RolandMueller1994/ControllerV2/PSU_Prozessor/PSU_Prozessor.csv

Source: | D:\Privat\Circuit_Design\ControllerV2\PSU_Prozessor\PSU_Prozessor.kicad_sch
Date: | 26/09/2022 08:59:41
Tool: | Eeschema (6.0.4)
Generator: | C:\Program Files\KiCad\6.0\bin\scripting\plugins/bom_csv_grouped_by_value.py
Component Count: | 85
Individual Components:
Item | Qty | Reference(s) | Value | LibPart | Footprint | Datasheet | Arrow Part Number | Arrow Price/Stock | Description | Height | Manufacturer_Name | Manufacturer_Part_Number | Mouser Part Number | Mouser Price/Stock
 |  | C1 | 1u | Device:C | Capacitor_SMD:C_1206_3216Metric_Pad1.33x1.80mm_HandSolder | ~
 |  | C2 | 100n | Device:C | Capacitor_SMD:C_1206_3216Metric_Pad1.33x1.80mm_HandSolder | ~
 |  | C3 | 100n | Device:C | Capacitor_SMD:C_1206_3216Metric_Pad1.33x1.80mm_HandSolder | ~
 |  | C4 | 200u | Device:C_Polarized | Capacitor_SMD:CP_Elec_10x10 | ~
 |  | C5 | 2.2u | Device:C | Capacitor_SMD:C_1206_3216Metric_Pad1.33x1.80mm_HandSolder | ~
 |  | C6 | 100n | Device:C | Capacitor_SMD:C_1206_3216Metric_Pad1.33x1.80mm_HandSolder | ~
 |  | C7 | 1u | Device:C | Capacitor_SMD:C_1206_3216Metric_Pad1.33x1.80mm_HandSolder | ~
 |  | C8 | 10u | Device:C | Capacitor_SMD:C_1206_3216Metric_Pad1.33x1.80mm_HandSolder | ~
 |  | C9 | 22u | Device:C | Capacitor_SMD:C_1206_3216Metric_Pad1.33x1.80mm_HandSolder | ~
 |  | C10 | 10u | Device:C | Capacitor_SMD:C_1206_3216Metric_Pad1.33x1.80mm_HandSolder | ~
 |  | C11 | 22u | Device:C | Capacitor_SMD:C_1206_3216Metric_Pad1.33x1.80mm_HandSolder | ~
 |  | C12 | 22u | Device:C | Capacitor_SMD:C_1206_3216Metric_Pad1.33x1.80mm_HandSolder | ~
 |  | C13 | 22u | Device:C | Capacitor_SMD:C_1206_3216Metric_Pad1.33x1.80mm_HandSolder | ~
 |  | C14 | 47u | Device:C_Polarized | Capacitor_SMD:CP_Elec_8x10.5 | ~
 |  | C15 | 100n | Device:C | Capacitor_SMD:C_1206_3216Metric_Pad1.33x1.80mm_HandSolder | ~
 |  | C16 | 150p | Device:C | Capacitor_SMD:C_1206_3216Metric_Pad1.33x1.80mm_HandSolder | ~
 |  | C17 | 47u | Device:C_Polarized | Capacitor_SMD:CP_Elec_8x10.5 | ~
 |  | C18 | 100n | Device:C | Capacitor_SMD:C_1206_3216Metric_Pad1.33x1.80mm_HandSolder | ~
 |  | C19 | 100n | Device:C | Capacitor_SMD:C_1206_3216Metric_Pad1.33x1.80mm_HandSolder | ~
 |  | C20 | 100n | Device:C | Capacitor_SMD:C_1206_3216Metric_Pad1.33x1.80mm_HandSolder | ~
 |  | C21 | 100n | Device:C | Capacitor_SMD:C_1206_3216Metric_Pad1.33x1.80mm_HandSolder | ~
 |  | C22 | 100n | Device:C | Capacitor_SMD:C_1206_3216Metric_Pad1.33x1.80mm_HandSolder | ~
 |  | C23 | 100n | Device:C | Capacitor_SMD:C_1206_3216Metric_Pad1.33x1.80mm_HandSolder | ~
 |  | C24 | 100n | Device:C | Capacitor_SMD:C_1206_3216Metric_Pad1.33x1.80mm_HandSolder | ~
 |  | C25 | 1u | Device:C | Capacitor_SMD:C_1206_3216Metric_Pad1.33x1.80mm_HandSolder | ~
 |  | C26 | 100n | Device:C | Capacitor_SMD:C_1206_3216Metric_Pad1.33x1.80mm_HandSolder | ~
 |  | C27 | 100n | Device:C | Capacitor_SMD:C_1206_3216Metric_Pad1.33x1.80mm_HandSolder | ~
 |  | D1 | 1N4001 | Diode:1N4001 | Diode_THT:D_DO-41_SOD81_P10.16mm_Horizontal | http://www.vishay.com/docs/88503/1n4001.pdf
 |  | D2 | 1N4148 | Diode:1N4148 | Diode_SMD:D_SOD-123 | https://assets.nexperia.com/documents/data-sheet/1N4148_1N4448.pdf
 |  | H1 | MountingHole | Mechanical:MountingHole | MountingHole:MountingHole_3.2mm_M3 | ~
 |  | H2 | MountingHole | Mechanical:MountingHole | MountingHole:MountingHole_3.2mm_M3 | ~
 |  | H3 | MountingHole | Mechanical:MountingHole | MountingHole:MountingHole_3.2mm_M3 | ~
 |  | H4 | MountingHole | Mechanical:MountingHole | MountingHole:MountingHole_3.2mm_M3 | ~
 |  | H5 | MountingHole | Mechanical:MountingHole | MountingHole:MountingHole_3.2mm_M3 | ~
 |  | IC1 | 6N138S | SamacSys_Parts:6N138S | SamacSys_Parts:SOP254P1016X460-8N | https://media.digikey.com/pdf/Data%20Sheets/Lite-On%20PDFs/6N138-39%20Series.pdf | 6N138S | https://www.arrow.com/en/products/6n138s/lite-on-technology?region=nac | High Speed Optocouplers Darlington 100KBd Transistor Output | 4.6 | Lite-On | 6N138S | 859-6N138S | https://www.mouser.co.uk/ProductDetail/Lite-On/6N138S?qs=PByDJ0nQNwpiJNZ8Mk8Kdw%3D%3D
 |  | J1 | ACJS-MHOP | SamacSys_Parts:ACJS-MHOP | SamacSys_Parts:ACJSMHOP | https://www.mouser.dk/datasheet/2/18/55010542000111_acjx-xhop-771297.pdf | ACJS-MHOP | https://www.arrow.com/en/products/acjs-mhop/amphenol-sine-systems?region=nac | 1/4" PHONE TRS OFFSET HORZ PCB P | 12.8 | Amphenol | ACJS-MHOP | 523-ACJS-MHOP | https://www.mouser.co.uk/ProductDetail/Amphenol-Audio/ACJS-MHOP?qs=t8VhaDIDl4taHvIs0dnb2w%3D%3D
 |  | J3 | FC68148S | SamacSys_Parts:FC68148S | FC68148S_2 | http://www.cliffuk.co.uk/products/dcconnectors/FC68148S.pdf |  |  | CLIFF ELECTRONIC COMPONENTS - FC68148S - DC SOCKET, SMD, DC-10AS, 2.1MM PIN |  | CLIFF ELECTRONIC COMPONENTS | FC68148S
 |  | J4 | 1734327-2 | SamacSys_Parts:1734327-2 | SamacSys_Parts:17343272 | https://www.te.com/commerce/DocumentDelivery/DDEController?Action=srchrtrv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 | 1734327-2 | https://www.arrow.com/en/products/1734327-2/te-connectivity?region=nac | USB Connectors Mini A R/A Rcpt SMT | 4.14 | TE Connectivity | 1734327-2 | 571-1734327-2 | https://www.mouser.co.uk/ProductDetail/TE-Connectivity/1734327-2?qs=MP5IOa7hLjVR6N4sgEE7xA%3D%3D
 |  | J7 | 1734327-2 | SamacSys_Parts:1734327-2 | SamacSys_Parts:17343272 | https://www.te.com/commerce/DocumentDelivery/DDEController?Action=srchrtrv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 | 1734327-2 | https://www.arrow.com/en/products/1734327-2/te-connectivity?region=nac | USB Connectors Mini A R/A Rcpt SMT | 4.14 | TE Connectivity | 1734327-2 | 571-1734327-2 | https://www.mouser.co.uk/ProductDetail/TE-Connectivity/1734327-2?qs=MP5IOa7hLjVR6N4sgEE7xA%3D%3D
 |  | J_Display1 | Conn_01x08 | Connector_Generic:Conn_01x08 | Connector_JST:JST_PH_B8B-PH-K_1x08_P2.00mm_Vertical | ~
 |  | J_In1 | SJ-3524-SMT-TR | SamacSys_Parts:SJ-3524-SMT-TR | SamacSys_Parts:SJ-3524-SMT-TR | https://datasheet.datasheetarchive.com/originals/distributors/Datasheets-DGA1/151896.pdf | SJ-3524-SMT-TR | https://www.arrow.com/en/products/sj-3524-smt-tr/cui-devices?region=nac | Phone Connectors Audio Jacks |  | CUI Inc. | SJ-3524-SMT-TR | 490-SJ-3524-SMT-TR | https://www.mouser.co.uk/ProductDetail/CUI-Devices/SJ-3524-SMT-TR?qs=WyjlAZoYn50%252B7OcNbxvx%252BA%3D%3D
 |  | J_Main_Data1 | Conn_01x10 | Connector_Generic:Conn_01x10 | Connector_JST:JST_PH_B10B-PH-K_1x10_P2.00mm_Vertical | ~
 |  | J_Main_Expr1 | Conn_01x02 | Connector_Generic:Conn_01x02 | Connector_JST:JST_PH_B2B-PH-K_1x02_P2.00mm_Vertical | ~
 |  | J_Main_PS1 | Conn_01x06 | Connector_Generic:Conn_01x06 | Connector_JST:JST_PH_B6B-PH-K_1x06_P2.00mm_Vertical | ~
 |  | J_Out1 | SJ-3524-SMT-TR | SamacSys_Parts:SJ-3524-SMT-TR | SamacSys_Parts:SJ-3524-SMT-TR | https://datasheet.datasheetarchive.com/originals/distributors/Datasheets-DGA1/151896.pdf | SJ-3524-SMT-TR | https://www.arrow.com/en/products/sj-3524-smt-tr/cui-devices?region=nac | Phone Connectors Audio Jacks |  | CUI Inc. | SJ-3524-SMT-TR | 490-SJ-3524-SMT-TR | https://www.mouser.co.uk/ProductDetail/CUI-Devices/SJ-3524-SMT-TR?qs=WyjlAZoYn50%252B7OcNbxvx%252BA%3D%3D
 |  | J_Status1 | Conn_01x08 | Connector_Generic:Conn_01x08 | Connector_JST:JST_PH_B8B-PH-K_1x08_P2.00mm_Vertical | ~
 |  | J_Swtich_Lower1 | Conn_01x08 | Connector_Generic:Conn_01x08 | Connector_JST:JST_PH_B8B-PH-K_1x08_P2.00mm_Vertical | ~
 |  | J_Swtich_Lower2 | Conn_01x08 | Connector_Generic:Conn_01x08 | Connector_JST:JST_PH_B8B-PH-K_1x08_P2.00mm_Vertical | ~
 |  | J_Swtich_Upper1 | Conn_01x08 | Connector_Generic:Conn_01x08 | Connector_JST:JST_PH_B8B-PH-K_1x08_P2.00mm_Vertical | ~
 |  | J_Swtich_Upper2 | Conn_01x08 | Connector_Generic:Conn_01x08 | Connector_JST:JST_PH_B8B-PH-K_1x08_P2.00mm_Vertical | ~
 |  | L1 | TCK-146 | SamacSys_Parts:TCK-146 | SamacSys_Parts:TCK147 | https://www.tracopower.com/products/tck146.pdf |  |  | Fixed Inductors Inductor 10uH 1A 350mOhm | 2.6 | Traco Power | TCK-146 | 495-TCK-146 | https://www.mouser.co.uk/ProductDetail/TRACO-Power/TCK-146?qs=w%2Fv1CP2dgqpsTXHMfkVpwg%3D%3D
 |  | L2 | TCK-151 | SamacSys_Parts:TCK-151 | SamacSys_Parts:TCK151 | https://altium.componentsearchengine.com/Datasheets/1/TCK-151.pdf |  |  | Fixed Inductors Inductor 4.7uH 1.2A 140mOhm | 2.6 | Traco Power | TCK-151 | 495-TCK-151 | https://www.mouser.co.uk/ProductDetail/TRACO-Power/TCK-151?qs=r5DSvlrkXmLbmcys%252BIu%252BuA%3D%3D
 |  | MEM1 | Adafruit_Fram_2M | FRam:Adafruit_Fram_2M | FRam:Adafruit_FRam_2M
 |  | PS1 | TRS_2-0923 | SamacSys_Parts:TRS_2-0923 | SamacSys_Parts:TRS20922 | https://tracopower.com/trs2-datasheet/ |  |  | 2 Watt DC/DC converter, industrial, 2:1 input, regulated, compact design, 1600 VDC isolation, encapsulated, SMD package | 8 | Traco Power | TRS 2-0923 | 495-TRS2-0923 | https://www.mouser.co.uk/ProductDetail/TRACO-Power/TRS-2-0923?qs=wUXugUrL1qxaEmb8ePg7Ow%3D%3D
 |  | PS2 | LMO78_05-0.5 | SamacSys_Parts:LMO78_05-0.5 | SamacSys_Parts:LMO78_0505 | https://gaptec-electronic.com/datenblaetter/LMO78_0.5.pdf |  |  | DC DC CONVERTER 5V 4W | 11.5 | Gaptec | LMO78_05-0.5
 |  | PS3 | LMO78_03-0.5 | SamacSys_Parts:LMO78_05-0.5 | SamacSys_Parts:LMO78_0505 | https://gaptec-electronic.com/datenblaetter/LMO78_0.5.pdf |  |  | DC DC CONVERTER 5V 4W | 11.5 | Gaptec | LMO78_05-0.5
 |  | Q1 | BC847 | Transistor_BJT:BC847 | Package_TO_SOT_SMD:SOT-23 | http://www.infineon.com/dgdl/Infineon-BC847SERIES_BC848SERIES_BC849SERIES_BC850SERIES-DS-v01_01-en.pdf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
 |  | Q2 | 2N7002 | Transistor_FET:2N7002 | Package_TO_SOT_SMD:SOT-23 | https://www.onsemi.com/pub/Collateral/NDS7002A-D.PDF
 |  | Q3 | BC847 | Transistor_BJT:BC847 | Package_TO_SOT_SMD:SOT-23 | http://www.infineon.com/dgdl/Infineon-BC847SERIES_BC848SERIES_BC849SERIES_BC850SERIES-DS-v01_01-en.pdf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
 |  | Q4 | 2N7002 | Transistor_FET:2N7002 | Package_TO_SOT_SMD:SOT-23 | https://www.onsemi.com/pub/Collateral/NDS7002A-D.PDF
 |  | Q5 | BC847 | Transistor_BJT:BC847 | Package_TO_SOT_SMD:SOT-23 | http://www.infineon.com/dgdl/Infineon-BC847SERIES_BC848SERIES_BC849SERIES_BC850SERIES-DS-v01_01-en.pdf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
 |  | Q6 | 2N7002 | Transistor_FET:2N7002 | Package_TO_SOT_SMD:SOT-23 | https://www.onsemi.com/pub/Collateral/NDS7002A-D.PDF
 |  | R1 | 33k | Device:R | Resistor_SMD:R_1206_3216Metric_Pad1.30x1.75mm_HandSolder | ~
 |  | R2 | 330 | Device:R | Resistor_SMD:R_1206_3216Metric_Pad1.30x1.75mm_HandSolder | ~
 |  | R3 | 33 | Device:R | Resistor_SMD:R_1206_3216Metric_Pad1.30x1.75mm_HandSolder | ~
 |  | R4 | 10k | Device:R | Resistor_SMD:R_1206_3216Metric_Pad1.30x1.75mm_HandSolder | ~
 |  | R5 | 10 | Device:R | Resistor_SMD:R_1206_3216Metric_Pad1.30x1.75mm_HandSolder | ~
 |  | R6 | 33k | Device:R | Resistor_SMD:R_1206_3216Metric_Pad1.30x1.75mm_HandSolder | ~
 |  | R7 | 330 | Device:R | Resistor_SMD:R_1206_3216Metric_Pad1.30x1.75mm_HandSolder | ~
 |  | R8 | 10k | Device:R | Resistor_SMD:R_1206_3216Metric_Pad1.30x1.75mm_HandSolder | ~
 |  | R9 | 470 | Device:R | Resistor_SMD:R_1206_3216Metric_Pad1.30x1.75mm_HandSolder | ~
 |  | R10 | 33 | Device:R | Resistor_SMD:R_1206_3216Metric_Pad1.30x1.75mm_HandSolder | ~
 |  | R11 | 1k | Device:R | Resistor_SMD:R_1206_3216Metric_Pad1.30x1.75mm_HandSolder | ~
 |  | R12 | 100k | Device:R | Resistor_SMD:R_1206_3216Metric_Pad1.30x1.75mm_HandSolder | ~
 |  | R13 | 100k | Device:R | Resistor_SMD:R_1206_3216Metric_Pad1.30x1.75mm_HandSolder | ~
 |  | R14 | 1k | Device:R | Resistor_SMD:R_1206_3216Metric_Pad1.30x1.75mm_HandSolder | ~
 |  | R15 | 1k | Device:R | Resistor_SMD:R_1206_3216Metric_Pad1.30x1.75mm_HandSolder | ~
 |  | R16 | 33k | Device:R | Resistor_SMD:R_1206_3216Metric_Pad1.30x1.75mm_HandSolder | ~
 |  | R17 | 330 | Device:R | Resistor_SMD:R_1206_3216Metric_Pad1.30x1.75mm_HandSolder | ~
 |  | R18 | 10k | Device:R | Resistor_SMD:R_1206_3216Metric_Pad1.30x1.75mm_HandSolder | ~
 |  | R19 | 100 | Device:R | Resistor_THT:R_Axial_DIN0414_L11.9mm_D4.5mm_P15.24mm_Horizontal | ~
 |  | R20 | 66 | Device:R | Resistor_THT:R_Axial_DIN0414_L11.9mm_D4.5mm_P15.24mm_Horizontal | ~
 |  | U1 | TL072 | Amplifier_Operational:TL072 | SamacSys_Parts:SOIC127P600X175-8N | http://www.ti.com/lit/ds/symlink/tl071.pdf
 |  | U2 | TL072 | Amplifier_Operational:TL072 | SamacSys_Parts:SOIC127P600X175-8N | http://www.ti.com/lit/ds/symlink/tl071.pdf
 |  | XA1 | Arduino_Due_Shield | arduino:Arduino_Due_Shield | Arduino:Arduino_Due_Shield
Collated Components:
Item | Qty | Reference(s) | Value | LibPart | Footprint | Datasheet | Arrow Part Number | Arrow Price/Stock | Description | Height | Manufacturer_Name | Manufacturer_Part_Number | Mouser Part Number | Mouser Price/Stock
1 | 3 | C1, C7, C25 | 1u | Device:C | Capacitor_SMD:C_1206_3216Metric_Pad1.33x1.80mm_HandSolder | ~
2 | 13 | C2, C3, C6, C15, C18, C19, C20, C21, C22, C23, C24, C26, C27 | 100n | Device:C | Capacitor_SMD:C_1206_3216Metric_Pad1.33x1.80mm_HandSolder | ~
3 | 1 | C4 | 200u | Device:C_Polarized | Capacitor_SMD:CP_Elec_10x10 | ~
4 | 1 | C5 | 2.2u | Device:C | Capacitor_SMD:C_1206_3216Metric_Pad1.33x1.80mm_HandSolder | ~
5 | 2 | C8, C10 | 10u | Device:C | Capacitor_SMD:C_1206_3216Metric_Pad1.33x1.80mm_HandSolder | ~
6 | 4 | C9, C11, C12, C13 | 22u | Device:C | Capacitor_SMD:C_1206_3216Metric_Pad1.33x1.80mm_HandSolder | ~
7 | 2 | C14, C17 | 47u | Device:C_Polarized | Capacitor_SMD:CP_Elec_8x10.5 | ~
8 | 1 | C16 | 150p | Device:C | Capacitor_SMD:C_1206_3216Metric_Pad1.33x1.80mm_HandSolder | ~
9 | 1 | D1 | 1N4001 | Diode:1N4001 | Diode_THT:D_DO-41_SOD81_P10.16mm_Horizontal | http://www.vishay.com/docs/88503/1n4001.pdf
10 | 1 | D2 | 1N4148 | Diode:1N4148 | Diode_SMD:D_SOD-123 | https://assets.nexperia.com/documents/data-sheet/1N4148_1N4448.pdf
11 | 5 | H1, H2, H3, H4, H5 | MountingHole | Mechanical:MountingHole | MountingHole:MountingHole_3.2mm_M3 | ~
12 | 1 | IC1 | 6N138S | SamacSys_Parts:6N138S | SamacSys_Parts:SOP254P1016X460-8N | https://media.digikey.com/pdf/Data%20Sheets/Lite-On%20PDFs/6N138-39%20Series.pdf | 6N138S | https://www.arrow.com/en/products/6n138s/lite-on-technology?region=nac | High Speed Optocouplers Darlington 100KBd Transistor Output | 4.6 | Lite-On | 6N138S | 859-6N138S | https://www.mouser.co.uk/ProductDetail/Lite-On/6N138S?qs=PByDJ0nQNwpiJNZ8Mk8Kdw%3D%3D
13 | 1 | J1 | ACJS-MHOP | SamacSys_Parts:ACJS-MHOP | SamacSys_Parts:ACJSMHOP | https://www.mouser.dk/datasheet/2/18/55010542000111_acjx-xhop-771297.pdf | ACJS-MHOP | https://www.arrow.com/en/products/acjs-mhop/amphenol-sine-systems?region=nac | 1/4" PHONE TRS OFFSET HORZ PCB P | 12.8 | Amphenol | ACJS-MHOP | 523-ACJS-MHOP | https://www.mouser.co.uk/ProductDetail/Amphenol-Audio/ACJS-MHOP?qs=t8VhaDIDl4taHvIs0dnb2w%3D%3D
14 | 1 | J3 | FC68148S | SamacSys_Parts:FC68148S | FC68148S_2 | http://www.cliffuk.co.uk/products/dcconnectors/FC68148S.pdf |  |  | CLIFF ELECTRONIC COMPONENTS - FC68148S - DC SOCKET, SMD, DC-10AS, 2.1MM PIN |  | CLIFF ELECTRONIC COMPONENTS | FC68148S
15 | 2 | J4, J7 | 1734327-2 | SamacSys_Parts:1734327-2 | SamacSys_Parts:17343272 | https://www.te.com/commerce/DocumentDelivery/DDEController?Action=srchrtrv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 | 1734327-2 | https://www.arrow.com/en/products/1734327-2/te-connectivity?region=nac | USB Connectors Mini A R/A Rcpt SMT | 4.14 | TE Connectivity | 1734327-2 | 571-1734327-2 | https://www.mouser.co.uk/ProductDetail/TE-Connectivity/1734327-2?qs=MP5IOa7hLjVR6N4sgEE7xA%3D%3D
16 | 6 | J_Display1, J_Status1, J_Swtich_Lower1, J_Swtich_Lower2, J_Swtich_Upper1, J_Swtich_Upper2 | Conn_01x08 | Connector_Generic:Conn_01x08 | Connector_JST:JST_PH_B8B-PH-K_1x08_P2.00mm_Vertical | ~
17 | 2 | J_In1, J_Out1 | SJ-3524-SMT-TR | SamacSys_Parts:SJ-3524-SMT-TR | SamacSys_Parts:SJ-3524-SMT-TR | https://datasheet.datasheetarchive.com/originals/distributors/Datasheets-DGA1/151896.pdf | SJ-3524-SMT-TR | https://www.arrow.com/en/products/sj-3524-smt-tr/cui-devices?region=nac | Phone Connectors Audio Jacks |  | CUI Inc. | SJ-3524-SMT-TR | 490-SJ-3524-SMT-TR | https://www.mouser.co.uk/ProductDetail/CUI-Devices/SJ-3524-SMT-TR?qs=WyjlAZoYn50%252B7OcNbxvx%252BA%3D%3D
18 | 1 | J_Main_Data1 | Conn_01x10 | Connector_Generic:Conn_01x10 | Connector_JST:JST_PH_B10B-PH-K_1x10_P2.00mm_Vertical | ~
19 | 1 | J_Main_Expr1 | Conn_01x02 | Connector_Generic:Conn_01x02 | Connector_JST:JST_PH_B2B-PH-K_1x02_P2.00mm_Vertical | ~
20 | 1 | J_Main_PS1 | Conn_01x06 | Connector_Generic:Conn_01x06 | Connector_JST:JST_PH_B6B-PH-K_1x06_P2.00mm_Vertical | ~
21 | 1 | L1 | TCK-146 | SamacSys_Parts:TCK-146 | SamacSys_Parts:TCK147 | https://www.tracopower.com/products/tck146.pdf |  |  | Fixed Inductors Inductor 10uH 1A 350mOhm | 2.6 | Traco Power | TCK-146 | 495-TCK-146 | https://www.mouser.co.uk/ProductDetail/TRACO-Power/TCK-146?qs=w%2Fv1CP2dgqpsTXHMfkVpwg%3D%3D
22 | 1 | L2 | TCK-151 | SamacSys_Parts:TCK-151 | SamacSys_Parts:TCK151 | https://altium.componentsearchengine.com/Datasheets/1/TCK-151.pdf |  |  | Fixed Inductors Inductor 4.7uH 1.2A 140mOhm | 2.6 | Traco Power | TCK-151 | 495-TCK-151 | https://www.mouser.co.uk/ProductDetail/TRACO-Power/TCK-151?qs=r5DSvlrkXmLbmcys%252BIu%252BuA%3D%3D
23 | 1 | MEM1 | Adafruit_Fram_2M | FRam:Adafruit_Fram_2M | FRam:Adafruit_FRam_2M
24 | 1 | PS1 | TRS_2-0923 | SamacSys_Parts:TRS_2-0923 | SamacSys_Parts:TRS20922 | https://tracopower.com/trs2-datasheet/ |  |  | 2 Watt DC/DC converter, industrial, 2:1 input, regulated, compact design, 1600 VDC isolation, encapsulated, SMD package | 8 | Traco Power | TRS 2-0923 | 495-TRS2-0923 | https://www.mouser.co.uk/ProductDetail/TRACO-Power/TRS-2-0923?qs=wUXugUrL1qxaEmb8ePg7Ow%3D%3D
25 | 1 | PS2 | LMO78_05-0.5 | SamacSys_Parts:LMO78_05-0.5 | SamacSys_Parts:LMO78_0505 | https://gaptec-electronic.com/datenblaetter/LMO78_0.5.pdf |  |  | DC DC CONVERTER 5V 4W | 11.5 | Gaptec | LMO78_05-0.5
26 | 1 | PS3 | LMO78_03-0.5 | SamacSys_Parts:LMO78_05-0.5 | SamacSys_Parts:LMO78_0505 | https://gaptec-electronic.com/datenblaetter/LMO78_0.5.pdf |  |  | DC DC CONVERTER 5V 4W | 11.5 | Gaptec | LMO78_05-0.5
27 | 3 | Q1, Q3, Q5 | BC847 | Transistor_BJT:BC847 | Package_TO_SOT_SMD:SOT-23 | http://www.infineon.com/dgdl/Infineon-BC847SERIES_BC848SERIES_BC849SERIES_BC850SERIES-DS-v01_01-en.pdf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
28 | 3 | Q2, Q4, Q6 | 2N7002 | Transistor_FET:2N7002 | Package_TO_SOT_SMD:SOT-23 | https://www.onsemi.com/pub/Collateral/NDS7002A-D.PDF
29 | 3 | R1, R6, R16 | 33k | Device:R | Resistor_SMD:R_1206_3216Metric_Pad1.30x1.75mm_HandSolder | ~
30 | 3 | R2, R7, R17 | 330 | Device:R | Resistor_SMD:R_1206_3216Metric_Pad1.30x1.75mm_HandSolder | ~
31 | 2 | R3, R10 | 33 | Device:R | Resistor_SMD:R_1206_3216Metric_Pad1.30x1.75mm_HandSolder | ~
32 | 3 | R4, R8, R18 | 10k | Device:R | Resistor_SMD:R_1206_3216Metric_Pad1.30x1.75mm_HandSolder | ~
33 | 1 | R5 | 10 | Device:R | Resistor_SMD:R_1206_3216Metric_Pad1.30x1.75mm_HandSolder | ~
34 | 1 | R9 | 470 | Device:R | Resistor_SMD:R_1206_3216Metric_Pad1.30x1.75mm_HandSolder | ~
35 | 3 | R11, R14, R15 | 1k | Device:R | Resistor_SMD:R_1206_3216Metric_Pad1.30x1.75mm_HandSolder | ~
36 | 2 | R12, R13 | 100k | Device:R | Resistor_SMD:R_1206_3216Metric_Pad1.30x1.75mm_HandSolder | ~
37 | 1 | R19 | 100 | Device:R | Resistor_THT:R_Axial_DIN0414_L11.9mm_D4.5mm_P15.24mm_Horizontal | ~
38 | 1 | R20 | 66 | Device:R | Resistor_THT:R_Axial_DIN0414_L11.9mm_D4.5mm_P15.24mm_Horizontal | ~
39 | 2 | U1, U2 | TL072 | Amplifier_Operational:TL072 | SamacSys_Parts:SOIC127P600X175-8N | http://www.ti.com/lit/ds/symlink/tl071.pdf
40 | 1 | XA1 | Arduino_Due_Shield | arduino:Arduino_Due_Shield | Arduino:Arduino_Due_Shield
