RolandMueller1994/ControllerV2/SwitchPCB/switchpcb_v2_left/switchpcb_v2_left.csv

Source: | D:\Privat\Circuit_Design\ControllerV2\SwitchPCB\switchpcb_v2_left\switchpcb_v2_left.kicad_sch
Date: | 26/09/2022 10:49:08
Tool: | Eeschema (6.0.4)
Generator: | C:\Program Files\KiCad\6.0\bin\scripting\plugins/bom_csv_grouped_by_value.py
Component Count: | 77
Individual Components:
Item | Qty | Reference(s) | Value | LibPart | Footprint | Datasheet
 |  | C1 | 100n | Device:C | Capacitor_SMD:C_1206_3216Metric_Pad1.33x1.80mm_HandSolder | ~
 |  | C2 | 100n | Device:C | Capacitor_SMD:C_1206_3216Metric_Pad1.33x1.80mm_HandSolder | ~
 |  | D_Bl1 | LED | Device:LED | LED_THT:LED_D3.0mm | ~
 |  | D_Bl2 | LED | Device:LED | LED_THT:LED_D3.0mm | ~
 |  | D_Bl3 | LED | Device:LED | LED_THT:LED_D3.0mm | ~
 |  | D_Bl4 | LED | Device:LED | LED_THT:LED_D3.0mm | ~
 |  | D_Ge1 | LED | Device:LED | LED_THT:LED_D3.0mm | ~
 |  | D_Ge2 | LED | Device:LED | LED_THT:LED_D3.0mm | ~
 |  | D_Ge3 | LED | Device:LED | LED_THT:LED_D3.0mm | ~
 |  | D_Ge4 | LED | Device:LED | LED_THT:LED_D3.0mm | ~
 |  | J1 | Conn_01x08 | Connector_Generic:Conn_01x08 | Connector_JST:JST_PH_B8B-PH-K_1x08_P2.00mm_Vertical | ~
 |  | J3 | Conn_01x08 | Connector_Generic:Conn_01x08 | Connector_JST:JST_PH_B8B-PH-K_1x08_P2.00mm_Vertical | ~
 |  | J4 | Conn_01x08 | Connector_Generic:Conn_01x08 | Connector_JST:JST_PH_B8B-PH-K_1x08_P2.00mm_Vertical | ~
 |  | J_SW1 | Conn_01x02 | Connector_Generic:Conn_01x02 | Connector_JST:JST_PH_B2B-PH-K_1x02_P2.00mm_Vertical | ~
 |  | J_SW2 | Conn_01x02 | Connector_Generic:Conn_01x02 | Connector_JST:JST_PH_B2B-PH-K_1x02_P2.00mm_Vertical | ~
 |  | J_SW3 | Conn_01x02 | Connector_Generic:Conn_01x02 | Connector_JST:JST_PH_B2B-PH-K_1x02_P2.00mm_Vertical | ~
 |  | J_SW4 | Conn_01x02 | Connector_Generic:Conn_01x02 | Connector_JST:JST_PH_B2B-PH-K_1x02_P2.00mm_Vertical | ~
 |  | Q1 | 2N7002 | Transistor_FET:2N7002 | Package_TO_SOT_SMD:SOT-23 | https://www.onsemi.com/pub/Collateral/NDS7002A-D.PDF
 |  | Q2 | 2N7002 | Transistor_FET:2N7002 | Package_TO_SOT_SMD:SOT-23 | https://www.onsemi.com/pub/Collateral/NDS7002A-D.PDF
 |  | Q3 | BC847 | Transistor_BJT:BC847 | Package_TO_SOT_SMD:SOT-23 | http://www.infineon.com/dgdl/Infineon-BC847SERIES_BC848SERIES_BC849SERIES_BC850SERIES-DS-v01_01-en.pdf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
 |  | Q4 | BC847 | Transistor_BJT:BC847 | Package_TO_SOT_SMD:SOT-23 | http://www.infineon.com/dgdl/Infineon-BC847SERIES_BC848SERIES_BC849SERIES_BC850SERIES-DS-v01_01-en.pdf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
 |  | Q5 | BC847 | Transistor_BJT:BC847 | Package_TO_SOT_SMD:SOT-23 | http://www.infineon.com/dgdl/Infineon-BC847SERIES_BC848SERIES_BC849SERIES_BC850SERIES-DS-v01_01-en.pdf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
 |  | Q6 | 2N7002 | Transistor_FET:2N7002 | Package_TO_SOT_SMD:SOT-23 | https://www.onsemi.com/pub/Collateral/NDS7002A-D.PDF
 |  | Q7 | BC847 | Transistor_BJT:BC847 | Package_TO_SOT_SMD:SOT-23 | http://www.infineon.com/dgdl/Infineon-BC847SERIES_BC848SERIES_BC849SERIES_BC850SERIES-DS-v01_01-en.pdf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
 |  | Q8 | 2N7002 | Transistor_FET:2N7002 | Package_TO_SOT_SMD:SOT-23 | https://www.onsemi.com/pub/Collateral/NDS7002A-D.PDF
 |  | Q9 | BC847 | Transistor_BJT:BC847 | Package_TO_SOT_SMD:SOT-23 | http://www.infineon.com/dgdl/Infineon-BC847SERIES_BC848SERIES_BC849SERIES_BC850SERIES-DS-v01_01-en.pdf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
 |  | Q10 | 2N7002 | Transistor_FET:2N7002 | Package_TO_SOT_SMD:SOT-23 | https://www.onsemi.com/pub/Collateral/NDS7002A-D.PDF
 |  | Q11 | BC847 | Transistor_BJT:BC847 | Package_TO_SOT_SMD:SOT-23 | http://www.infineon.com/dgdl/Infineon-BC847SERIES_BC848SERIES_BC849SERIES_BC850SERIES-DS-v01_01-en.pdf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
 |  | Q12 | 2N7002 | Transistor_FET:2N7002 | Package_TO_SOT_SMD:SOT-23 | https://www.onsemi.com/pub/Collateral/NDS7002A-D.PDF
 |  | Q13 | BC847 | Transistor_BJT:BC847 | Package_TO_SOT_SMD:SOT-23 | http://www.infineon.com/dgdl/Infineon-BC847SERIES_BC848SERIES_BC849SERIES_BC850SERIES-DS-v01_01-en.pdf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
 |  | Q14 | 2N7002 | Transistor_FET:2N7002 | Package_TO_SOT_SMD:SOT-23 | https://www.onsemi.com/pub/Collateral/NDS7002A-D.PDF
 |  | Q15 | BC847 | Transistor_BJT:BC847 | Package_TO_SOT_SMD:SOT-23 | http://www.infineon.com/dgdl/Infineon-BC847SERIES_BC848SERIES_BC849SERIES_BC850SERIES-DS-v01_01-en.pdf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
 |  | Q16 | 2N7002 | Transistor_FET:2N7002 | Package_TO_SOT_SMD:SOT-23 | https://www.onsemi.com/pub/Collateral/NDS7002A-D.PDF
 |  | Q17 | BC847 | Transistor_BJT:BC847 | Package_TO_SOT_SMD:SOT-23 | http://www.infineon.com/dgdl/Infineon-BC847SERIES_BC848SERIES_BC849SERIES_BC850SERIES-DS-v01_01-en.pdf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
 |  | Q18 | BC847 | Transistor_BJT:BC847 | Package_TO_SOT_SMD:SOT-23 | http://www.infineon.com/dgdl/Infineon-BC847SERIES_BC848SERIES_BC849SERIES_BC850SERIES-DS-v01_01-en.pdf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
 |  | Q19 | 2N7002 | Transistor_FET:2N7002 | Package_TO_SOT_SMD:SOT-23 | https://www.onsemi.com/pub/Collateral/NDS7002A-D.PDF
 |  | Q20 | 2N7002 | Transistor_FET:2N7002 | Package_TO_SOT_SMD:SOT-23 | https://www.onsemi.com/pub/Collateral/NDS7002A-D.PDF
 |  | Q21 | BC847 | Transistor_BJT:BC847 | Package_TO_SOT_SMD:SOT-23 | http://www.infineon.com/dgdl/Infineon-BC847SERIES_BC848SERIES_BC849SERIES_BC850SERIES-DS-v01_01-en.pdf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
 |  | Q22 | BC847 | Transistor_BJT:BC847 | Package_TO_SOT_SMD:SOT-23 | http://www.infineon.com/dgdl/Infineon-BC847SERIES_BC848SERIES_BC849SERIES_BC850SERIES-DS-v01_01-en.pdf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
 |  | Q23 | 2N7002 | Transistor_FET:2N7002 | Package_TO_SOT_SMD:SOT-23 | https://www.onsemi.com/pub/Collateral/NDS7002A-D.PDF
 |  | Q24 | 2N7002 | Transistor_FET:2N7002 | Package_TO_SOT_SMD:SOT-23 | https://www.onsemi.com/pub/Collateral/NDS7002A-D.PDF
 |  | R1 | 330 | Device:R | Resistor_SMD:R_1206_3216Metric_Pad1.30x1.75mm_HandSolder | ~
 |  | R2 | 330 | Device:R | Resistor_SMD:R_1206_3216Metric_Pad1.30x1.75mm_HandSolder | ~
 |  | R3 | 100k | Device:R | Resistor_SMD:R_1206_3216Metric_Pad1.30x1.75mm_HandSolder | ~
 |  | R4 | 100k | Device:R | Resistor_SMD:R_1206_3216Metric_Pad1.30x1.75mm_HandSolder | ~
 |  | R5 | 100k | Device:R | Resistor_SMD:R_1206_3216Metric_Pad1.30x1.75mm_HandSolder | ~
 |  | R6 | 100k | Device:R | Resistor_SMD:R_1206_3216Metric_Pad1.30x1.75mm_HandSolder | ~
 |  | R7 | 330 | Device:R | Resistor_SMD:R_1206_3216Metric_Pad1.30x1.75mm_HandSolder | ~
 |  | R8 | 100k | Device:R | Resistor_SMD:R_1206_3216Metric_Pad1.30x1.75mm_HandSolder | ~
 |  | R9 | 330 | Device:R | Resistor_SMD:R_1206_3216Metric_Pad1.30x1.75mm_HandSolder | ~
 |  | R10 | 100k | Device:R | Resistor_SMD:R_1206_3216Metric_Pad1.30x1.75mm_HandSolder | ~
 |  | R11 | 100k | Device:R | Resistor_SMD:R_1206_3216Metric_Pad1.30x1.75mm_HandSolder | ~
 |  | R12 | 330 | Device:R | Resistor_SMD:R_1206_3216Metric_Pad1.30x1.75mm_HandSolder | ~
 |  | R13 | 100k | Device:R | Resistor_SMD:R_1206_3216Metric_Pad1.30x1.75mm_HandSolder | ~
 |  | R14 | 330 | Device:R | Resistor_SMD:R_1206_3216Metric_Pad1.30x1.75mm_HandSolder | ~
 |  | R15 | 100k | Device:R | Resistor_SMD:R_1206_3216Metric_Pad1.30x1.75mm_HandSolder | ~
 |  | R16 | 100k | Device:R | Resistor_SMD:R_1206_3216Metric_Pad1.30x1.75mm_HandSolder | ~
 |  | R17 | 330 | Device:R | Resistor_SMD:R_1206_3216Metric_Pad1.30x1.75mm_HandSolder | ~
 |  | R18 | 100k | Device:R | Resistor_SMD:R_1206_3216Metric_Pad1.30x1.75mm_HandSolder | ~
 |  | R19 | 330 | Device:R | Resistor_SMD:R_1206_3216Metric_Pad1.30x1.75mm_HandSolder | ~
 |  | R20 | 100k | Device:R | Resistor_SMD:R_1206_3216Metric_Pad1.30x1.75mm_HandSolder | ~
 |  | R21 | 100k | Device:R | Resistor_SMD:R_1206_3216Metric_Pad1.30x1.75mm_HandSolder | ~
 |  | R22 | 330 | Device:R | Resistor_SMD:R_1206_3216Metric_Pad1.30x1.75mm_HandSolder | ~
 |  | R23 | 330 | Device:R | Resistor_SMD:R_1206_3216Metric_Pad1.30x1.75mm_HandSolder | ~
 |  | R24 | 100k | Device:R | Resistor_SMD:R_1206_3216Metric_Pad1.30x1.75mm_HandSolder | ~
 |  | R25 | 100k | Device:R | Resistor_SMD:R_1206_3216Metric_Pad1.30x1.75mm_HandSolder | ~
 |  | R26 | 100k | Device:R | Resistor_SMD:R_1206_3216Metric_Pad1.30x1.75mm_HandSolder | ~
 |  | R27 | 330 | Device:R | Resistor_SMD:R_1206_3216Metric_Pad1.30x1.75mm_HandSolder | ~
 |  | R28 | 330 | Device:R | Resistor_SMD:R_1206_3216Metric_Pad1.30x1.75mm_HandSolder | ~
 |  | R29 | 100k | Device:R | Resistor_SMD:R_1206_3216Metric_Pad1.30x1.75mm_HandSolder | ~
 |  | R30 | 100k | Device:R | Resistor_SMD:R_1206_3216Metric_Pad1.30x1.75mm_HandSolder | ~
 |  | SW1 | Lehle_Switch | KiCad_Libs:Lehle_Switch | KiCad_Libs:LehleSwitch
 |  | SW2 | Lehle_Switch | KiCad_Libs:Lehle_Switch | KiCad_Libs:LehleSwitch
 |  | SW3 | Lehle_Switch | KiCad_Libs:Lehle_Switch | KiCad_Libs:LehleSwitch
 |  | SW4 | Lehle_Switch | KiCad_Libs:Lehle_Switch | KiCad_Libs:LehleSwitch
 |  | U1 | 74HC595 | 74xx:74HC595 | SamacSys_Parts:SOIC127P600X175-16N | http://www.ti.com/lit/ds/symlink/sn74hc595.pdf
 |  | U2 | 74HC595 | 74xx:74HC595 | SamacSys_Parts:SOIC127P600X175-16N | http://www.ti.com/lit/ds/symlink/sn74hc595.pdf
Collated Components:
Item | Qty | Reference(s) | Value | LibPart | Footprint | Datasheet
1 | 2 | C1, C2 | 100n | Device:C | Capacitor_SMD:C_1206_3216Metric_Pad1.33x1.80mm_HandSolder | ~
2 | 8 | D_Bl1, D_Bl2, D_Bl3, D_Bl4, D_Ge1, D_Ge2, D_Ge3, D_Ge4 | LED | Device:LED | LED_THT:LED_D3.0mm | ~
3 | 3 | J1, J3, J4 | Conn_01x08 | Connector_Generic:Conn_01x08 | Connector_JST:JST_PH_B8B-PH-K_1x08_P2.00mm_Vertical | ~
4 | 4 | J_SW1, J_SW2, J_SW3, J_SW4 | Conn_01x02 | Connector_Generic:Conn_01x02 | Connector_JST:JST_PH_B2B-PH-K_1x02_P2.00mm_Vertical | ~
5 | 12 | Q1, Q2, Q6, Q8, Q10, Q12, Q14, Q16, Q19, Q20, Q23, Q24 | 2N7002 | Transistor_FET:2N7002 | Package_TO_SOT_SMD:SOT-23 | https://www.onsemi.com/pub/Collateral/NDS7002A-D.PDF
6 | 12 | Q3, Q4, Q5, Q7, Q9, Q11, Q13, Q15, Q17, Q18, Q21, Q22 | BC847 | Transistor_BJT:BC847 | Package_TO_SOT_SMD:SOT-23 | http://www.infineon.com/dgdl/Infineon-BC847SERIES_BC848SERIES_BC849SERIES_BC850SERIES-DS-v01_01-en.pdf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
7 | 12 | R1, R2, R7, R9, R12, R14, R17, R19, R22, R23, R27, R28 | 330 | Device:R | Resistor_SMD:R_1206_3216Metric_Pad1.30x1.75mm_HandSolder | ~
8 | 18 | R3, R4, R5, R6, R8, R10, R11, R13, R15, R16, R18, R20, R21, R24, R25, R26, R29, R30 | 100k | Device:R | Resistor_SMD:R_1206_3216Metric_Pad1.30x1.75mm_HandSolder | ~
9 | 4 | SW1, SW2, SW3, SW4 | Lehle_Switch | KiCad_Libs:Lehle_Switch | KiCad_Libs:LehleSwitch
10 | 2 | U1, U2 | 74HC595 | 74xx:74HC595 | SamacSys_Parts:SOIC127P600X175-16N | http://www.ti.com/lit/ds/symlink/sn74hc595.pdf
