RolandMueller1994/ControllerV2/ControllerMainV2/ControllerMainV2.kicad_pcb

## KiCad design ControllerMainV2/ControllerMainV2.kicad_pcb (2023-01-03)

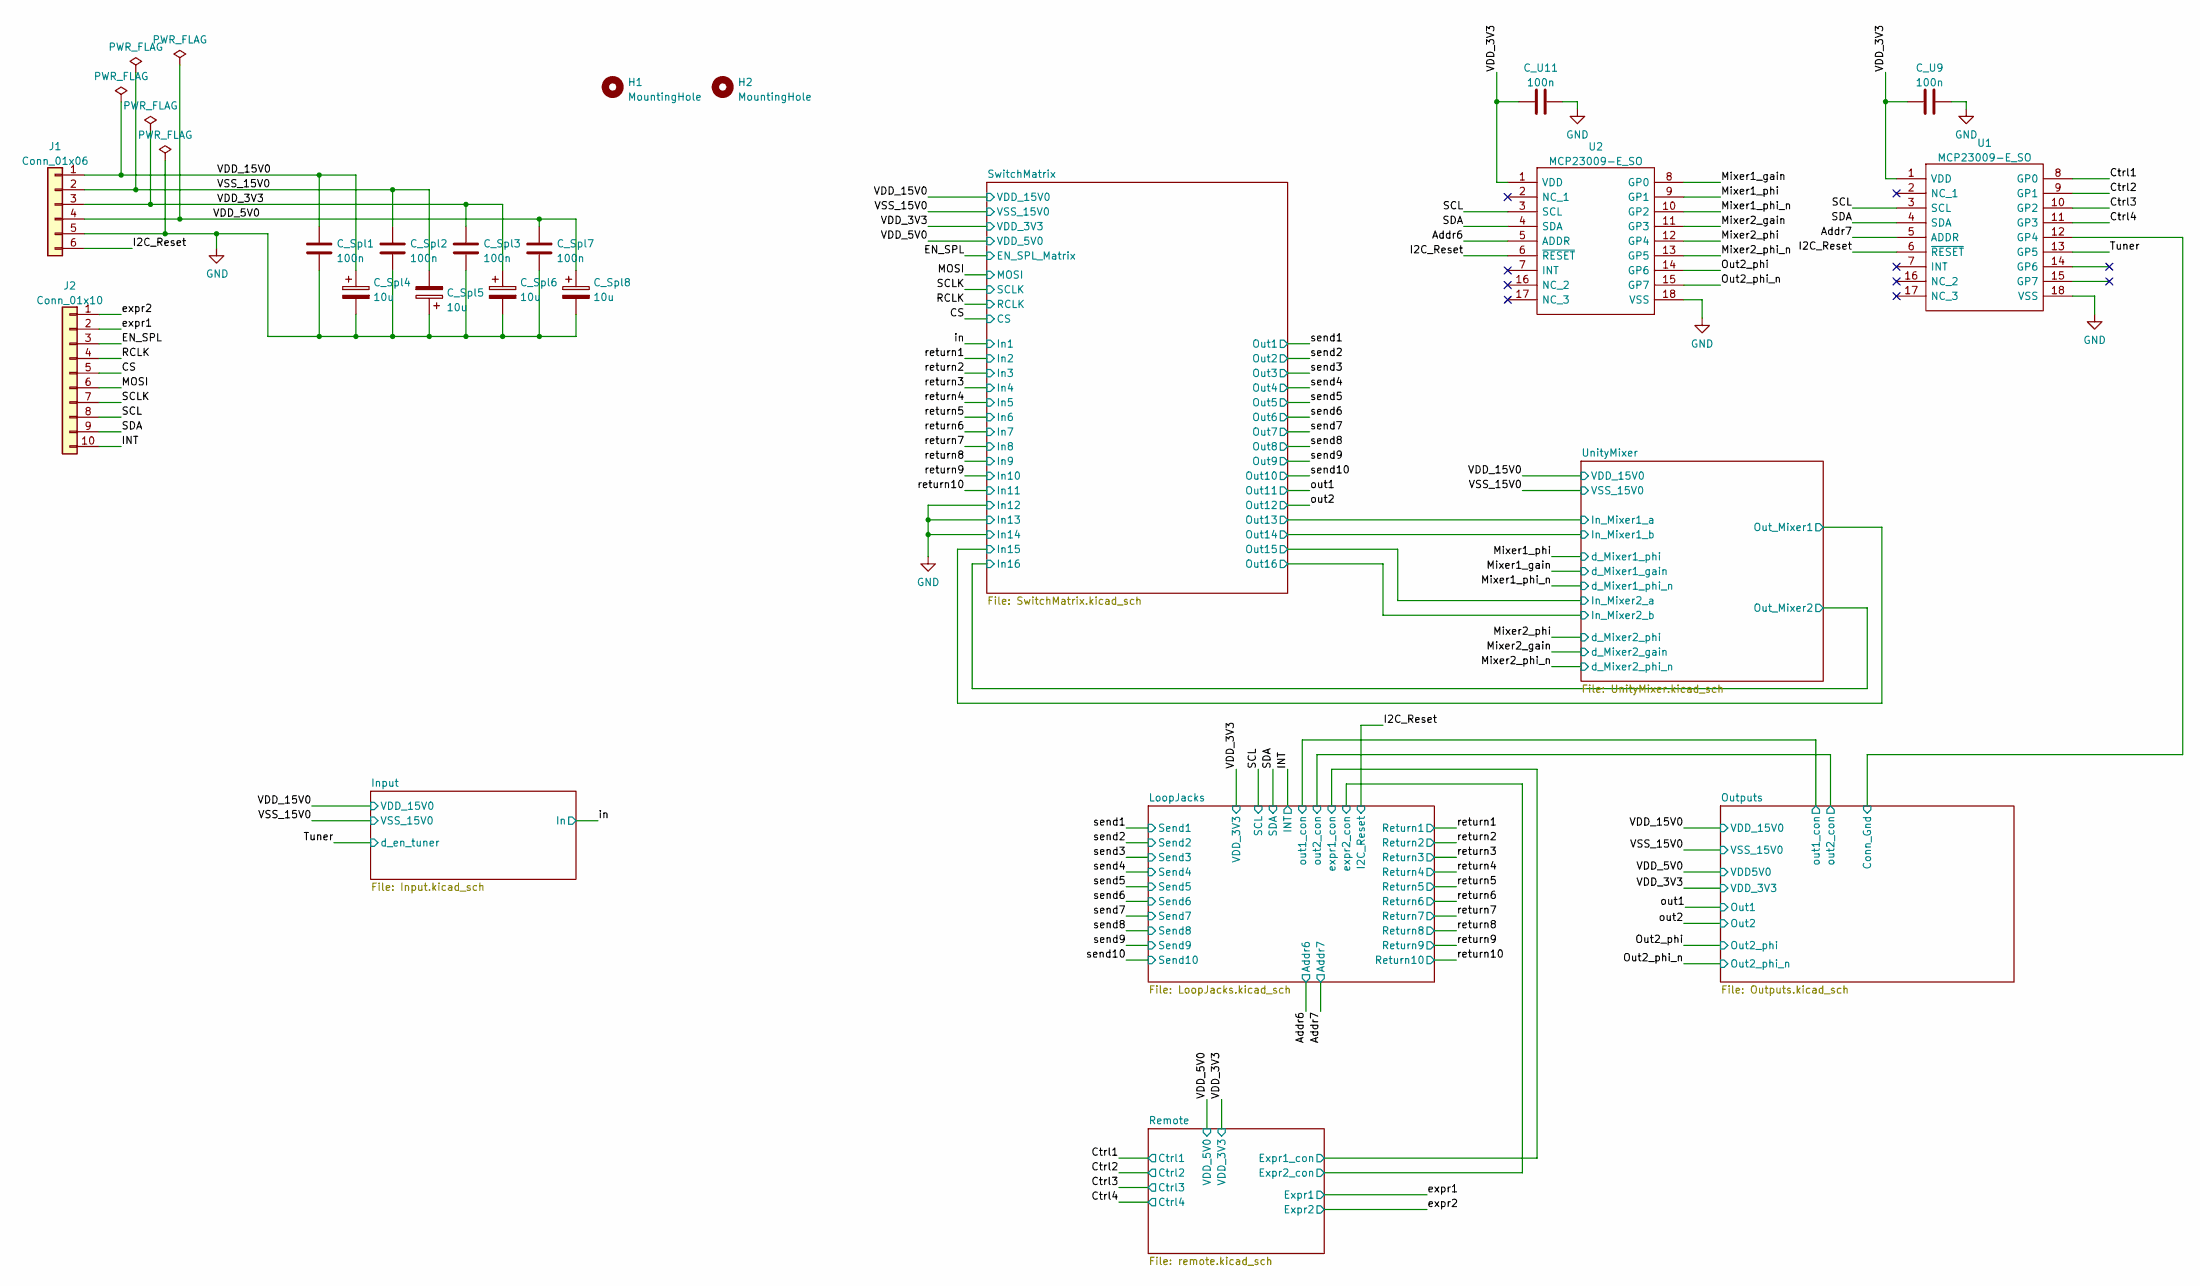
[picture p1: schematic ControllerMainV2.kicad_sch]

Parts:
C_Spl1, C_Spl2, C_Spl3, C_Spl7: 100n; C_1206_3216Metric_Pad1.33x1.80mm_HandSolder
C_Spl4, C_Spl5, C_Spl6, C_Spl8: 10u; C_Elec_4x5.4
C_U9, C_U11: 100n; C_1206_3216Metric_Pad1.33x1.80mm_HandSolder
H1, H2: MountingHole; MountingHole_3.2mm_M3
J1: Conn_01x06; JST_PH_B6B-PH-K_1x06_P2.00mm_Vertical
J2: Conn_01x10; JST_PH_B10B-PH-K_1x10_P2.00mm_Vertical
U1, U2: MCP23009-E_SO; SOIC127P1030X265-18N; Manufacturer_Part_Number MCP23009-E/SO; Mouser Part Number 579-MCP23009-E/SO

Connections:
/Addr6: U2.5 (ADDR); also elsewhere on the board
/Addr7: U1.5 (ADDR); also elsewhere on the board
/CS: J2.5; also elsewhere on the board
/Ctrl1: U1.8 (GP0); also elsewhere on the board
/Ctrl2: U1.9 (GP1); also elsewhere on the board
/Ctrl3: U1.10 (GP2); also elsewhere on the board
/Ctrl4: U1.11 (GP3); also elsewhere on the board
/EN_SPL: J2.3; also elsewhere on the board
/I2C_Reset: J1.6, U1.6 (~RESET), U2.6 (~RESET); also elsewhere on the board
/INT: J2.10; also elsewhere on the board
/MOSI: J2.6; also elsewhere on the board
/Mixer1_gain: U2.8 (GP0); also elsewhere on the board
/Mixer1_phi: U2.9 (GP1); also elsewhere on the board
/Mixer1_phi_n: U2.10 (GP2); also elsewhere on the board
/Mixer2_gain: U2.11 (GP3); also elsewhere on the board
/Mixer2_phi: U2.12 (GP4); also elsewhere on the board
/Mixer2_phi_n: U2.13 (GP5); also elsewhere on the board
/Out2_phi: U2.14 (GP6); also elsewhere on the board
/Out2_phi_n: U2.15 (GP7); also elsewhere on the board
/Outputs/Conn_Gnd: U1.12 (GP4); also elsewhere on the board
/RCLK: J2.4; also elsewhere on the board
/SCL: J2.8, U1.3 (SCL), U2.3 (SCL); also elsewhere on the board
/SCLK: J2.7; also elsewhere on the board
/SDA: J2.9, U1.4 (SDA), U2.4 (SDA); also elsewhere on the board
/Tuner: U1.13 (GP5); also elsewhere on the board
/VDD_3V3: C_Spl3.1, C_Spl6.1, C_U9.1, C_U11.1, J1.3, U1.1 (VDD), U2.1 (VDD); also elsewhere on the board
/VDD_5V0: C_Spl7.1, C_Spl8.1, J1.4; also elsewhere on the board
/VDD_15V0: C_Spl1.1, C_Spl4.1, J1.1; also elsewhere on the board
/VSS_15V0: C_Spl2.1, C_Spl5.2, J1.2; also elsewhere on the board
/expr1: J2.2; also elsewhere on the board
/expr2: J2.1; also elsewhere on the board
GND: C_Spl1.2, C_Spl2.2, C_Spl3.2, C_Spl4.2, C_Spl5.1, C_Spl6.2, C_Spl7.2, C_Spl8.2, C_U9.2, C_U11.2, J1.5, U1.18 (VSS), U2.18 (VSS); also elsewhere on the board

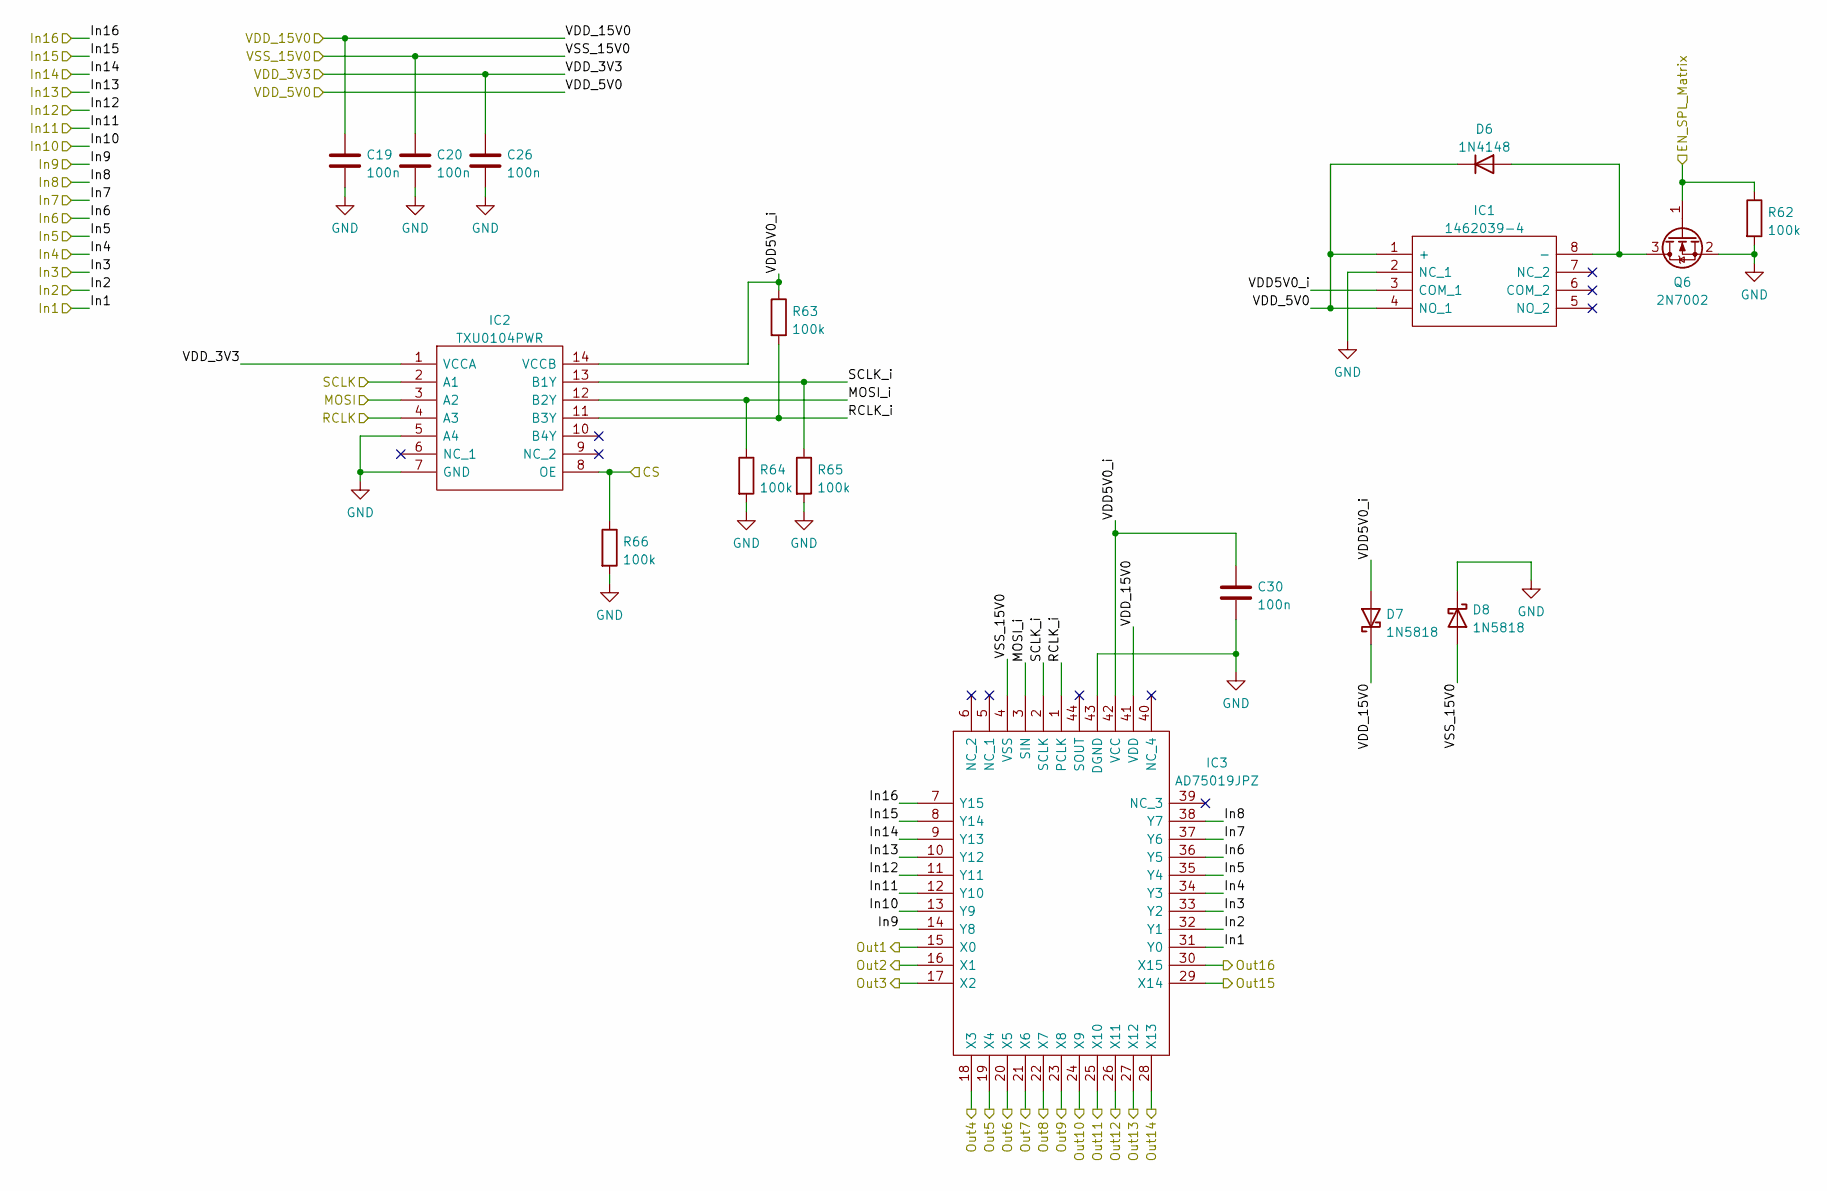
[picture p2: schematic SwitchMatrix.kicad_sch]

Parts:
C19, C20, C26, C30: 100n; C_1206_3216Metric_Pad1.33x1.80mm_HandSolder
D6: 1N4148; D_SOD-123
D7, D8: 1N5818; D_SOD-123
IC1: 1462039-4; 14620394; Manufacturer_Part_Number 1462039-4; Mouser Part Number 655-1462039-4
IC2: TXU0104PWR; SOP65P640X120-14N; Manufacturer_Part_Number TXU0104PWR; Mouser Part Number 595-TXU0104PWR
IC3: AD75019JPZ; PLCC-44_SMD-Socket; Manufacturer_Part_Number AD75019JPZ; Mouser Part Number 584-AD75019JPZ
Q6: 2N7002; SOT-23
R62, R63, R64, R65, R66: 100k; R_1206_3216Metric_Pad1.30x1.75mm_HandSolder

Connections:
/CS: IC2.8 (OE), R66.1; also elsewhere on the board
/EN_SPL: Q6.1 (G), R62.1; also elsewhere on the board
/MOSI: IC2.3 (A2); also elsewhere on the board
/RCLK: IC2.4 (A3); also elsewhere on the board
/SCLK: IC2.2 (A1); also elsewhere on the board
/SwitchMatrix/In15: IC3.8 (Y14); also elsewhere on the board
/SwitchMatrix/In16: IC3.7 (Y15); also elsewhere on the board
/SwitchMatrix/MOSI_i: IC2.12 (B2Y), IC3.3 (SIN), R64.1
/SwitchMatrix/Out13: IC3.27 (X12); also elsewhere on the board
/SwitchMatrix/Out14: IC3.28 (X13); also elsewhere on the board
/SwitchMatrix/Out15: IC3.29 (X14); also elsewhere on the board
/SwitchMatrix/Out16: IC3.30 (X15); also elsewhere on the board
/SwitchMatrix/RCLK_i: IC2.11 (B3Y), IC3.1 (PCLK), R63.2
/SwitchMatrix/SCLK_i: IC2.13 (B1Y), IC3.2 (SCLK), R65.1
/SwitchMatrix/VDD5V0_i: C30.1, D7.2 (A), IC1.3 (COM_1), IC2.14 (VCCB), IC3.42 (VCC), R63.1
/VDD_3V3: C26.1, IC2.1 (VCCA); also elsewhere on the board
/VDD_5V0: D6.1 (K), IC1.1 (+), IC1.4 (NO_1); also elsewhere on the board
/VDD_15V0: C19.1, D7.1 (K), IC3.41 (VDD); also elsewhere on the board
/VSS_15V0: C20.1, D8.2 (A), IC3.4 (VSS); also elsewhere on the board
/in: IC3.31 (Y0); also elsewhere on the board
/out1: IC3.25 (X10); also elsewhere on the board
/out2: IC3.26 (X11); also elsewhere on the board
/return1: IC3.32 (Y1); also elsewhere on the board
/return2: IC3.33 (Y2); also elsewhere on the board
/return3: IC3.34 (Y3); also elsewhere on the board
/return4: IC3.35 (Y4); also elsewhere on the board
/return5: IC3.36 (Y5); also elsewhere on the board
/return6: IC3.37 (Y6); also elsewhere on the board
/return7: IC3.38 (Y7); also elsewhere on the board
/return8: IC3.14 (Y8); also elsewhere on the board
/return9: IC3.13 (Y9); also elsewhere on the board
/return10: IC3.12 (Y10); also elsewhere on the board
/send1: IC3.15 (X0); also elsewhere on the board
/send2: IC3.16 (X1); also elsewhere on the board
/send3: IC3.17 (X2); also elsewhere on the board
/send4: IC3.18 (X3); also elsewhere on the board
/send5: IC3.19 (X4); also elsewhere on the board
/send6: IC3.20 (X5); also elsewhere on the board
/send7: IC3.21 (X6); also elsewhere on the board
/send8: IC3.22 (X7); also elsewhere on the board
/send9: IC3.23 (X8); also elsewhere on the board
/send10: IC3.24 (X9); also elsewhere on the board
GND: C19.2, C20.2, C26.2, C30.2, D8.1 (K), IC1.2 (NC_1), IC2.5 (A4), IC2.7 (GND), IC3.9 (Y13), IC3.10 (Y12), IC3.11 (Y11), IC3.43 (DGND), Q6.2 (S), R62.2, R64.2, R65.2, R66.2; also elsewhere on the board
unnamed: D6.2 (A), IC1.8 (-), Q6.3 (D)

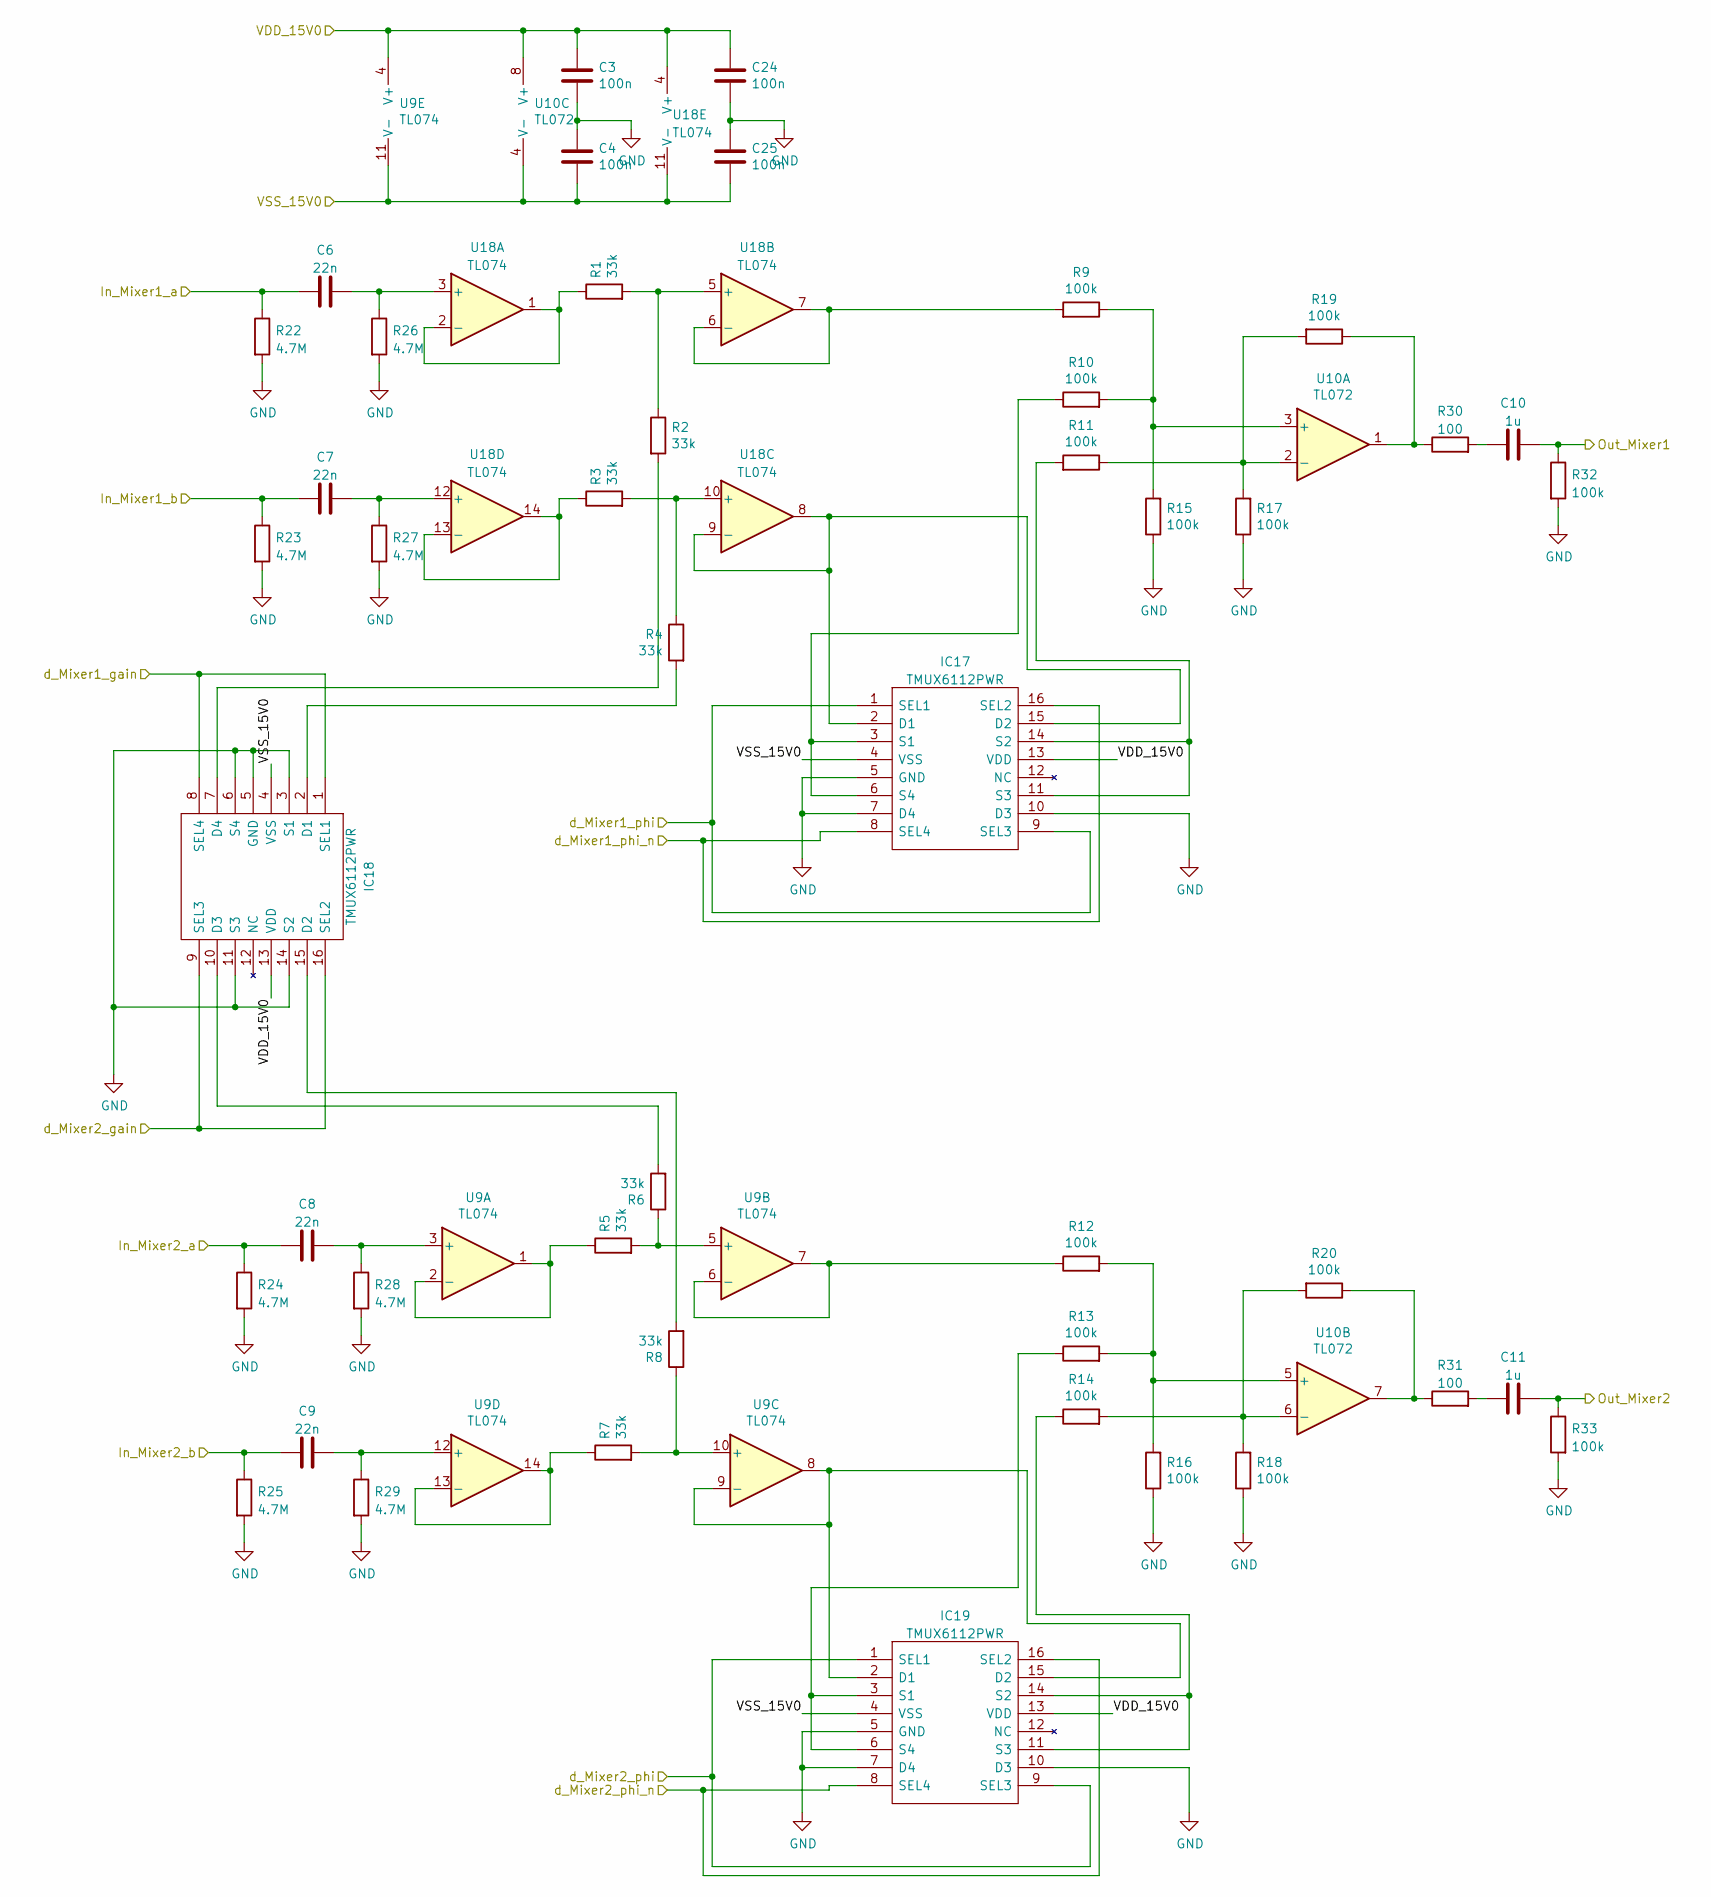
[picture p3: schematic UnityMixer.kicad_sch]

Parts:
C3, C4, C24, C25: 100n; C_1206_3216Metric_Pad1.33x1.80mm_HandSolder
C6, C7, C8, C9: 22n; C_1206_3216Metric_Pad1.33x1.80mm_HandSolder
C10, C11: 1u; C_1206_3216Metric_Pad1.33x1.80mm_HandSolder
IC17, IC18, IC19: TMUX6112PWR; SOP65P640X120-16N; Manufacturer_Part_Number TMUX6112PWR; Mouser Part Number 595-TMUX6112PWR
R1, R2, R3, R4, R5, R6, R7, R8: 33k; R_1206_3216Metric_Pad1.30x1.75mm_HandSolder
R9, R10, R11, R12, R13, R14, R15, R16, R17, R18, R19, R20, R32, R33: 100k; R_1206_3216Metric_Pad1.30x1.75mm_HandSolder
R22, R23, R24, R25, R26, R27, R28, R29: 4.7M; R_1206_3216Metric_Pad1.30x1.75mm_HandSolder
R30, R31: 100; R_1206_3216Metric_Pad1.30x1.75mm_HandSolder
U9, U18: TL074; SOIC127P600X175-14N
U10: TL072; SOIC127P600X175-8N

Connections:
/Mixer1_gain: IC18.1 (SEL1), IC18.8 (SEL4); also elsewhere on the board
/Mixer1_phi: IC17.1 (SEL1), IC17.9 (SEL3); also elsewhere on the board
/Mixer1_phi_n: IC17.8 (SEL4), IC17.16 (SEL2); also elsewhere on the board
/Mixer2_gain: IC18.9 (SEL3), IC18.16 (SEL2); also elsewhere on the board
/Mixer2_phi: IC19.1 (SEL1), IC19.9 (SEL3); also elsewhere on the board
/Mixer2_phi_n: IC19.8 (SEL4), IC19.16 (SEL2); also elsewhere on the board
/SwitchMatrix/In15: C10.2, R32.1; also elsewhere on the board
/SwitchMatrix/In16: C11.2, R33.1; also elsewhere on the board
/SwitchMatrix/Out13: C6.1, R22.1; also elsewhere on the board
/SwitchMatrix/Out14: C7.1, R23.1; also elsewhere on the board
/SwitchMatrix/Out15: C8.1, R24.1; also elsewhere on the board
/SwitchMatrix/Out16: C9.1, R25.1; also elsewhere on the board
/VDD_15V0: C3.1, C24.1, IC17.13 (VDD), IC18.13 (VDD), IC19.13 (VDD), U9.4 (V+), U10.8 (V+), U18.4 (V+); also elsewhere on the board
/VSS_15V0: C4.2, C25.2, IC17.4 (VSS), IC18.4 (VSS), IC19.4 (VSS), U9.11 (V-), U10.4 (V-), U18.11 (V-); also elsewhere on the board
GND: C3.2, C4.1, C24.2, C25.1, IC17.5 (GND), IC17.7 (D4), IC17.10 (D3), IC18.3 (S1), IC18.5 (GND), IC18.6 (S4), IC18.11 (S3), IC18.14 (S2), IC19.5 (GND), IC19.7 (D4), IC19.10 (D3), R15.1, R16.1, R17.1, R18.1, R22.2, R23.2, R24.2, R25.2, R26.2, R27.2, R28.2, R29.2, R32.2, R33.2; also elsewhere on the board
unnamed: C6.2, R26.1, U18.3 (+)
unnamed: C7.2, R27.1, U18.12 (+)
unnamed: C8.2, R28.1, U9.3 (+)
unnamed: C9.2, R29.1, U9.12 (+)
unnamed: C10.1, R30.2
unnamed: C11.1, R31.2
unnamed: IC17.3 (S1), IC17.6 (S4), R10.1
unnamed: IC17.11 (S3), IC17.14 (S2), R11.2
unnamed: IC17.2 (D1), IC17.15 (D2), U18.8, U18.9 (-)
unnamed: IC18.2 (D1), R4.2
unnamed: IC18.7 (D4), R2.2
unnamed: IC18.10 (D3), R6.2
unnamed: IC18.15 (D2), R8.2
unnamed: IC19.3 (S1), IC19.6 (S4), R13.1
unnamed: IC19.11 (S3), IC19.14 (S2), R14.1
unnamed: IC19.2 (D1), IC19.15 (D2), U9.8, U9.9 (-)
unnamed: R1.1, U18.1, U18.2 (-)
unnamed: R1.2, R2.1, U18.5 (+)
unnamed: R3.1, U18.13 (-), U18.14
unnamed: R3.2, R4.1, U18.10 (+)
unnamed: R5.1, U9.1, U9.2 (-)
unnamed: R5.2, R6.1, U9.5 (+)
unnamed: R7.1, U9.13 (-), U9.14
unnamed: R7.2, R8.1, U9.10 (+)
unnamed: R9.2, U18.6 (-), U18.7
unnamed: R9.1, R10.2, R15.2, U10.3 (+)
unnamed: R11.1, R17.2, R19.2, U10.2 (-)
unnamed: R12.1, U9.6 (-), U9.7
unnamed: R12.2, R13.2, R16.2, U10.5 (+)
unnamed: R14.2, R18.2, R20.2, U10.6 (-)
unnamed: R19.1, R30.1, U10.1
unnamed: R20.1, R31.1, U10.7

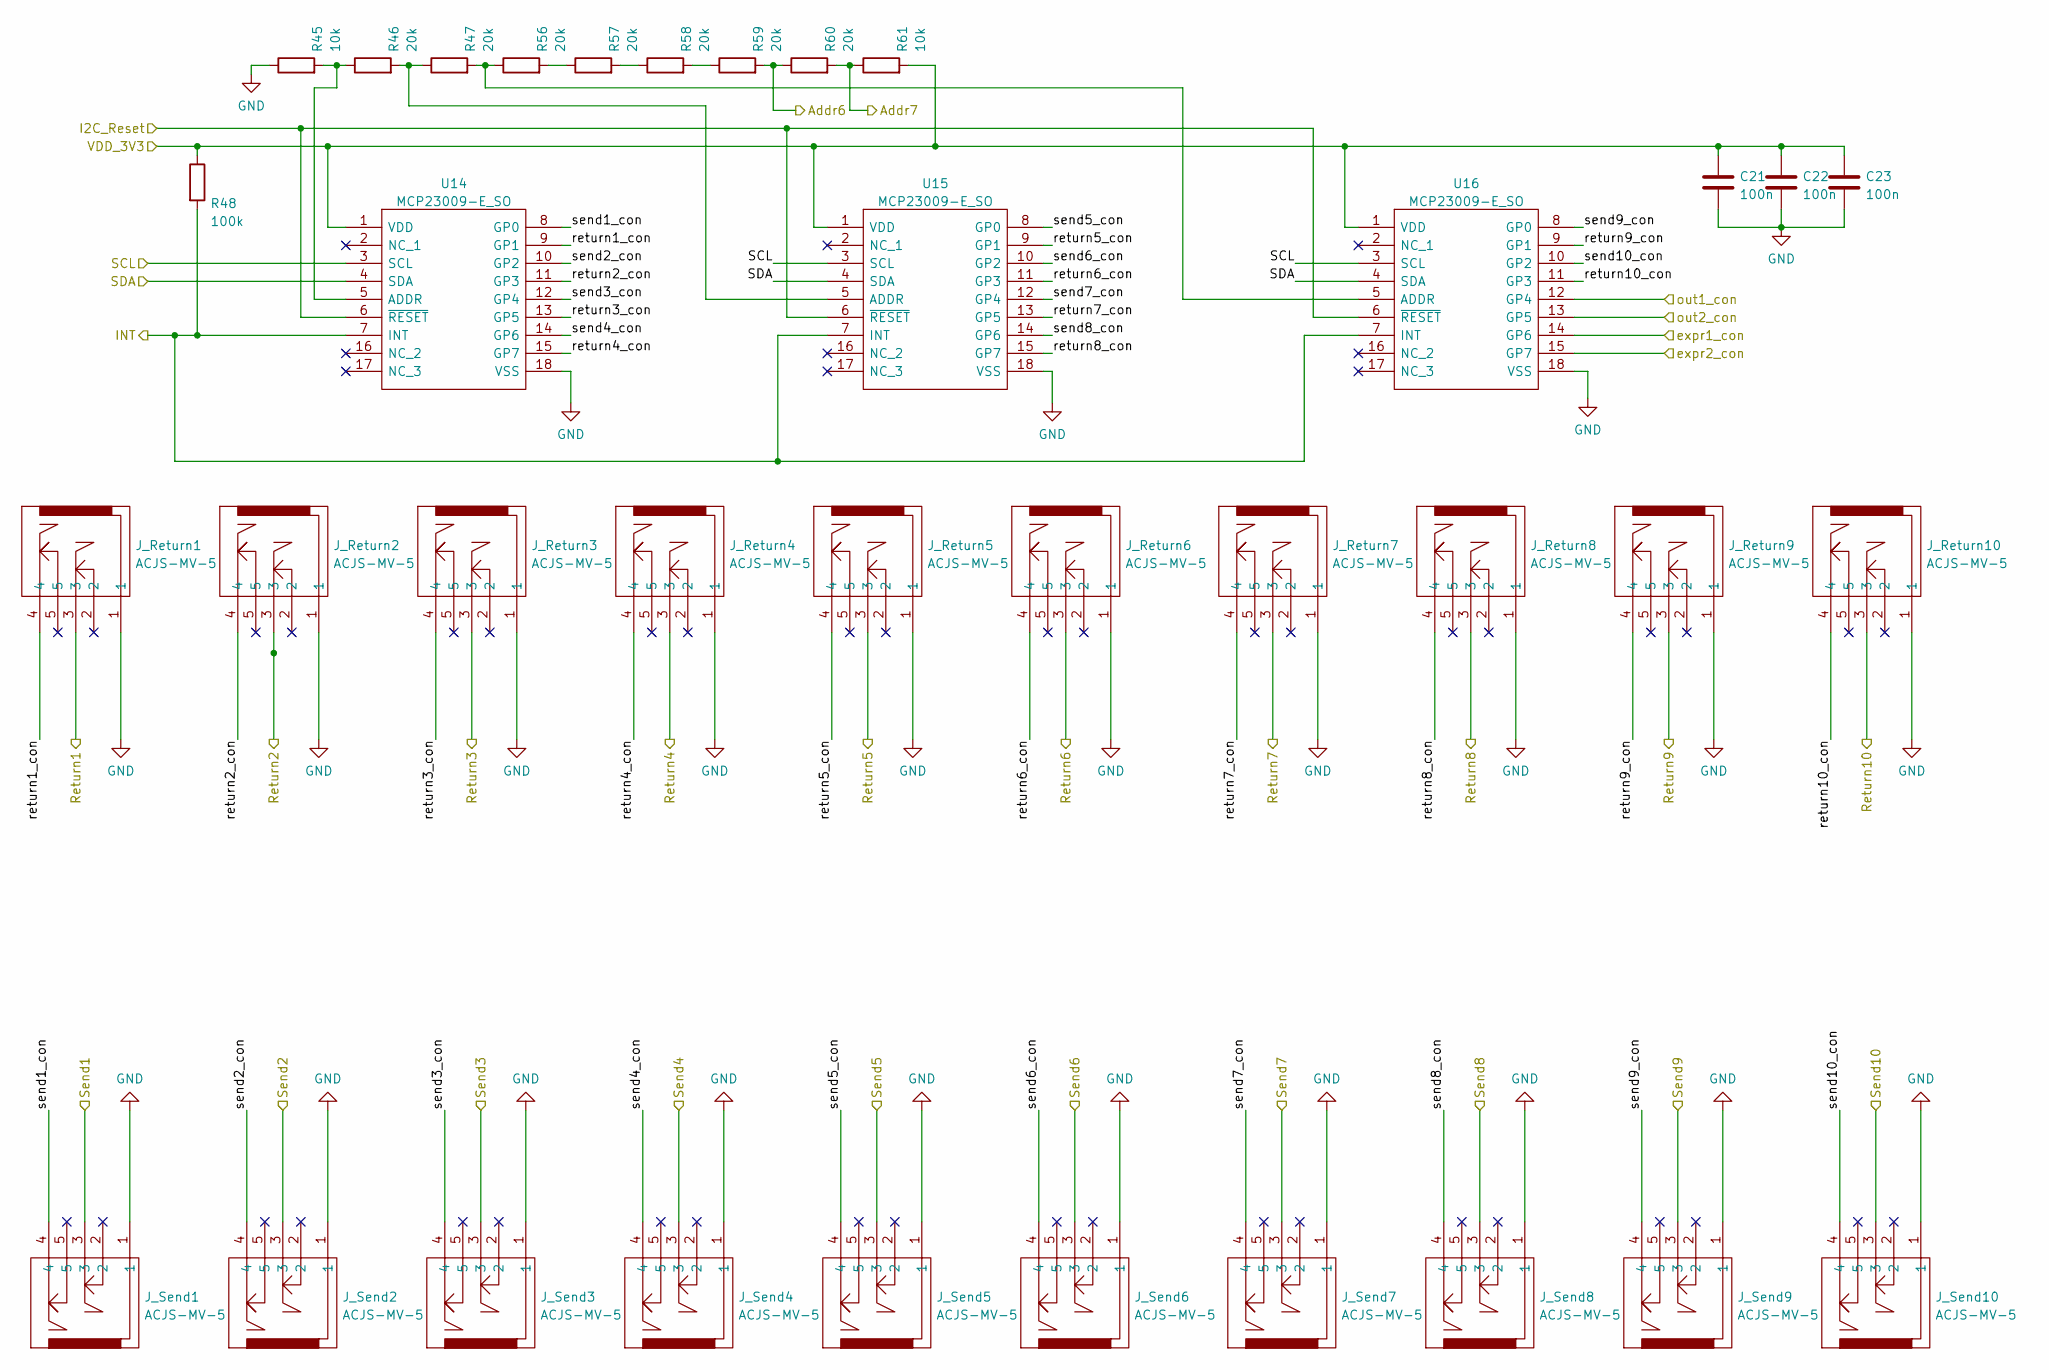
[picture p4: schematic LoopJacks.kicad_sch]

Parts:
C21, C22, C23: 100n; C_1206_3216Metric_Pad1.33x1.80mm_HandSolder
J_Return1, J_Return2, J_Return3, J_Return4, J_Return5, J_Return6, J_Return7, J_Return8, J_Return9, J_Return10: ACJS-MV-5; ACJSMV5; Manufacturer_Part_Number ACJS-MV-5; Mouser Part Number 523-ACJS-MV-5
J_Send1, J_Send2, J_Send3, J_Send4, J_Send5, J_Send6, J_Send7, J_Send8, J_Send9, J_Send10: ACJS-MV-5; ACJSMV5; Manufacturer_Part_Number ACJS-MV-5; Mouser Part Number 523-ACJS-MV-5
R45, R61: 10k; R_1206_3216Metric_Pad1.30x1.75mm_HandSolder
R46, R47, R56, R57, R58, R59, R60: 20k; R_1206_3216Metric_Pad1.30x1.75mm_HandSolder
R48: 100k; R_1206_3216Metric_Pad1.30x1.75mm_HandSolder
U14, U15, U16: MCP23009-E_SO; SOIC127P1030X265-18N; Manufacturer_Part_Number MCP23009-E/SO; Mouser Part Number 579-MCP23009-E/SO

Connections:
/Addr6: R59.2, R60.1; also elsewhere on the board
/Addr7: R60.2, R61.1; also elsewhere on the board
/I2C_Reset: U14.6 (~RESET), U15.6 (~RESET), U16.6 (~RESET); also elsewhere on the board
/INT: R48.2, U14.7 (INT), U15.7 (INT), U16.7 (INT); also elsewhere on the board
/LoopJacks/expr1_con: U16.14 (GP6); also elsewhere on the board
/LoopJacks/expr2_con: U16.15 (GP7); also elsewhere on the board
/LoopJacks/out1_con: U16.12 (GP4); also elsewhere on the board
/LoopJacks/out2_con: U16.13 (GP5); also elsewhere on the board
/LoopJacks/return1_con: J_Return1.4, U14.9 (GP1)
/LoopJacks/return2_con: J_Return2.4, U14.11 (GP3)
/LoopJacks/return3_con: J_Return3.4, U14.13 (GP5)
/LoopJacks/return4_con: J_Return4.4, U14.15 (GP7)
/LoopJacks/return5_con: J_Return5.4, U15.9 (GP1)
/LoopJacks/return6_con: J_Return6.4, U15.11 (GP3)
/LoopJacks/return7_con: J_Return7.4, U15.13 (GP5)
/LoopJacks/return8_con: J_Return8.4, U15.15 (GP7)
/LoopJacks/return9_con: J_Return9.4, U16.9 (GP1)
/LoopJacks/return10_con: J_Return10.4, U16.11 (GP3)
/LoopJacks/send1_con: J_Send1.4, U14.8 (GP0)
/LoopJacks/send2_con: J_Send2.4, U14.10 (GP2)
/LoopJacks/send3_con: J_Send3.4, U14.12 (GP4)
/LoopJacks/send4_con: J_Send4.4, U14.14 (GP6)
/LoopJacks/send5_con: J_Send5.4, U15.8 (GP0)
/LoopJacks/send6_con: J_Send6.4, U15.10 (GP2)
/LoopJacks/send7_con: J_Send7.4, U15.12 (GP4)
/LoopJacks/send8_con: J_Send8.4, U15.14 (GP6)
/LoopJacks/send9_con: J_Send9.4, U16.8 (GP0)
/LoopJacks/send10_con: J_Send10.4, U16.10 (GP2)
/SCL: U14.3 (SCL), U15.3 (SCL), U16.3 (SCL); also elsewhere on the board
/SDA: U14.4 (SDA), U15.4 (SDA), U16.4 (SDA); also elsewhere on the board
/VDD_3V3: C21.1, C22.1, C23.1, R48.1, R61.2, U14.1 (VDD), U15.1 (VDD), U16.1 (VDD); also elsewhere on the board
/return1: J_Return1.3; also elsewhere on the board
/return2: J_Return2.3; also elsewhere on the board
/return3: J_Return3.3; also elsewhere on the board
/return4: J_Return4.3; also elsewhere on the board
/return5: J_Return5.3; also elsewhere on the board
/return6: J_Return6.3; also elsewhere on the board
/return7: J_Return7.3; also elsewhere on the board
/return8: J_Return8.3; also elsewhere on the board
/return9: J_Return9.3; also elsewhere on the board
/return10: J_Return10.3; also elsewhere on the board
/send1: J_Send1.3; also elsewhere on the board
/send2: J_Send2.3; also elsewhere on the board
/send3: J_Send3.3; also elsewhere on the board
/send4: J_Send4.3; also elsewhere on the board
/send5: J_Send5.3; also elsewhere on the board
/send6: J_Send6.3; also elsewhere on the board
/send7: J_Send7.3; also elsewhere on the board
/send8: J_Send8.3; also elsewhere on the board
/send9: J_Send9.3; also elsewhere on the board
/send10: J_Send10.3; also elsewhere on the board
GND: C21.2, C22.2, C23.2, J_Return1.1, J_Return2.1, J_Return3.1, J_Return4.1, J_Return5.1, J_Return6.1, J_Return7.1, J_Return8.1, J_Return9.1, J_Return10.1, J_Send1.1, J_Send2.1, J_Send3.1, J_Send4.1, J_Send5.1, J_Send6.1, J_Send7.1, J_Send8.1, J_Send9.1, J_Send10.1, R45.1, U14.18 (VSS), U15.18 (VSS), U16.18 (VSS); also elsewhere on the board
unnamed: R45.2, R46.1, U14.5 (ADDR)
unnamed: R46.2, R47.1, U15.5 (ADDR)
unnamed: R47.2, R56.1, U16.5 (ADDR)
unnamed: R56.2, R57.1
unnamed: R57.2, R58.1
unnamed: R58.2, R59.1

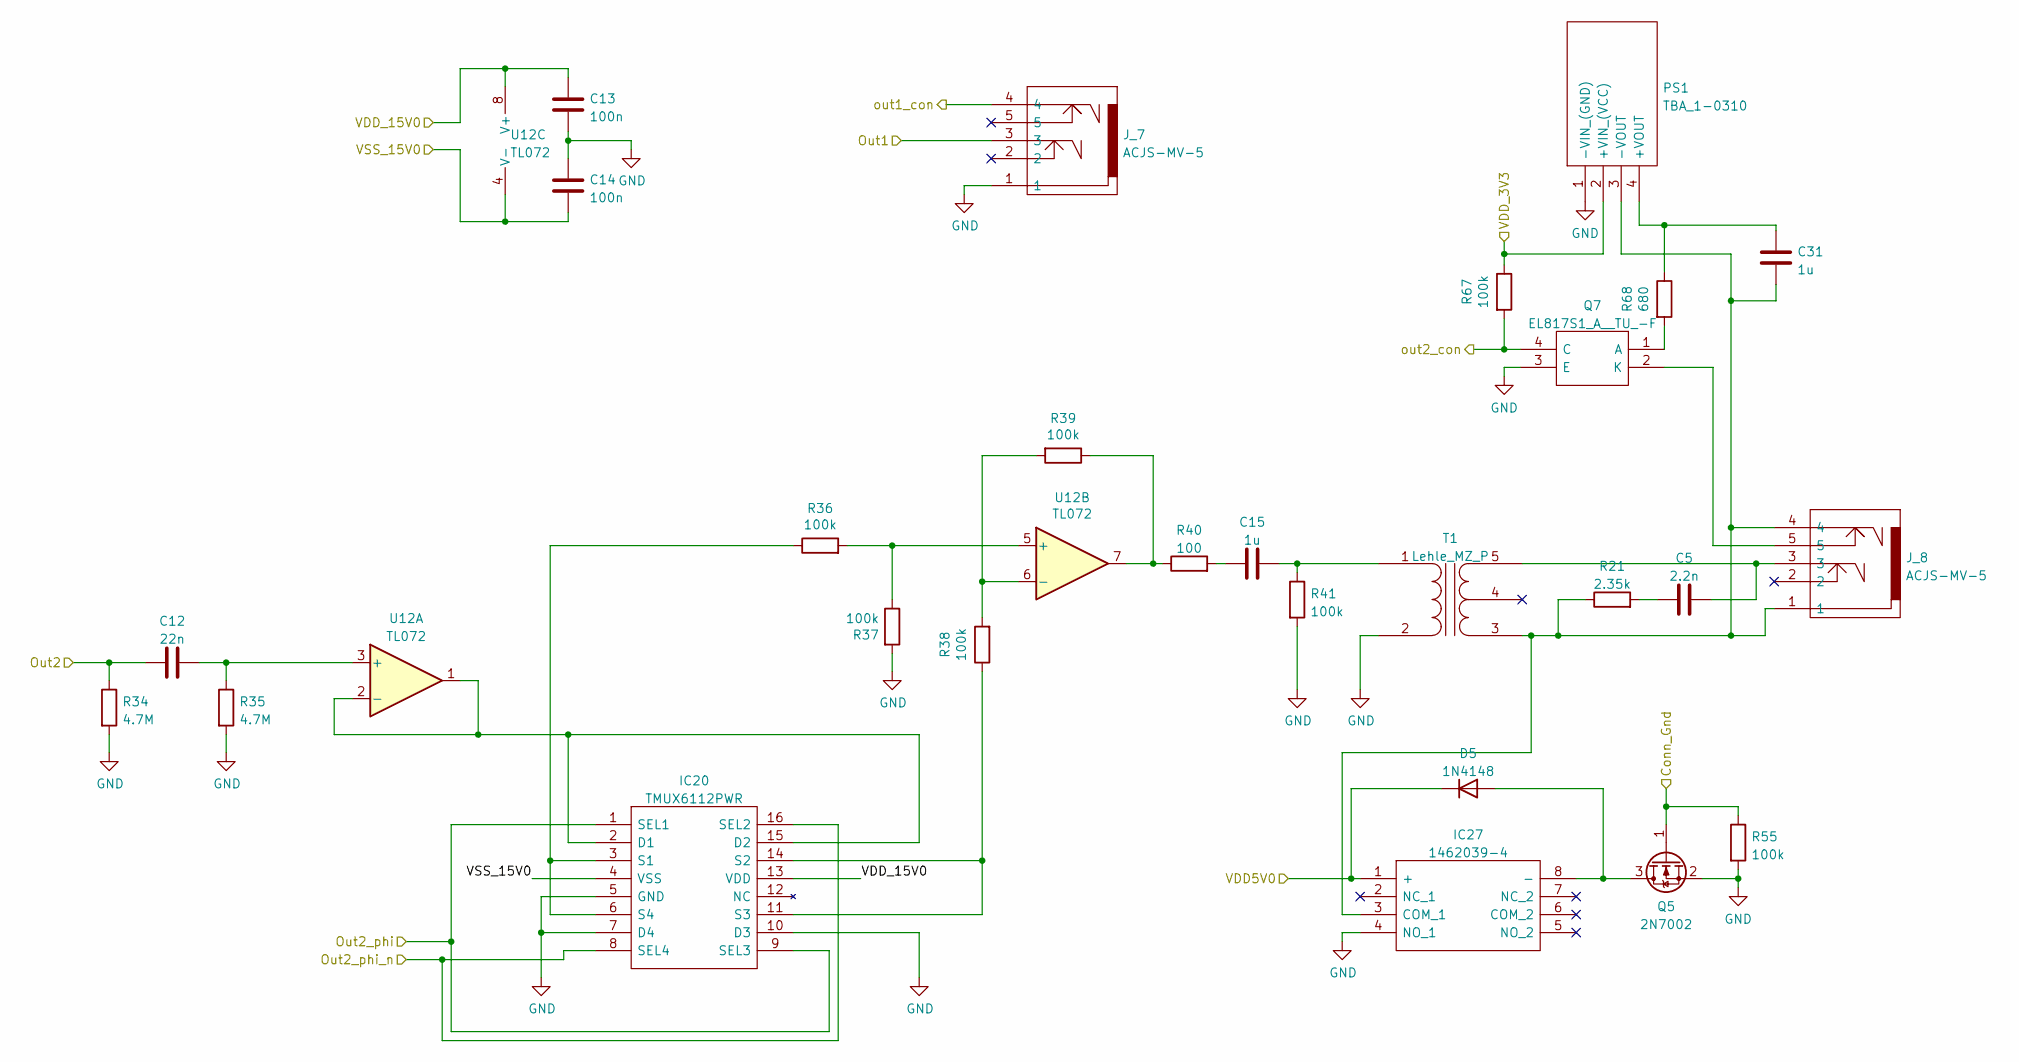
[picture p5: schematic Outputs.kicad_sch]

Parts:
C5: 2.2n; C_1206_3216Metric_Pad1.33x1.80mm_HandSolder
C12: 22n; C_1206_3216Metric_Pad1.33x1.80mm_HandSolder
C13, C14: 100n; C_1206_3216Metric_Pad1.33x1.80mm_HandSolder
C15, C31: 1u; C_1206_3216Metric_Pad1.33x1.80mm_HandSolder
D5: 1N4148; D_SOD-123
IC20: TMUX6112PWR; SOP65P640X120-16N; Manufacturer_Part_Number TMUX6112PWR; Mouser Part Number 595-TMUX6112PWR
IC27: 1462039-4; 14620394; Manufacturer_Part_Number 1462039-4; Mouser Part Number 655-1462039-4
J_7, J_8: ACJS-MV-5; ACJSMV5; Manufacturer_Part_Number ACJS-MV-5; Mouser Part Number 523-ACJS-MV-5
PS1: TBA_1-0310; TBA1; Manufacturer_Part_Number TBA 1-0310; Mouser Part Number 495-TBA1-0310
Q5: 2N7002; SOT-23
Q7: EL817S1_A__TU_-F; SOP254P1030X390-4N; Manufacturer_Part_Number EL817S1(A)(TU)-F
R21: 2.35k; R_1206_3216Metric_Pad1.30x1.75mm_HandSolder
R34, R35: 4.7M; R_1206_3216Metric_Pad1.30x1.75mm_HandSolder
R36, R37, R38, R39, R41, R55, R67: 100k; R_1206_3216Metric_Pad1.30x1.75mm_HandSolder
R40: 100; R_1206_3216Metric_Pad1.30x1.75mm_HandSolder
R68: 680; R_1206_3216Metric_Pad1.30x1.75mm_HandSolder
T1: Lehle_MZ_P
U12: TL072; SOIC127P600X175-8N

Connections:
/LoopJacks/out1_con: J_7.4; also elsewhere on the board
/LoopJacks/out2_con: Q7.4 (C), R67.2; also elsewhere on the board
/Out2_phi: IC20.1 (SEL1), IC20.9 (SEL3); also elsewhere on the board
/Out2_phi_n: IC20.8 (SEL4), IC20.16 (SEL2); also elsewhere on the board
/Outputs/Conn_Gnd: Q5.1 (G), R55.1; also elsewhere on the board
/VDD_3V3: PS1.2 (+VIN_(VCC)), R67.1; also elsewhere on the board
/VDD_5V0: D5.1 (K), IC27.1 (+); also elsewhere on the board
/VDD_15V0: C13.2, IC20.13 (VDD), U12.8 (V+); also elsewhere on the board
/VSS_15V0: C14.1, IC20.4 (VSS), U12.4 (V-); also elsewhere on the board
/out1: J_7.3; also elsewhere on the board
/out2: C12.1, R34.1; also elsewhere on the board
GND: C13.1, C14.2, IC20.5 (GND), IC20.7 (D4), IC20.10 (D3), IC27.4 (NO_1), J_7.1, PS1.1 (-VIN_(GND)), Q5.2 (S), Q7.3 (E), R34.2, R35.2, R37.2, R41.2, R55.2, T1.2 (AB); also elsewhere on the board
unnamed: C5.1, J_8.3, T1.5 (SB)
unnamed: C5.2, R21.2
unnamed: C12.2, R35.1, U12.3 (+)
unnamed: C15.1, R40.2
unnamed: C15.2, R41.1, T1.1 (AA)
unnamed: C31.1, IC27.3 (COM_1), J_8.1, J_8.4, PS1.3 (-VOUT), R21.1, T1.3 (SA)
unnamed: C31.2, PS1.4 (+VOUT), R68.1
unnamed: D5.2 (A), IC27.8 (-), Q5.3 (D)
unnamed: IC20.3 (S1), IC20.6 (S4), R36.1
unnamed: IC20.11 (S3), IC20.14 (S2), R38.1
unnamed: IC20.2 (D1), IC20.15 (D2), U12.1, U12.2 (-)
unnamed: J_8.5, Q7.2 (K)
unnamed: Q7.1 (A), R68.2
unnamed: R36.2, R37.1, U12.5 (+)
unnamed: R38.2, R39.2, U12.6 (-)
unnamed: R39.1, R40.1, U12.7
