RolandMueller1994/ControllerV2/ControllerMainV2/ControllerMainV2.kicad_pcb

## KiCad design ControllerMainV2/ControllerMainV2.kicad_pcb (continued)

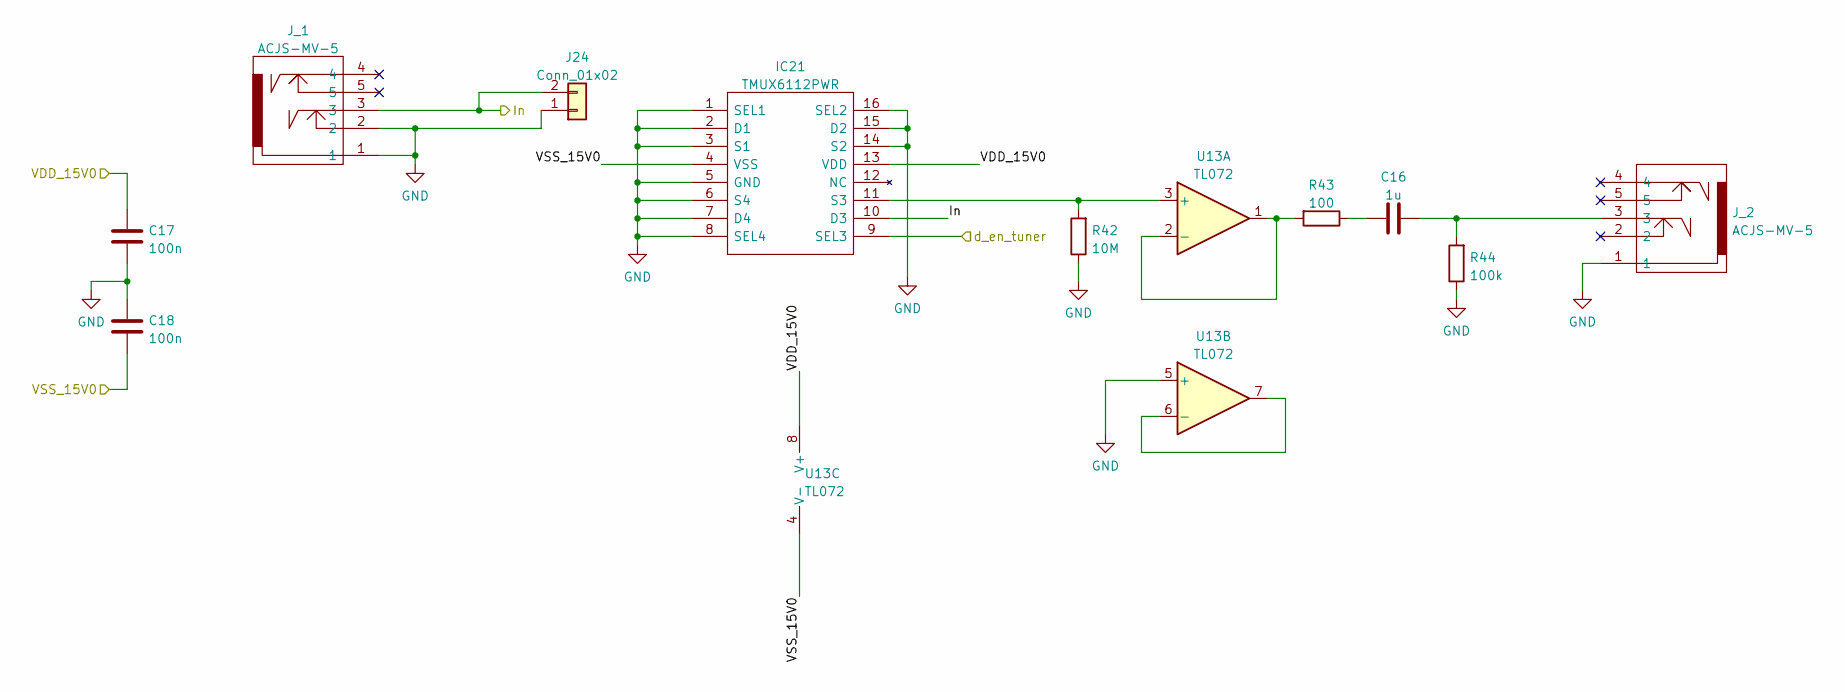
[picture p6: schematic Input.kicad_sch]

Parts:
C16: 1u; C_1206_3216Metric_Pad1.33x1.80mm_HandSolder
C17, C18: 100n; C_1206_3216Metric_Pad1.33x1.80mm_HandSolder
IC21: TMUX6112PWR; SOP65P640X120-16N; Manufacturer_Part_Number TMUX6112PWR; Mouser Part Number 595-TMUX6112PWR
J24: Conn_01x02; PinSocket_1x02_P2.54mm_Vertical
J_1, J_2: ACJS-MV-5; ACJSMV5; Manufacturer_Part_Number ACJS-MV-5; Mouser Part Number 523-ACJS-MV-5
R42: 10M; R_1206_3216Metric_Pad1.30x1.75mm_HandSolder
R43: 100; R_1206_3216Metric_Pad1.30x1.75mm_HandSolder
R44: 100k; R_1206_3216Metric_Pad1.30x1.75mm_HandSolder
U13: TL072; SOIC127P600X175-8N

Connections:
/Tuner: IC21.9 (SEL3); also elsewhere on the board
/VDD_15V0: C17.2, IC21.13 (VDD), U13.8 (V+); also elsewhere on the board
/VSS_15V0: C18.1, IC21.4 (VSS), U13.4 (V-); also elsewhere on the board
/in: IC21.10 (D3), J24.2, J_1.3; also elsewhere on the board
GND: C17.1, C18.2, IC21.1 (SEL1), IC21.2 (D1), IC21.3 (S1), IC21.5 (GND), IC21.6 (S4), IC21.7 (D4), IC21.8 (SEL4), IC21.14 (S2), IC21.15 (D2), IC21.16 (SEL2), J24.1, J_1.1, J_1.2, J_2.1, R42.1, R44.1, U13.5 (+); also elsewhere on the board
unnamed: C16.1, R43.1
unnamed: C16.2, J_2.3, R44.2
unnamed: IC21.11 (S3), R42.2, U13.3 (+)
unnamed: R43.2, U13.1, U13.2 (-)
unnamed: U13.6 (-), U13.7

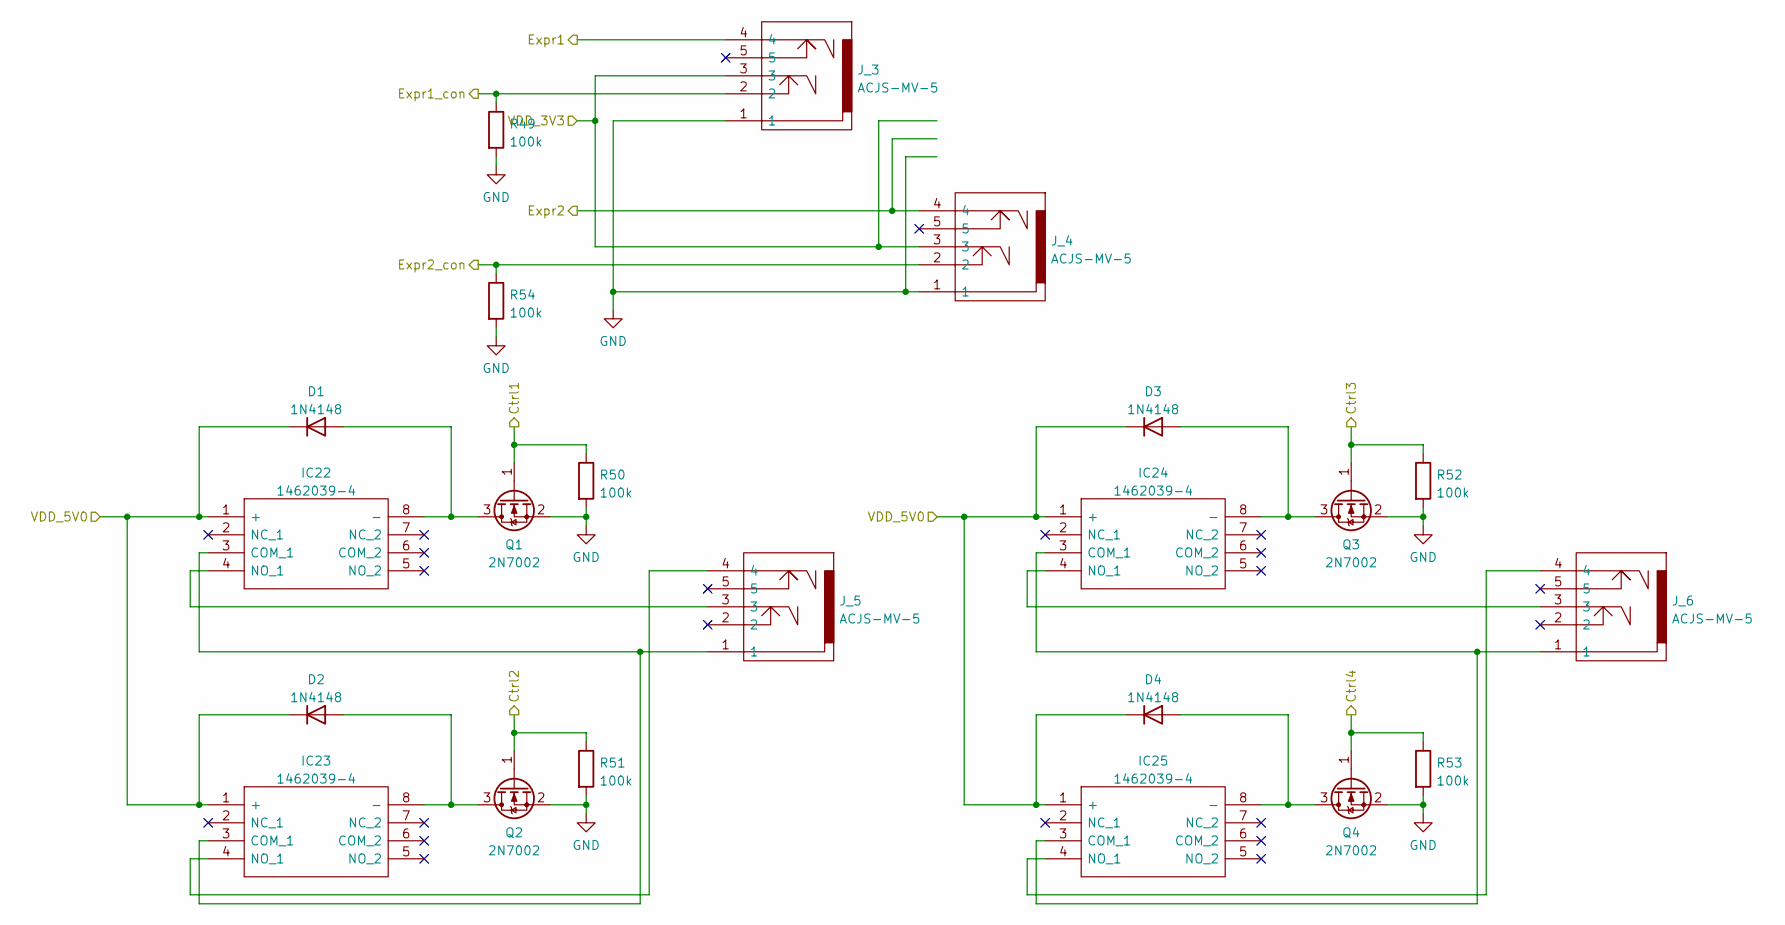
[picture p7: schematic remote.kicad_sch]

Parts:
D1, D2, D3, D4: 1N4148; D_SOD-123
IC22, IC23, IC24, IC25: 1462039-4; 14620394; Manufacturer_Part_Number 1462039-4; Mouser Part Number 655-1462039-4
J_3, J_4, J_5, J_6: ACJS-MV-5; ACJSMV5; Manufacturer_Part_Number ACJS-MV-5; Mouser Part Number 523-ACJS-MV-5
Q1, Q2, Q3, Q4: 2N7002; SOT-23
R49, R50, R51, R52, R53, R54: 100k; R_1206_3216Metric_Pad1.30x1.75mm_HandSolder

Connections:
/Ctrl1: Q1.1 (G), R50.1; also elsewhere on the board
/Ctrl2: Q2.1 (G), R51.1; also elsewhere on the board
/Ctrl3: Q3.1 (G), R52.1; also elsewhere on the board
/Ctrl4: Q4.1 (G), R53.1; also elsewhere on the board
/LoopJacks/expr1_con: J_3.2, R49.1; also elsewhere on the board
/LoopJacks/expr2_con: J_4.2, R54.1; also elsewhere on the board
/VDD_3V3: J_3.3, J_4.3; also elsewhere on the board
/VDD_5V0: D1.1 (K), D2.1 (K), D3.1 (K), D4.1 (K), IC22.1 (+), IC23.1 (+), IC24.1 (+), IC25.1 (+); also elsewhere on the board
/expr1: J_3.4; also elsewhere on the board
/expr2: J_4.4; also elsewhere on the board
GND: J_3.1, J_4.1, Q1.2 (S), Q2.2 (S), Q3.2 (S), Q4.2 (S), R49.2, R50.2, R51.2, R52.2, R53.2, R54.2; also elsewhere on the board
unnamed: D1.2 (A), IC22.8 (-), Q1.3 (D)
unnamed: D2.2 (A), IC23.8 (-), Q2.3 (D)
unnamed: D3.2 (A), IC24.8 (-), Q3.3 (D)
unnamed: D4.2 (A), IC25.8 (-), Q4.3 (D)
unnamed: IC22.3 (COM_1), IC23.3 (COM_1), J_5.1
unnamed: IC22.4 (NO_1), J_5.3
unnamed: IC23.4 (NO_1), J_5.4
unnamed: IC24.3 (COM_1), IC25.3 (COM_1), J_6.1
unnamed: IC24.4 (NO_1), J_6.3
unnamed: IC25.4 (NO_1), J_6.4

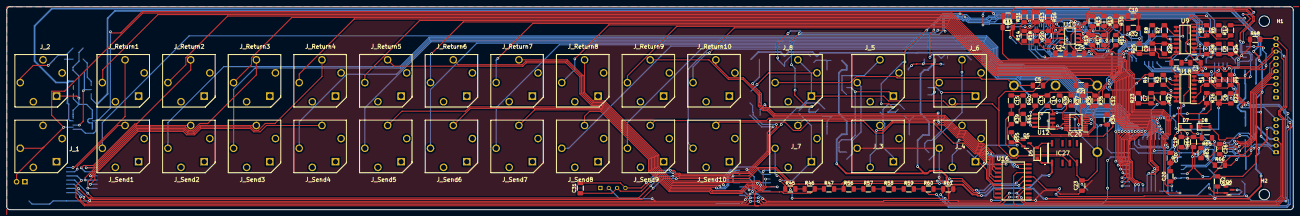
[picture p8: board ControllerMainV2.kicad_pcb from above]

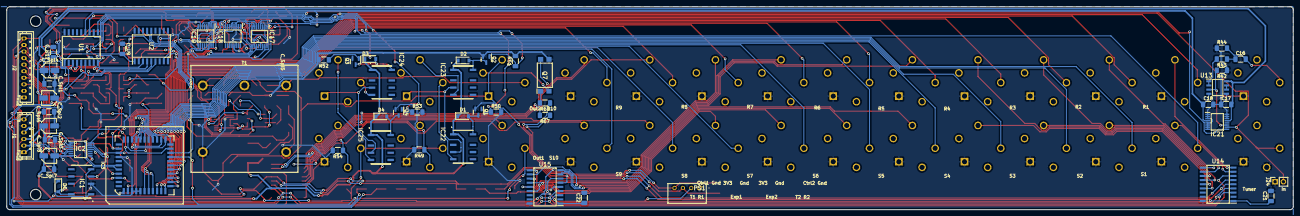
[picture p9: board ControllerMainV2.kicad_pcb from below]

Board: 2 copper layers, 392.0 x 61.8 mm, 177 parts (57 on the bottom side), 159 nets.
