RolandMueller1994/ControllerV2/PSU_Prozessor/PSU_Prozessor.kicad_pcb

## KiCad design PSU_Prozessor/PSU_Prozessor.kicad_pcb (2022-12-29)

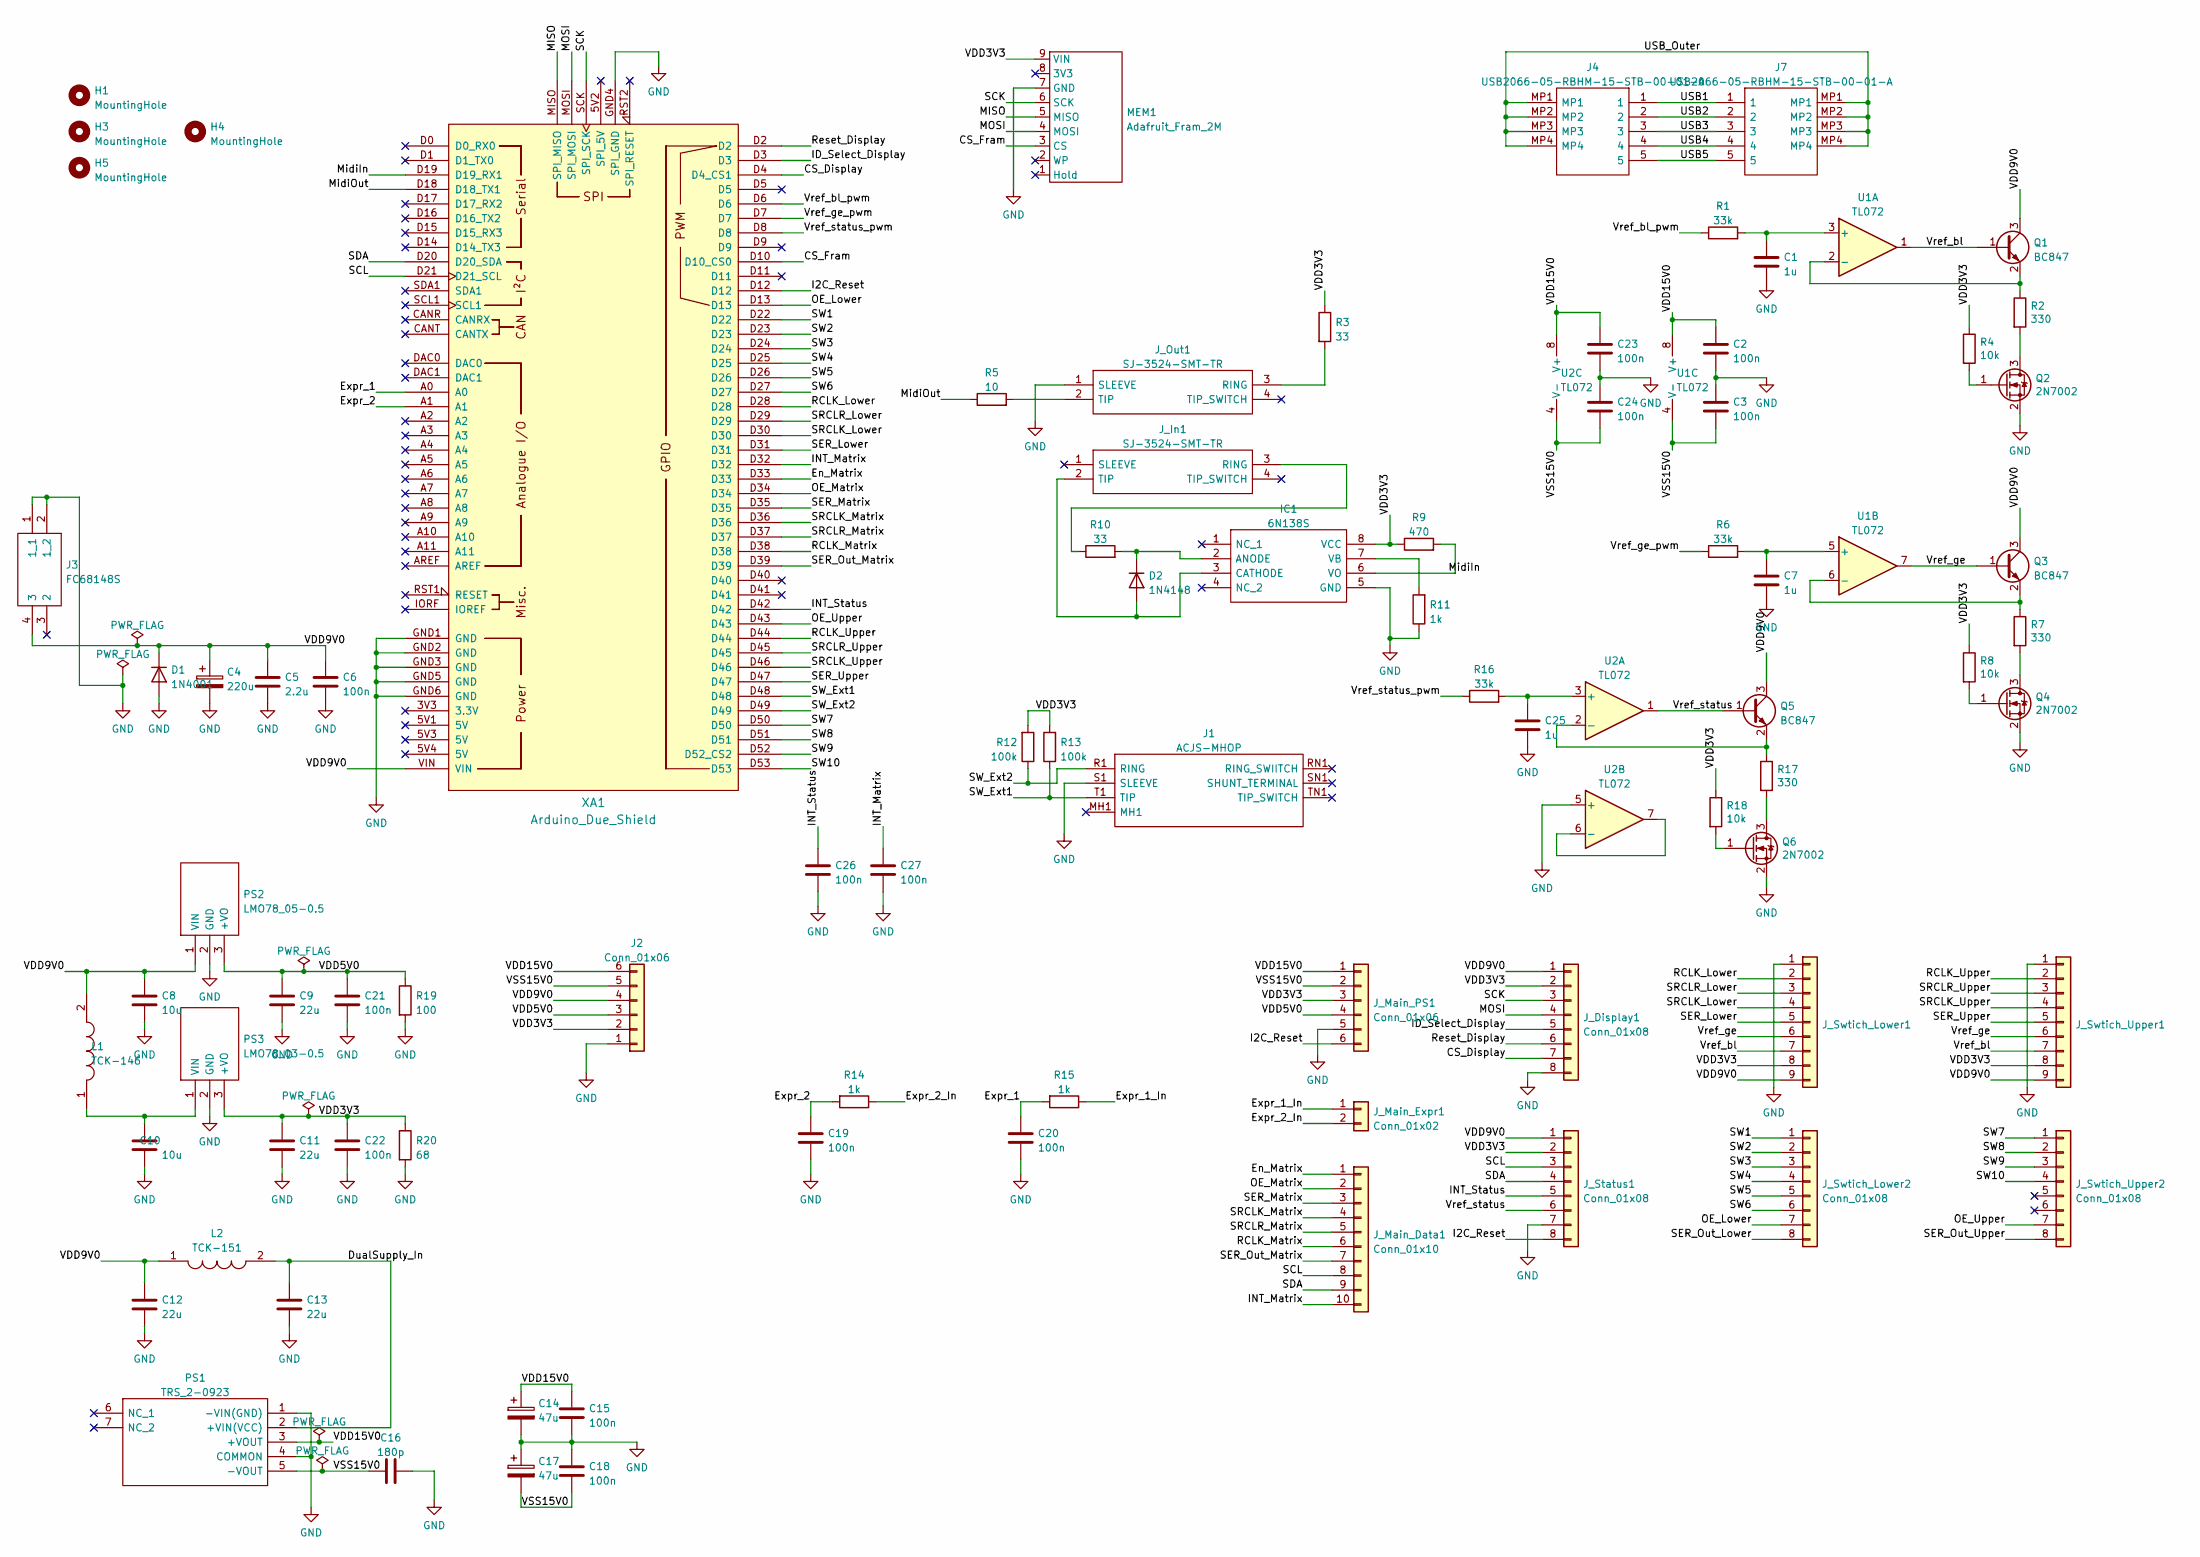
[picture p10: schematic PSU_Prozessor.kicad_sch]

Parts:
C1, C7, C25: 1u; C_1206_3216Metric_Pad1.33x1.80mm_HandSolder
C2, C3, C6, C15, C18, C19, C20, C21, C22, C23, C24, C26, C27: 100n; C_1206_3216Metric_Pad1.33x1.80mm_HandSolder
C4: 220u; CP_Elec_10x10
C5: 2.2u; C_1206_3216Metric_Pad1.33x1.80mm_HandSolder
C8, C10: 10u; C_1206_3216Metric_Pad1.33x1.80mm_HandSolder
C9, C11, C12, C13: 22u; C_1206_3216Metric_Pad1.33x1.80mm_HandSolder
C14, C17: 47u; CP_Elec_8x10.5
C16: 180p; C_1206_3216Metric_Pad1.33x1.80mm_HandSolder
D1: 1N4001; D_DO-41_SOD81_P10.16mm_Horizontal
D2: 1N4148; D_SOD-123
H1, H3, H4, H5: MountingHole; MountingHole_4mm
IC1: 6N138S; SOP254P1016X460-8N; Manufacturer_Part_Number 6N138S; Mouser Part Number 859-6N138S
J1: ACJS-MHOP; ACJSMHOP; Manufacturer_Part_Number ACJS-MHOP; Mouser Part Number 523-ACJS-MHOP
J2: Conn_01x06; PinHeader_1x06_P2.54mm_Vertical
J3: FC68148S; FC68148S_2; Manufacturer_Part_Number FC68148S
J4, J7: USB2066-05-RBHM-15-STB-00-01-A; USB206605RBHM15STB0001A; Manufacturer_Part_Number USB2066-05-RBHM-15-STB-00-01-A; Mouser Part Number 640-2665RBHM15STB01A
J_Display1: Conn_01x08; JST_PH_B8B-PH-K_1x08_P2.00mm_Vertical
J_In1: SJ-3524-SMT-TR; Manufacturer_Part_Number SJ-3524-SMT-TR; Mouser Part Number 490-SJ-3524-SMT-TR
J_Main_Data1: Conn_01x10; JST_PH_B10B-PH-K_1x10_P2.00mm_Vertical
J_Main_Expr1: Conn_01x02; JST_PH_B2B-PH-K_1x02_P2.00mm_Vertical
J_Main_PS1: Conn_01x06; JST_PH_B6B-PH-K_1x06_P2.00mm_Vertical
J_Out1: SJ-3524-SMT-TR; Manufacturer_Part_Number SJ-3524-SMT-TR; Mouser Part Number 490-SJ-3524-SMT-TR
J_Status1: Conn_01x08; JST_PH_B8B-PH-K_1x08_P2.00mm_Vertical
J_Swtich_Lower1: (no value)
J_Swtich_Lower2: Conn_01x08; JST_PH_B8B-PH-K_1x08_P2.00mm_Vertical
J_Swtich_Upper1: (no value)
J_Swtich_Upper2: Conn_01x08; JST_PH_B8B-PH-K_1x08_P2.00mm_Vertical
L1: TCK-146; TCK147; Manufacturer_Part_Number TCK-146; Mouser Part Number 495-TCK-146
L2: TCK-151; TCK151; Manufacturer_Part_Number TCK-151; Mouser Part Number 495-TCK-151
MEM1: Adafruit_Fram_2M; Adafruit_FRam_2M
PS1: TRS_2-0923; TRS20922; Manufacturer_Part_Number TRS 2-0923; Mouser Part Number 495-TRS2-0923
PS2: LMO78_05-0.5; LMO78_0505; Manufacturer_Part_Number LMO78_05-0.5
PS3: LMO78_03-0.5; LMO78_0505; Manufacturer_Part_Number LMO78_05-0.5
Q1, Q3, Q5: BC847; SOT-23
Q2, Q4, Q6: 2N7002; SOT-23
R1, R6, R16: 33k; R_1206_3216Metric_Pad1.30x1.75mm_HandSolder
R2, R7, R17: 330; R_1206_3216Metric_Pad1.30x1.75mm_HandSolder
R3, R10: 33; R_1206_3216Metric_Pad1.30x1.75mm_HandSolder
R4, R8, R18: 10k; R_1206_3216Metric_Pad1.30x1.75mm_HandSolder
R5: 10; R_1206_3216Metric_Pad1.30x1.75mm_HandSolder
R9: 470; R_1206_3216Metric_Pad1.30x1.75mm_HandSolder
R11, R14, R15: 1k; R_1206_3216Metric_Pad1.30x1.75mm_HandSolder
R12, R13: 100k; R_1206_3216Metric_Pad1.30x1.75mm_HandSolder
R19: 100; R_Axial_DIN0414_L11.9mm_D4.5mm_P15.24mm_Horizontal
R20: 68; R_Axial_DIN0414_L11.9mm_D4.5mm_P15.24mm_Horizontal
U1, U2: TL072; SOIC127P600X175-8N
XA1: Arduino_Due_Shield

Connections:
/CS_Display: J_Display1.7, XA1.D4 (D4_CS1)
/CS_Fram: MEM1.3 (CS), XA1.D10 (D10_CS0)
/DualSupply_In: C13.1, L2.2, PS1.2 (+VIN(VCC))
/En_Matrix: J_Main_Data1.1, XA1.D33
/Expr_1: C20.1, R15.2, XA1.A0
/Expr_1_In: J_Main_Expr1.1, R15.1
/Expr_2: C19.1, R14.2, XA1.A1
/Expr_2_In: J_Main_Expr1.2, R14.1
/I2C_Reset: J_Main_PS1.6, J_Status1.8, XA1.D12
/ID_Select_Display: J_Display1.5, XA1.D3
/INT_Matrix: C27.1, J_Main_Data1.10, XA1.D32
/INT_Status: C26.1, J_Status1.5, XA1.D42
/MISO: MEM1.5 (MISO), XA1.MISO (SPI_MISO)
/MOSI: J_Display1.4, MEM1.4 (MOSI), XA1.MOSI (SPI_MOSI)
/MidiIn: IC1.6 (VO), R9.2, XA1.D19 (D19_RX1)
/MidiOut: R5.1, XA1.D18 (D18_TX1)
/OE_Lower: J_Swtich_Lower2.7, XA1.D13
/OE_Matrix: J_Main_Data1.2, XA1.D34
/OE_Upper: J_Swtich_Upper2.7, XA1.D43
/RCLK_Lower: J_Swtich_Lower1.2, XA1.D28
/RCLK_Matrix: J_Main_Data1.6, XA1.D38
/RCLK_Upper: J_Swtich_Upper1.2, XA1.D44
/Reset_Display: J_Display1.6, XA1.D2
/SCK: J_Display1.3, MEM1.6 (SCK), XA1.SCK (SPI_SCK)
/SCL: J_Main_Data1.8, J_Status1.3, XA1.D21 (D21_SCL)
/SDA: J_Main_Data1.9, J_Status1.4, XA1.D20 (D20_SDA)
/SER_Lower: J_Swtich_Lower1.5, XA1.D31
/SER_Matrix: J_Main_Data1.3, XA1.D35
/SER_Out_Lower: J_Swtich_Lower2.8
/SER_Out_Matrix: J_Main_Data1.7, XA1.D39
/SER_Out_Upper: J_Swtich_Upper2.8
/SER_Upper: J_Swtich_Upper1.5, XA1.D47
/SRCLK_Lower: J_Swtich_Lower1.4, XA1.D30
/SRCLK_Matrix: J_Main_Data1.4, XA1.D36
/SRCLK_Upper: J_Swtich_Upper1.4, XA1.D46
/SRCLR_Lower: J_Swtich_Lower1.3, XA1.D29
/SRCLR_Matrix: J_Main_Data1.5, XA1.D37
/SRCLR_Upper: J_Swtich_Upper1.3, XA1.D45
/SW1: J_Swtich_Lower2.1, XA1.D22
/SW2: J_Swtich_Lower2.2, XA1.D23
/SW3: J_Swtich_Lower2.3, XA1.D24
/SW4: J_Swtich_Lower2.4, XA1.D25
/SW5: J_Swtich_Lower2.5, XA1.D26
/SW6: J_Swtich_Lower2.6, XA1.D27
/SW7: J_Swtich_Upper2.1, XA1.D50
/SW8: J_Swtich_Upper2.2, XA1.D51
/SW9: J_Swtich_Upper2.3, XA1.D52 (D52_CS2)
/SW10: J_Swtich_Upper2.4, XA1.D53
/SW_Ext1: J1.T1 (TIP), R13.1, XA1.D48
/SW_Ext2: J1.R1 (RING), R12.1, XA1.D49
/USB1: J4.1, J7.1
/USB2: J4.2, J7.2
/USB3: J4.3, J7.3
/USB4: J4.4, J7.4
/USB5: J4.5, J7.5
/USB_Outer: J4.MP1, J4.MP2, J4.MP3, J4.MP4, J7.MP1, J7.MP2, J7.MP3, J7.MP4
/VDD3V3: C11.1, C22.1, IC1.8 (VCC), J2.2, J_Display1.2, J_Main_PS1.3, J_Status1.2, J_Swtich_Lower1.8, J_Swtich_Upper1.8, MEM1.9 (VIN), PS3.3 (+VO), R3.1, R4.1, R8.1, R9.1, R12.2, R13.2, R18.1, R20.1
/VDD5V0: C9.1, C21.1, J2.3, J_Main_PS1.4, PS2.3 (+VO), R19.1
/VDD9V0: C4.1, C5.1, C6.1, C8.1, C12.1, D1.1 (K), J2.4, J3.4 (3), J_Display1.1, J_Status1.1, J_Swtich_Lower1.9, J_Swtich_Upper1.9, L1.2, L2.1, PS2.1 (VIN), Q1.3 (C), Q3.3 (C), Q5.3 (C), XA1.VIN
/VDD15V0: C2.1, C14.1, C15.1, C23.1, J2.6, J_Main_PS1.1, PS1.3 (+VOUT), U1.8 (V+), U2.8 (V+)
/VSS15V0: C3.2, C16.1, C17.2, C18.2, C24.2, J2.5, J_Main_PS1.2, PS1.5 (-VOUT), U1.4 (V-), U2.4 (V-)
/Vref_bl: J_Swtich_Lower1.7, J_Swtich_Upper1.7, Q1.1 (B), U1.1
/Vref_bl_pwm: R1.1, XA1.D6
/Vref_ge: J_Swtich_Lower1.6, J_Swtich_Upper1.6, Q3.1 (B), U1.7
/Vref_ge_pwm: R6.1, XA1.D7
/Vref_status: J_Status1.6, Q5.1 (B), U2.1
/Vref_status_pwm: R16.1, XA1.D8
GND: C1.2, C2.2, C3.1, C4.2, C5.2, C6.2, C7.2, C8.2, C9.2, C10.2, C11.2, C12.2, C13.2, C14.2, C15.2, C16.2, C17.1, C18.1, C19.2, C20.2, C21.2, C22.2, C23.2, C24.1, C25.2, C26.2, C27.2, D1.2 (A), IC1.5 (GND), J1.S1 (SLEEVE), J2.1, J3.1 (1_1), J3.2 (1_2), J_Display1.8, J_Main_PS1.5, J_Out1.1 (SLEEVE), J_Status1.7, J_Swtich_Lower1.1, J_Swtich_Upper1.1, MEM1.7 (GND), PS1.1 (-VIN(GND)), PS1.4 (COMMON), PS2.2 (GND), PS3.2 (GND), Q2.2 (S), Q4.2 (S), Q6.2 (S), R11.1, R19.2, R20.2, U2.5 (+), XA1.GND1 (GND), XA1.GND2 (GND), XA1.GND3 (GND), XA1.GND4 (SPI_GND), XA1.GND5 (GND), XA1.GND6 (GND)
unnamed: C1.1, R1.2, U1.3 (+)
unnamed: C7.1, R6.2, U1.5 (+)
unnamed: C10.1, L1.1, PS3.1 (VIN)
unnamed: C25.1, R16.2, U2.3 (+)
unnamed: D2.1 (K), IC1.2 (ANODE), R10.2
unnamed: D2.2 (A), IC1.3 (CATHODE), J_In1.2 (TIP)
unnamed: IC1.7 (VB), R11.2
unnamed: J_In1.3 (RING), R10.1
unnamed: J_Out1.2 (TIP), R5.2
unnamed: J_Out1.3 (RING), R3.2
unnamed: Q1.2 (E), R2.1, U1.2 (-)
unnamed: Q2.1 (G), R4.2
unnamed: Q2.3 (D), R2.2
unnamed: Q3.2 (E), R7.1, U1.6 (-)
unnamed: Q4.1 (G), R8.2
unnamed: Q4.3 (D), R7.2
unnamed: Q5.2 (E), R17.1, U2.2 (-)
unnamed: Q6.1 (G), R18.2
unnamed: Q6.3 (D), R17.2
unnamed: U2.6 (-), U2.7

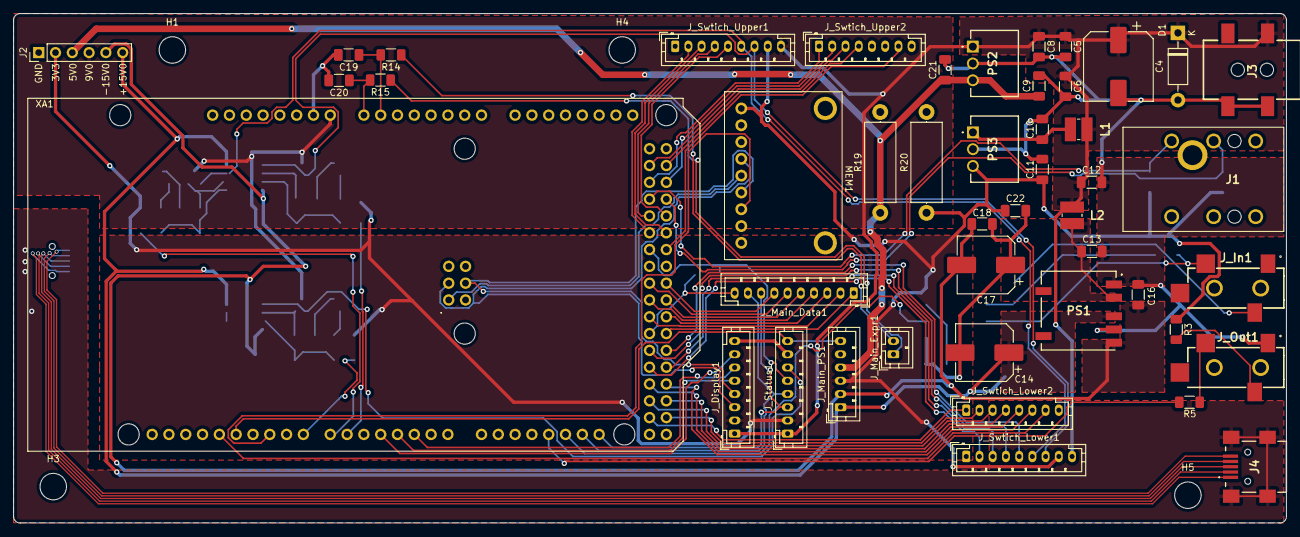
[picture p11: board PSU_Prozessor.kicad_pcb from above]

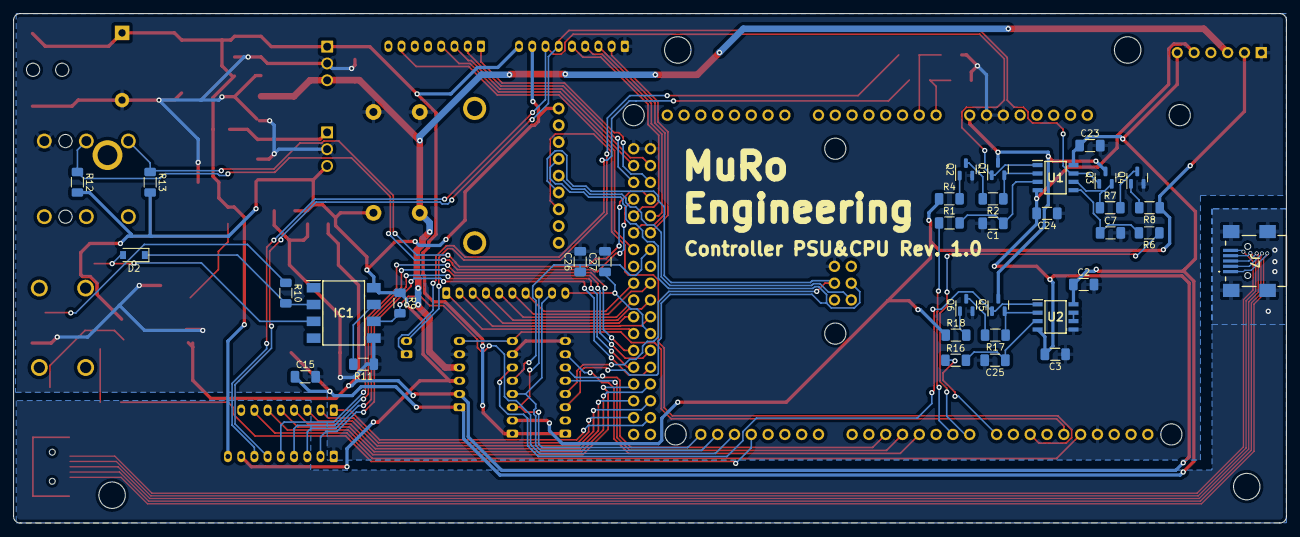
[picture p12: board PSU_Prozessor.kicad_pcb from below]

Board: 2 copper layers, 192.4 x 77.0 mm, 85 parts (35 on the bottom side), 86 nets.
