RolandMueller1994/ControllerV2/SwitchPCB/switchpcb_v2_left/switchpcb_v2_left.kicad_pcb

## KiCad design SwitchPCB/switchpcb_v2_left/switchpcb_v2_left.kicad_pcb (2022-12-18)

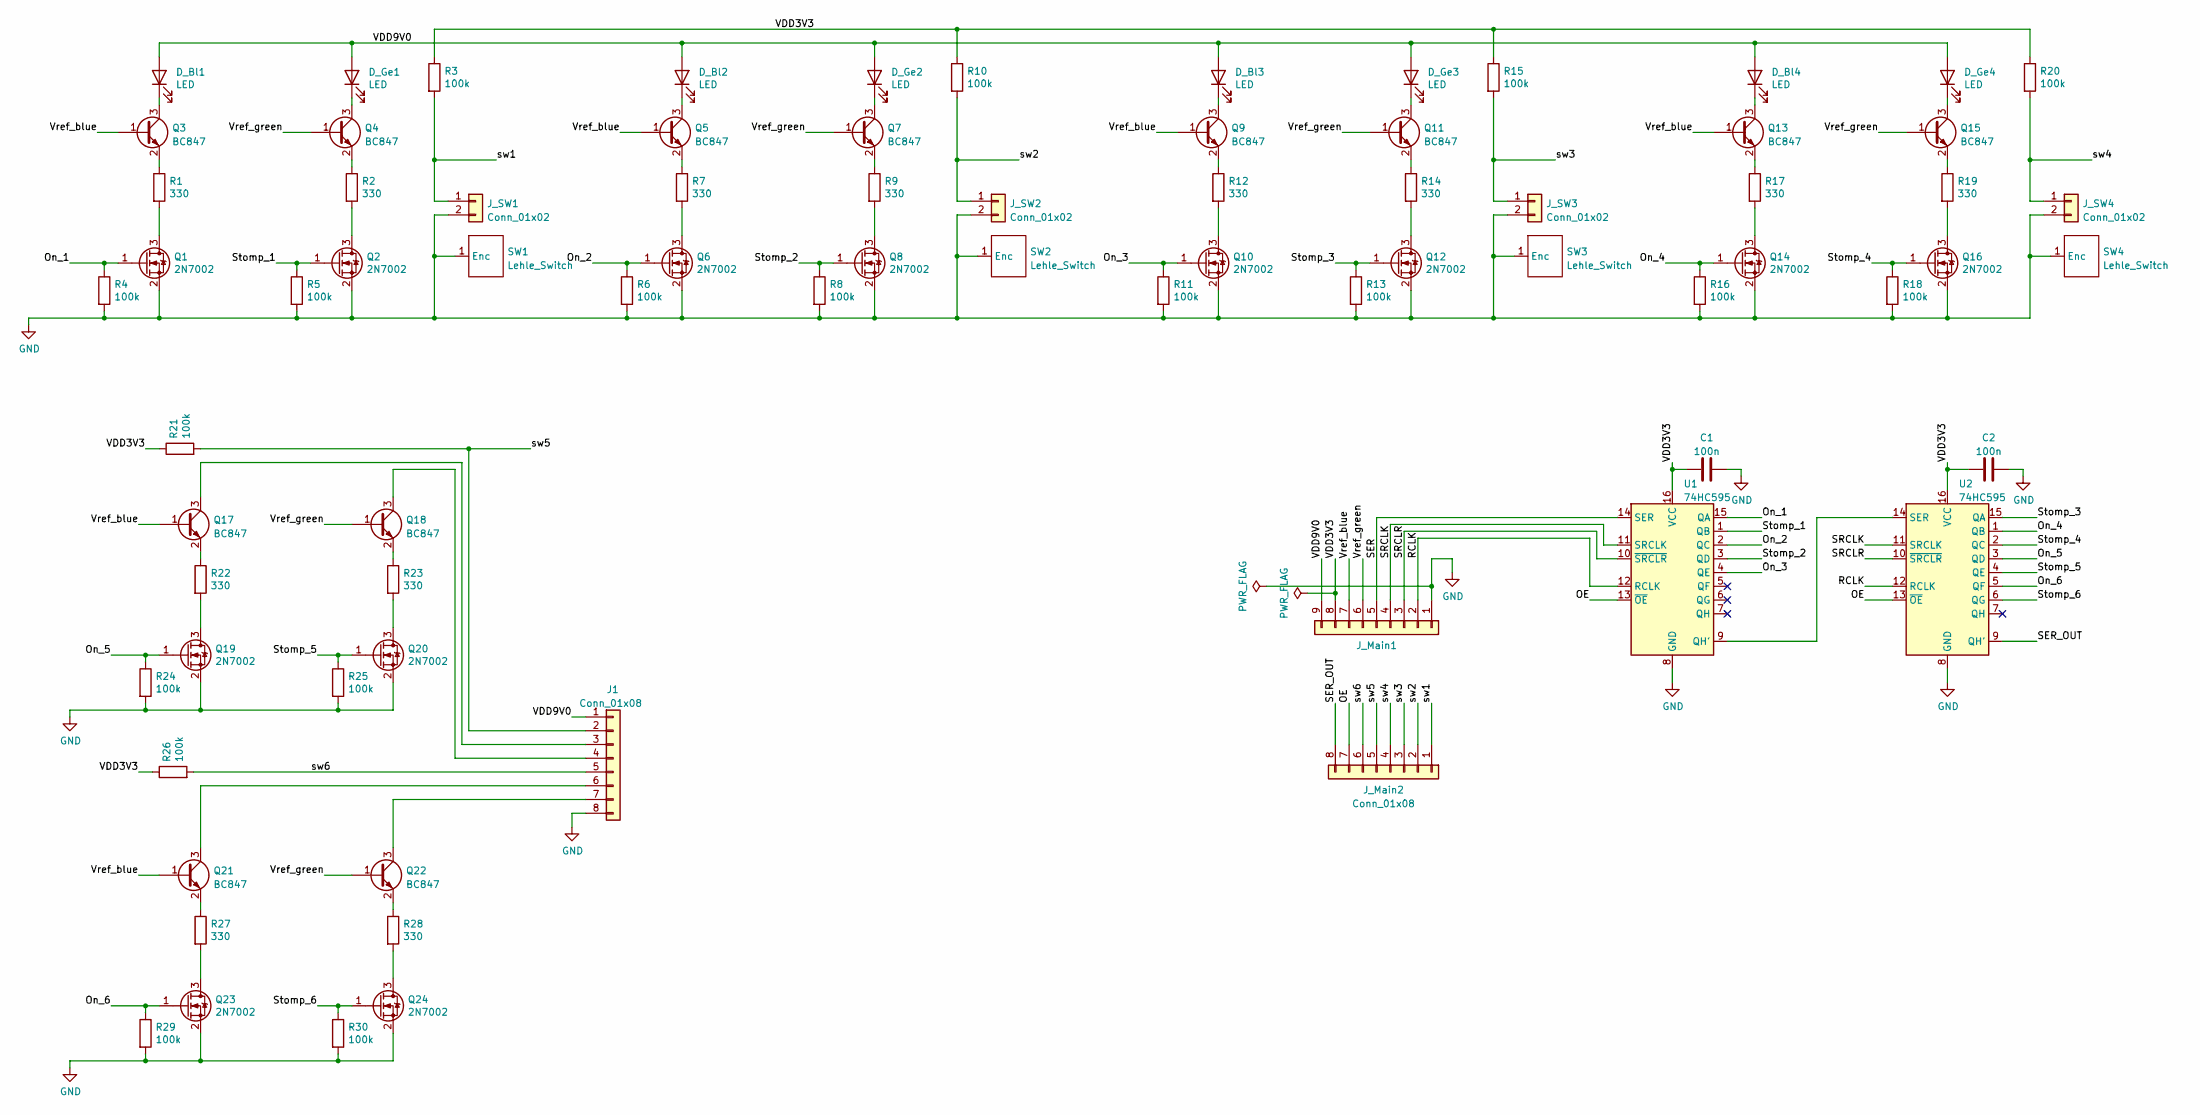
[picture p13: schematic switchpcb_v2_left.kicad_sch]

Parts:
C1, C2: 100n; C_1206_3216Metric_Pad1.33x1.80mm_HandSolder
D_Bl1, D_Bl2, D_Bl3, D_Bl4: LED; LED_D3.0mm
D_Ge1, D_Ge2, D_Ge3, D_Ge4: LED; LED_D3.0mm
J1: Conn_01x08; JST_PH_B8B-PH-K_1x08_P2.00mm_Vertical
J_Main1: (no value)
J_Main2: Conn_01x08; JST_PH_B8B-PH-K_1x08_P2.00mm_Vertical
J_SW1, J_SW2, J_SW3, J_SW4: Conn_01x02; JST_PH_B2B-PH-K_1x02_P2.00mm_Vertical
Q1, Q2, Q6, Q8, Q10, Q12, Q14, Q16, Q19, Q20, Q23, Q24: 2N7002; SOT-23
Q3, Q4, Q5, Q7, Q9, Q11, Q13, Q15, Q17, Q18, Q21, Q22: BC847; SOT-23
R1, R2, R7, R9, R12, R14, R17, R19, R22, R23, R27, R28: 330; R_1206_3216Metric_Pad1.30x1.75mm_HandSolder
R3, R4, R5, R6, R8, R10, R11, R13, R15, R16, R18, R20, R21, R24, R25, R26, R29, R30: 100k; R_1206_3216Metric_Pad1.30x1.75mm_HandSolder
SW1, SW2, SW3, SW4: Lehle_Switch; LehleSwitch
U1, U2: 74HC595; SOIC127P600X175-16N

Connections:
/OE: J_Main2.7, U1.13 (~OE), U2.13 (~OE)
/On_1: Q1.1 (G), R4.1, U1.15 (QA)
/On_2: Q6.1 (G), R6.1, U1.2 (QC)
/On_3: Q10.1 (G), R11.1, U1.4 (QE)
/On_4: Q14.1 (G), R16.1, U2.1 (QB)
/On_5: Q19.1 (G), R24.1, U2.3 (QD)
/On_6: Q23.1 (G), R29.1, U2.5 (QF)
/RCLK: J_Main1.2, U1.12 (RCLK), U2.12 (RCLK)
/SER: J_Main1.5, U1.14 (SER)
/SER_OUT: J_Main2.8, U2.9 (QH')
/SRCLK: J_Main1.4, U1.11 (SRCLK), U2.11 (SRCLK)
/SRCLR: J_Main1.3, U1.10 (~SRCLR), U2.10 (~SRCLR)
/Stomp_1: Q2.1 (G), R5.1, U1.1 (QB)
/Stomp_2: Q8.1 (G), R8.1, U1.3 (QD)
/Stomp_3: Q12.1 (G), R13.1, U2.15 (QA)
/Stomp_4: Q16.1 (G), R18.1, U2.2 (QC)
/Stomp_5: Q20.1 (G), R25.1, U2.4 (QE)
/Stomp_6: Q24.1 (G), R30.1, U2.6 (QG)
/VDD3V3: C1.1, C2.1, J_Main1.8, R3.1, R10.1, R15.1, R20.1, R21.1, R26.1, U1.16 (VCC), U2.16 (VCC)
/VDD9V0: D_Bl1.2 (A), D_Bl2.2 (A), D_Bl3.2 (A), D_Bl4.2 (A), D_Ge1.2 (A), D_Ge2.2 (A), D_Ge3.2 (A), D_Ge4.2 (A), J1.1, J_Main1.9
/Vref_blue: J_Main1.7, Q3.1 (B), Q5.1 (B), Q9.1 (B), Q13.1 (B), Q17.1 (B), Q21.1 (B)
/Vref_green: J_Main1.6, Q4.1 (B), Q7.1 (B), Q11.1 (B), Q15.1 (B), Q18.1 (B), Q22.1 (B)
/sw1: J_Main2.1, J_SW1.1, R3.2
/sw2: J_Main2.2, J_SW2.1, R10.2
/sw3: J_Main2.3, J_SW3.1, R15.2
/sw4: J_Main2.4, J_SW4.1, R20.2
/sw5: J1.2, J_Main2.5, R21.2
/sw6: J1.5, J_Main2.6, R26.2
GND: C1.2, C2.2, J1.8, J_Main1.1, J_SW1.2, J_SW2.2, J_SW3.2, J_SW4.2, Q1.2 (S), Q2.2 (S), Q6.2 (S), Q8.2 (S), Q10.2 (S), Q12.2 (S), Q14.2 (S), Q16.2 (S), Q19.2 (S), Q20.2 (S), Q23.2 (S), Q24.2 (S), R4.2, R5.2, R6.2, R8.2, R11.2, R13.2, R16.2, R18.2, R24.2, R25.2, R29.2, R30.2, SW1.1 (Enc), SW2.1 (Enc), SW3.1 (Enc), SW4.1 (Enc), U1.8 (GND), U2.8 (GND)
unnamed: D_Bl1.1 (K), Q3.3 (C)
unnamed: D_Bl2.1 (K), Q5.3 (C)
unnamed: D_Bl3.1 (K), Q9.3 (C)
unnamed: D_Bl4.1 (K), Q13.3 (C)
unnamed: D_Ge1.1 (K), Q4.3 (C)
unnamed: D_Ge2.1 (K), Q7.3 (C)
unnamed: D_Ge3.1 (K), Q11.3 (C)
unnamed: D_Ge4.1 (K), Q15.3 (C)
unnamed: Q1.3 (D), R1.2
unnamed: Q2.3 (D), R2.2
unnamed: Q3.2 (E), R1.1
unnamed: Q4.2 (E), R2.1
unnamed: Q5.2 (E), R7.1
unnamed: Q6.3 (D), R7.2
unnamed: Q7.2 (E), R9.1
unnamed: Q8.3 (D), R9.2
unnamed: Q9.2 (E), R12.1
unnamed: Q10.3 (D), R12.2
unnamed: Q11.2 (E), R14.1
unnamed: Q12.3 (D), R14.2
unnamed: Q13.2 (E), R17.1
unnamed: Q14.3 (D), R17.2
unnamed: Q15.2 (E), R19.1
unnamed: Q16.3 (D), R19.2
unnamed: Q17.2 (E), R22.1
unnamed: J1.3, Q17.3 (C)
unnamed: Q18.2 (E), R23.1
unnamed: J1.4, Q18.3 (C)
unnamed: Q19.3 (D), R22.2
unnamed: Q20.3 (D), R23.2
unnamed: Q21.2 (E), R27.1
unnamed: J1.6, Q21.3 (C)
unnamed: Q22.2 (E), R28.1
unnamed: J1.7, Q22.3 (C)
unnamed: Q23.3 (D), R27.2
unnamed: Q24.3 (D), R28.2
unnamed: U1.9 (QH'), U2.14 (SER)

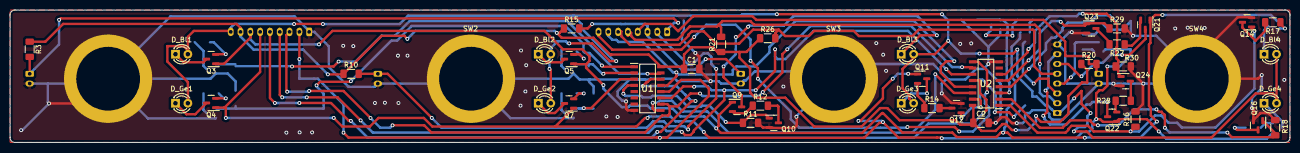
[picture p14: board switchpcb_v2_left.kicad_pcb from above]

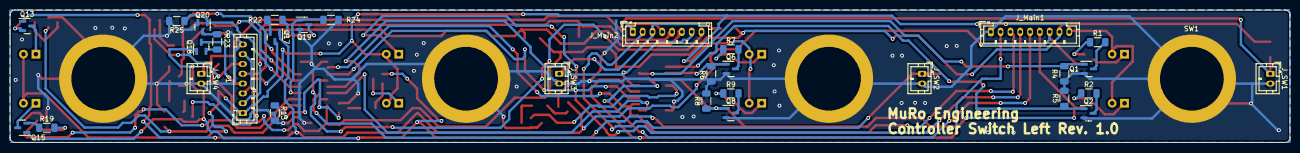
[picture p15: board switchpcb_v2_left.kicad_pcb from below]

Board: 2 copper layers, 261.0 x 27.0 mm, 77 parts (32 on the bottom side), 66 nets.
