RolandMueller1994/ControllerV2/Status/StatusPCB/StatusPCB.kicad_pcb

## KiCad design Status/StatusPCB/StatusPCB.kicad_pcb (2022-10-18)

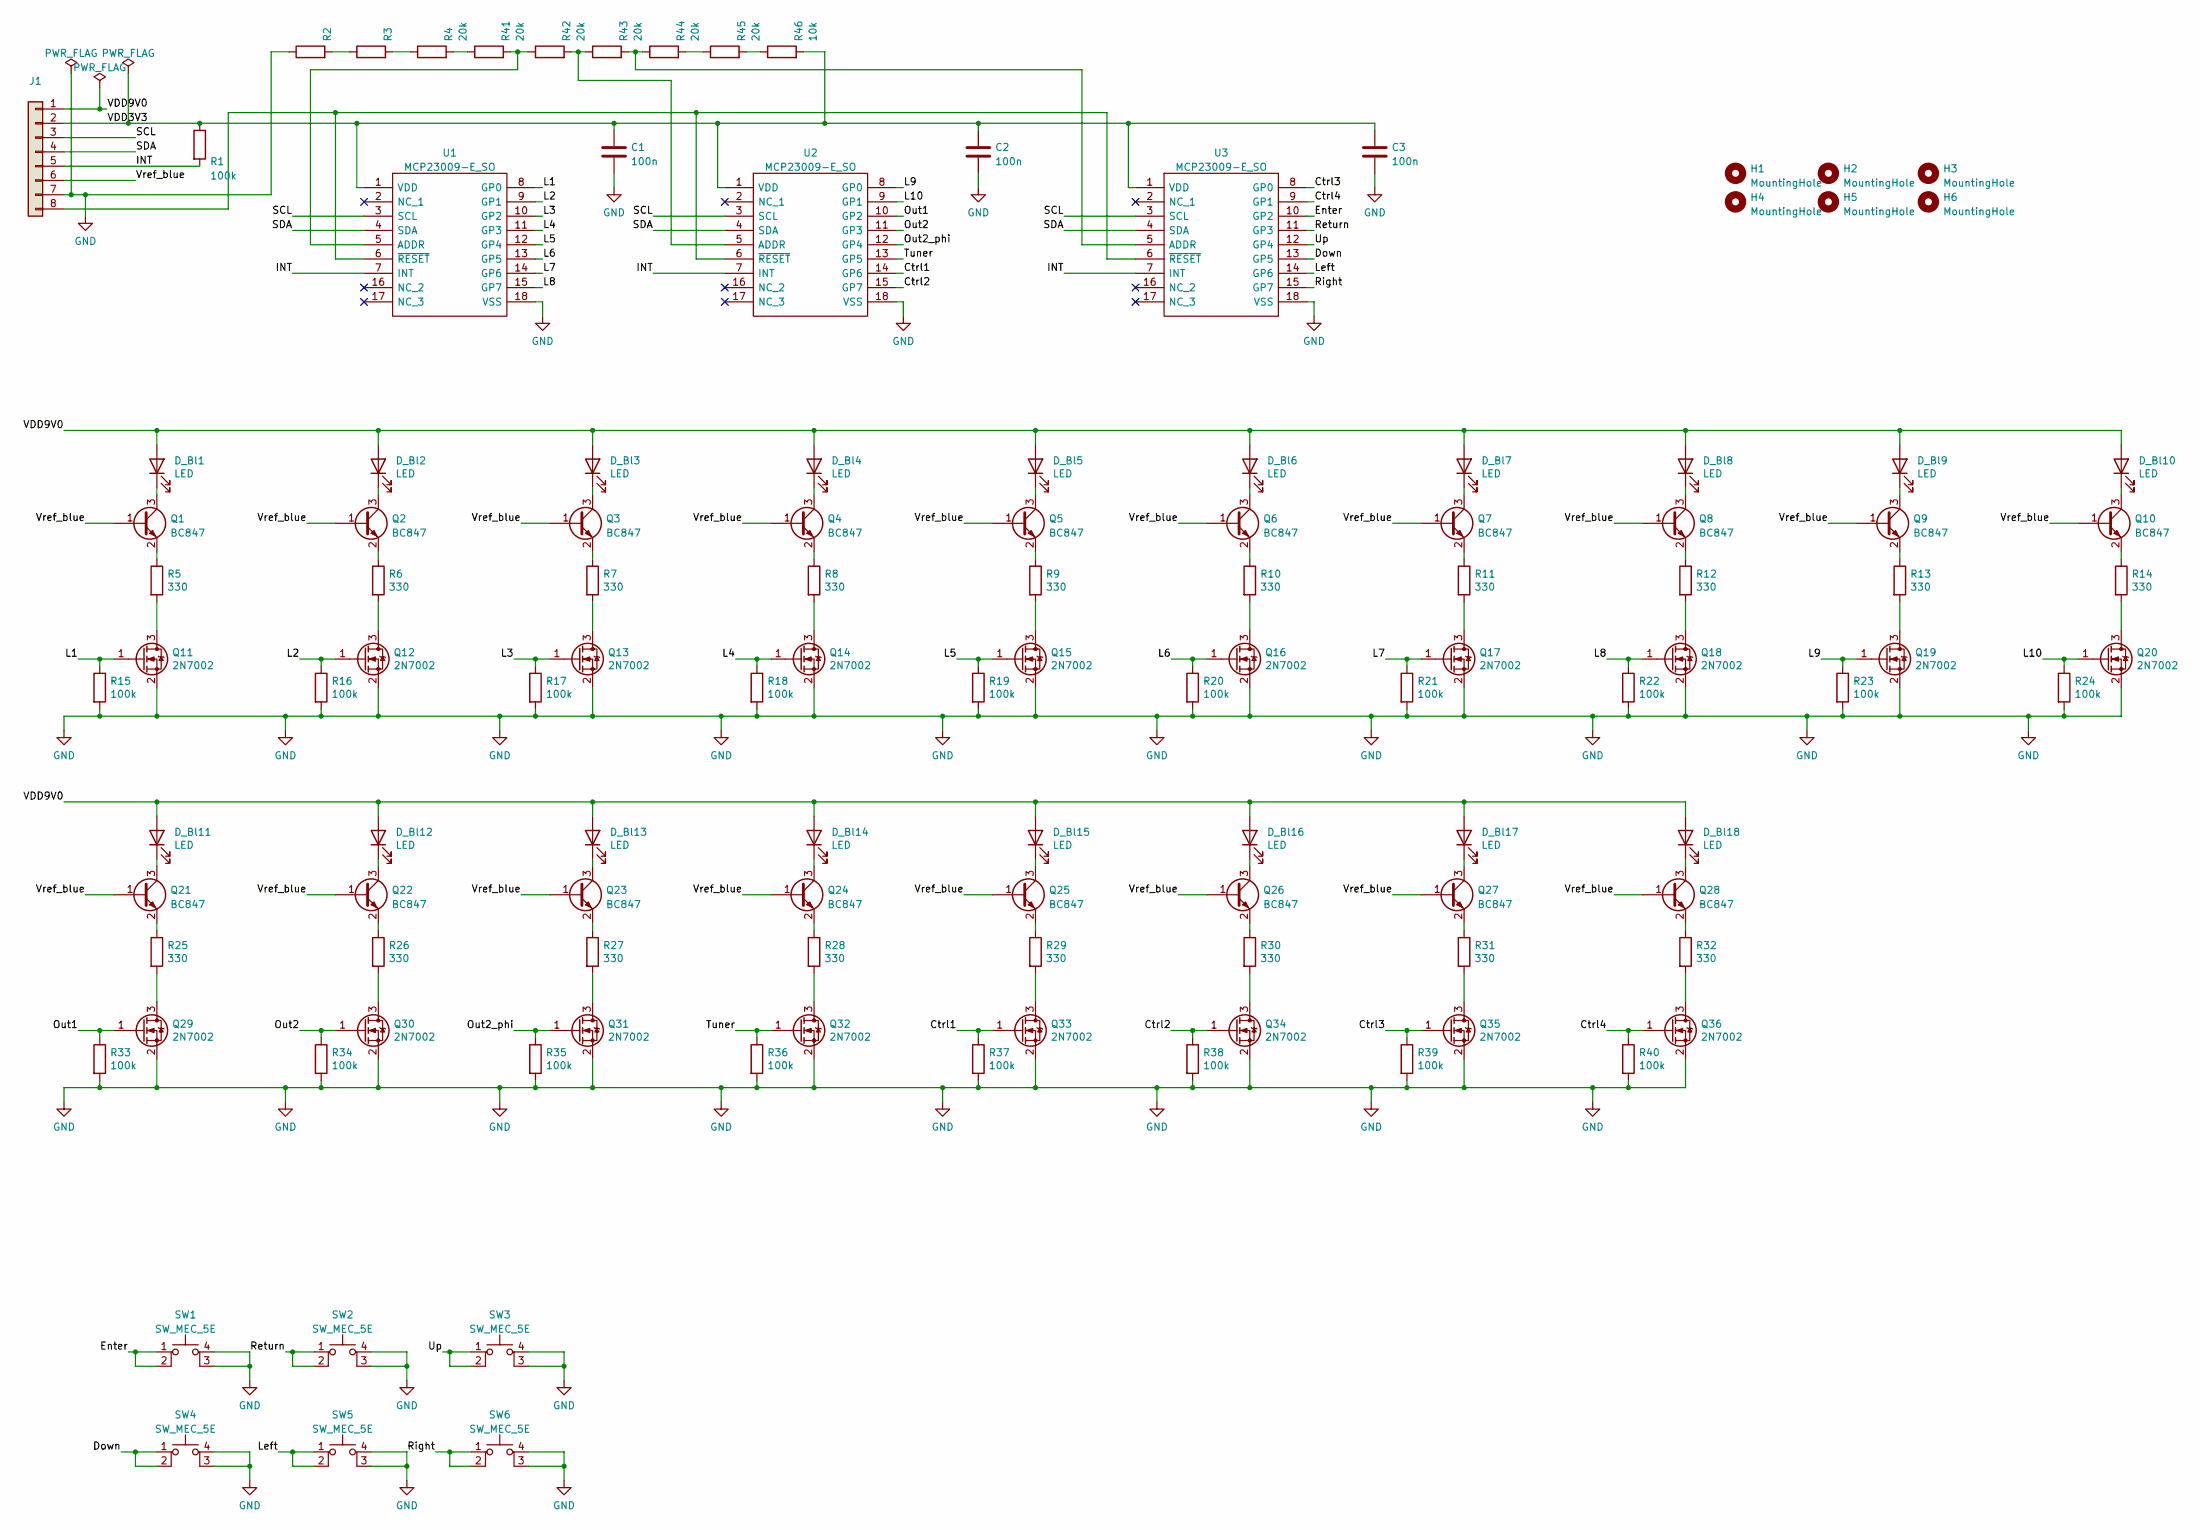
[picture p16: schematic StatusPCB.kicad_sch]

Parts:
C1, C2, C3: 100n; C_1206_3216Metric_Pad1.33x1.80mm_HandSolder
D_Bl1, D_Bl2, D_Bl3, D_Bl4, D_Bl5, D_Bl6, D_Bl7, D_Bl8, D_Bl9, D_Bl10, D_Bl11, D_Bl12, D_Bl13, D_Bl14, D_Bl15, D_Bl16, D_Bl17, D_Bl18: LED; LED_D3.0mm
H1, H2, H3, H4, H5, H6: MountingHole; MountingHole_3.2mm_M3
J1: (no value)
Q1, Q2, Q3, Q4, Q5, Q6, Q7, Q8, Q9, Q10, Q21, Q22, Q23, Q24, Q25, Q26, Q27, Q28: BC847; SOT-23
Q11, Q12, Q13, Q14, Q15, Q16, Q17, Q18, Q19, Q20, Q29, Q30, Q31, Q32, Q33, Q34, Q35, Q36: 2N7002; SOT-23
R1, R15, R16, R17, R18, R19, R20, R21, R22, R23, R24, R33, R34, R35, R36, R37, R38, R39, R40: 100k; R_1206_3216Metric_Pad1.30x1.75mm_HandSolder
R2, R3: R_1206_3216Metric_Pad1.30x1.75mm_HandSolder
R4, R41, R42, R43, R44, R45: 20k; R_1206_3216Metric_Pad1.30x1.75mm_HandSolder
R5, R6, R7, R8, R9, R10, R11, R12, R13, R14, R25, R26, R27, R28, R29, R30, R31, R32: 330; R_1206_3216Metric_Pad1.30x1.75mm_HandSolder
R46: 10k; R_1206_3216Metric_Pad1.30x1.75mm_HandSolder
SW1, SW2, SW3, SW4, SW5, SW6: SW_MEC_5E; SW_MEC_5GTH9
U1, U2, U3: MCP23009-E_SO; Manufacturer_Part_Number MCP23009-E/SO; Mouser Part Number 579-MCP23009-E/SO

Connections:
/Ctrl1: Q33.1 (G), R37.1, U2.14 (GP6)
/Ctrl2: Q34.1 (G), R38.1, U2.15 (GP7)
/Ctrl3: Q35.1 (G), R39.1, U3.8 (GP0)
/Ctrl4: Q36.1 (G), R40.1, U3.9 (GP1)
/Down: SW4.1, SW4.2, U3.13 (GP5)
/Enter: SW1.1, SW1.2, U3.10 (GP2)
/INT: J1.5, R1.2, U1.7 (INT), U2.7 (INT), U3.7 (INT)
/L1: Q11.1 (G), R15.1, U1.8 (GP0)
/L2: Q12.1 (G), R16.1, U1.9 (GP1)
/L3: Q13.1 (G), R17.1, U1.10 (GP2)
/L4: Q14.1 (G), R18.1, U1.11 (GP3)
/L5: Q15.1 (G), R19.1, U1.12 (GP4)
/L6: Q16.1 (G), R20.1, U1.13 (GP5)
/L7: Q17.1 (G), R21.1, U1.14 (GP6)
/L8: Q18.1 (G), R22.1, U1.15 (GP7)
/L9: Q19.1 (G), R23.1, U2.8 (GP0)
/L10: Q20.1 (G), R24.1, U2.9 (GP1)
/Left: SW5.1, SW5.2, U3.14 (GP6)
/Out1: Q29.1 (G), R33.1, U2.10 (GP2)
/Out2: Q30.1 (G), R34.1, U2.11 (GP3)
/Out2_phi: Q31.1 (G), R35.1, U2.12 (GP4)
/Return: SW2.1, SW2.2, U3.11 (GP3)
/Right: SW6.1, SW6.2, U3.15 (GP7)
/SCL: J1.3, U1.3 (SCL), U2.3 (SCL), U3.3 (SCL)
/SDA: J1.4, U1.4 (SDA), U2.4 (SDA), U3.4 (SDA)
/Tuner: Q32.1 (G), R36.1, U2.13 (GP5)
/Up: SW3.1, SW3.2, U3.12 (GP4)
/VDD3V3: C1.1, C2.1, C3.1, J1.2, R1.1, R46.2, U1.1 (VDD), U2.1 (VDD), U3.1 (VDD)
/VDD9V0: D_Bl1.2 (A), D_Bl2.2 (A), D_Bl3.2 (A), D_Bl4.2 (A), D_Bl5.2 (A), D_Bl6.2 (A), D_Bl7.2 (A), D_Bl8.2 (A), D_Bl9.2 (A), D_Bl10.2 (A), D_Bl11.2 (A), D_Bl12.2 (A), D_Bl13.2 (A), D_Bl14.2 (A), D_Bl15.2 (A), D_Bl16.2 (A), D_Bl17.2 (A), D_Bl18.2 (A), J1.1
/Vref_blue: J1.6, Q1.1 (B), Q2.1 (B), Q3.1 (B), Q4.1 (B), Q5.1 (B), Q6.1 (B), Q7.1 (B), Q8.1 (B), Q9.1 (B), Q10.1 (B), Q21.1 (B), Q22.1 (B), Q23.1 (B), Q24.1 (B), Q25.1 (B), Q26.1 (B), Q27.1 (B), Q28.1 (B)
GND: C1.2, C2.2, C3.2, J1.7, Q11.2 (S), Q12.2 (S), Q13.2 (S), Q14.2 (S), Q15.2 (S), Q16.2 (S), Q17.2 (S), Q18.2 (S), Q19.2 (S), Q20.2 (S), Q29.2 (S), Q30.2 (S), Q31.2 (S), Q32.2 (S), Q33.2 (S), Q34.2 (S), Q35.2 (S), Q36.2 (S), R2.1, R15.2, R16.2, R17.2, R18.2, R19.2, R20.2, R21.2, R22.2, R23.2, R24.2, R33.2, R34.2, R35.2, R36.2, R37.2, R38.2, R39.2, R40.2, SW1.3 (K), SW1.4 (A), SW2.3 (K), SW2.4 (A), SW3.3 (K), SW3.4 (A), SW4.3 (K), SW4.4 (A), SW5.3 (K), SW5.4 (A), SW6.3 (K), SW6.4 (A), U1.18 (VSS), U2.18 (VSS), U3.18 (VSS)
unnamed: D_Bl1.1 (K), Q1.3 (C)
unnamed: D_Bl2.1 (K), Q2.3 (C)
unnamed: D_Bl3.1 (K), Q3.3 (C)
unnamed: D_Bl4.1 (K), Q4.3 (C)
unnamed: D_Bl5.1 (K), Q5.3 (C)
unnamed: D_Bl6.1 (K), Q6.3 (C)
unnamed: D_Bl7.1 (K), Q7.3 (C)
unnamed: D_Bl8.1 (K), Q8.3 (C)
unnamed: D_Bl9.1 (K), Q9.3 (C)
unnamed: D_Bl10.1 (K), Q10.3 (C)
unnamed: D_Bl11.1 (K), Q21.3 (C)
unnamed: D_Bl12.1 (K), Q22.3 (C)
unnamed: D_Bl13.1 (K), Q23.3 (C)
unnamed: D_Bl14.1 (K), Q24.3 (C)
unnamed: D_Bl15.1 (K), Q25.3 (C)
unnamed: D_Bl16.1 (K), Q26.3 (C)
unnamed: D_Bl17.1 (K), Q27.3 (C)
unnamed: D_Bl18.1 (K), Q28.3 (C)
unnamed: J1.8, U1.6 (~RESET), U2.6 (~RESET), U3.6 (~RESET)
unnamed: Q1.2 (E), R5.1
unnamed: Q2.2 (E), R6.1
unnamed: Q3.2 (E), R7.1
unnamed: Q4.2 (E), R8.1
unnamed: Q5.2 (E), R9.1
unnamed: Q6.2 (E), R10.1
unnamed: Q7.2 (E), R11.1
unnamed: Q8.2 (E), R12.1
unnamed: Q9.2 (E), R13.1
unnamed: Q10.2 (E), R14.1
unnamed: Q11.3 (D), R5.2
unnamed: Q12.3 (D), R6.2
unnamed: Q13.3 (D), R7.2
unnamed: Q14.3 (D), R8.2
unnamed: Q15.3 (D), R9.2
unnamed: Q16.3 (D), R10.2
unnamed: Q17.3 (D), R11.2
unnamed: Q18.3 (D), R12.2
unnamed: Q19.3 (D), R13.2
unnamed: Q20.3 (D), R14.2
unnamed: Q21.2 (E), R25.1
unnamed: Q22.2 (E), R26.1
unnamed: Q23.2 (E), R27.1
unnamed: Q24.2 (E), R28.1
unnamed: Q25.2 (E), R29.1
unnamed: Q26.2 (E), R30.1
unnamed: Q27.2 (E), R31.1
unnamed: Q28.2 (E), R32.1
unnamed: Q29.3 (D), R25.2
unnamed: Q30.3 (D), R26.2
unnamed: Q31.3 (D), R27.2
unnamed: Q32.3 (D), R28.2
unnamed: Q33.3 (D), R29.2
unnamed: Q34.3 (D), R30.2
unnamed: Q35.3 (D), R31.2
unnamed: Q36.3 (D), R32.2
unnamed: R2.2, R3.1
unnamed: R3.2, R4.1
unnamed: R4.2, R41.1
unnamed: R41.2, R42.1, U1.5 (ADDR)
unnamed: R42.2, R43.1, U2.5 (ADDR)
unnamed: R43.2, R44.1, U3.5 (ADDR)
unnamed: R44.2, R45.1
unnamed: R45.2, R46.1

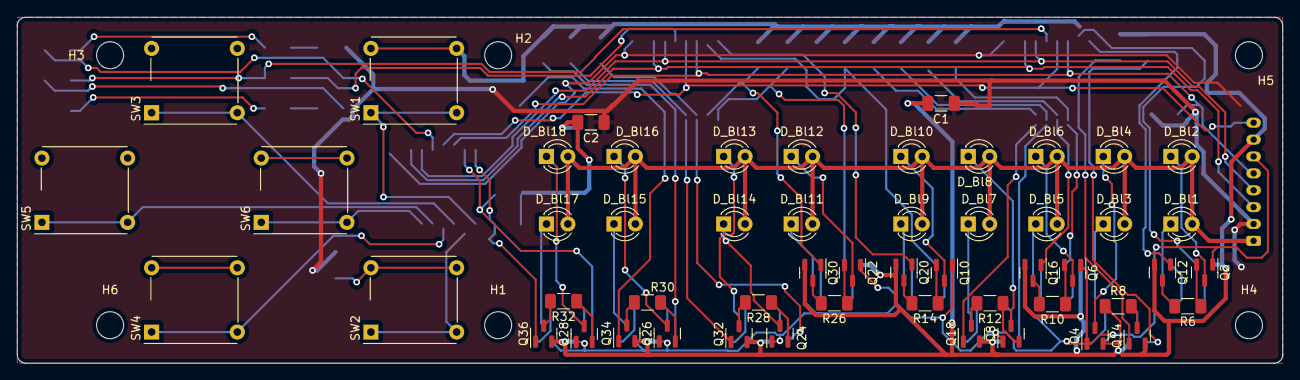
[picture p17: board StatusPCB.kicad_pcb from above]

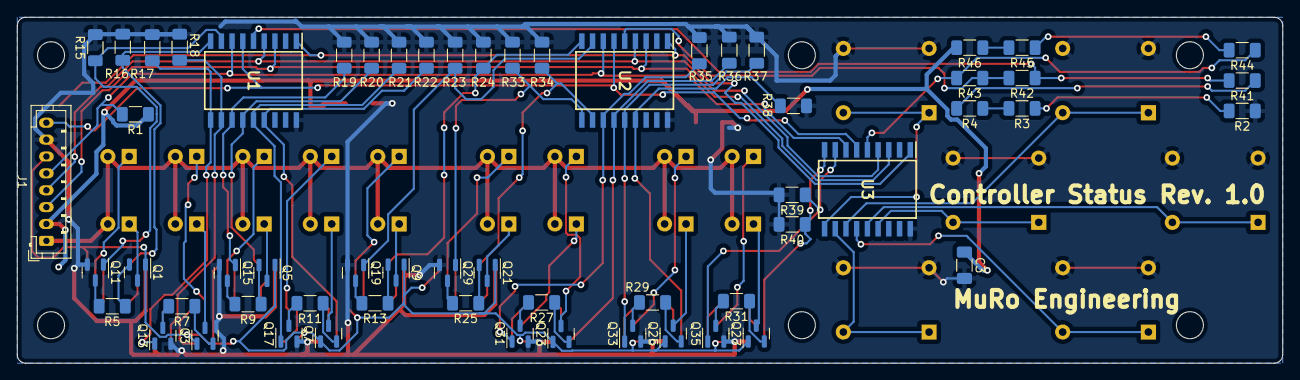
[picture p18: board StatusPCB.kicad_pcb from below]

Board: 2 copper layers, 150.0 x 41.0 mm, 119 parts (60 on the bottom side), 94 nets.
