RolandMueller1994/ControllerV2/Display/DisplayPCB/DisplayPCB.kicad_pcb

## KiCad design Display/DisplayPCB/DisplayPCB.kicad_pcb (2022-10-18)

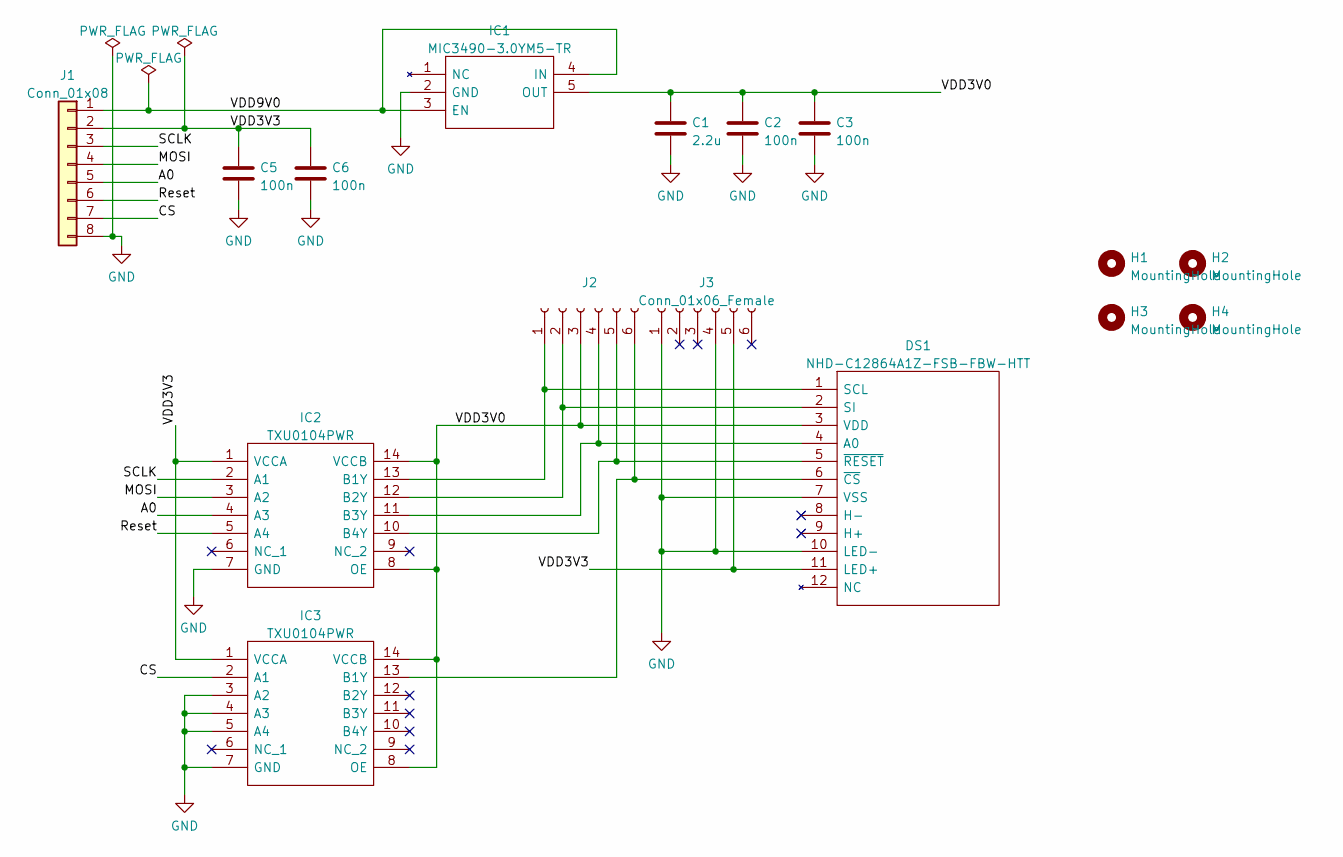
[picture p19: schematic DisplayPCB.kicad_sch]

Parts:
C1: 2.2u; C_1206_3216Metric_Pad1.33x1.80mm_HandSolder
C2, C3, C5, C6: 100n; C_1206_3216Metric_Pad1.33x1.80mm_HandSolder
DS1: NHD-C12864A1Z-FSB-FBW-HTT; NHDC12864A1ZFSBFBWHTT; Manufacturer_Part_Number NHD-C12864A1Z-FSB-FBW-HTT; Mouser Part Number 763-C12864A1ZFSBFBWH
H1, H2, H3, H4: MountingHole; MountingHole_3.2mm_M3
IC1: MIC3490-3.0YM5-TR; SOT95P280X145-5N; Manufacturer_Part_Number MIC3490-3.0YM5-TR; Mouser Part Number 579-MIC349030YM5TR
IC2, IC3: TXU0104PWR; SOP65P640X120-14N; Manufacturer_Part_Number TXU0104PWR; Mouser Part Number 595-TXU0104PWR
J1: Conn_01x08; JST_PH_B8B-PH-K_1x08_P2.00mm_Vertical
J2: (no value)
J3: Conn_01x06_Female

Connections:
/A0: IC2.4 (A3), J1.5
/CS: IC3.2 (A1), J1.7
/MOSI: IC2.3 (A2), J1.4
/Reset: IC2.5 (A4), J1.6
/SCLK: IC2.2 (A1), J1.3
/VDD3V0: C1.1, C2.1, C3.1, DS1.3 (VDD), IC1.5 (OUT), IC2.8 (OE), IC2.14 (VCCB), IC3.8 (OE), IC3.14 (VCCB), J2.3
/VDD3V3: C5.1, C6.1, DS1.11 (LED+), IC2.1 (VCCA), IC3.1 (VCCA), J1.2, J3.5
/VDD9V0: IC1.3 (EN), IC1.4 (IN), J1.1
GND: C1.2, C2.2, C3.2, C5.2, C6.2, DS1.7 (VSS), DS1.10 (LED-), IC1.2 (GND), IC2.7 (GND), IC3.3 (A2), IC3.4 (A3), IC3.5 (A4), IC3.7 (GND), J1.8, J3.1, J3.4
unnamed: DS1.1 (SCL), IC2.13 (B1Y), J2.1
unnamed: DS1.2 (SI), IC2.12 (B2Y), J2.2
unnamed: DS1.4 (A0), IC2.11 (B3Y), J2.4
unnamed: DS1.5 (~RESET), IC2.10 (B4Y), J2.5
unnamed: DS1.6 (~CS), IC3.13 (B1Y), J2.6

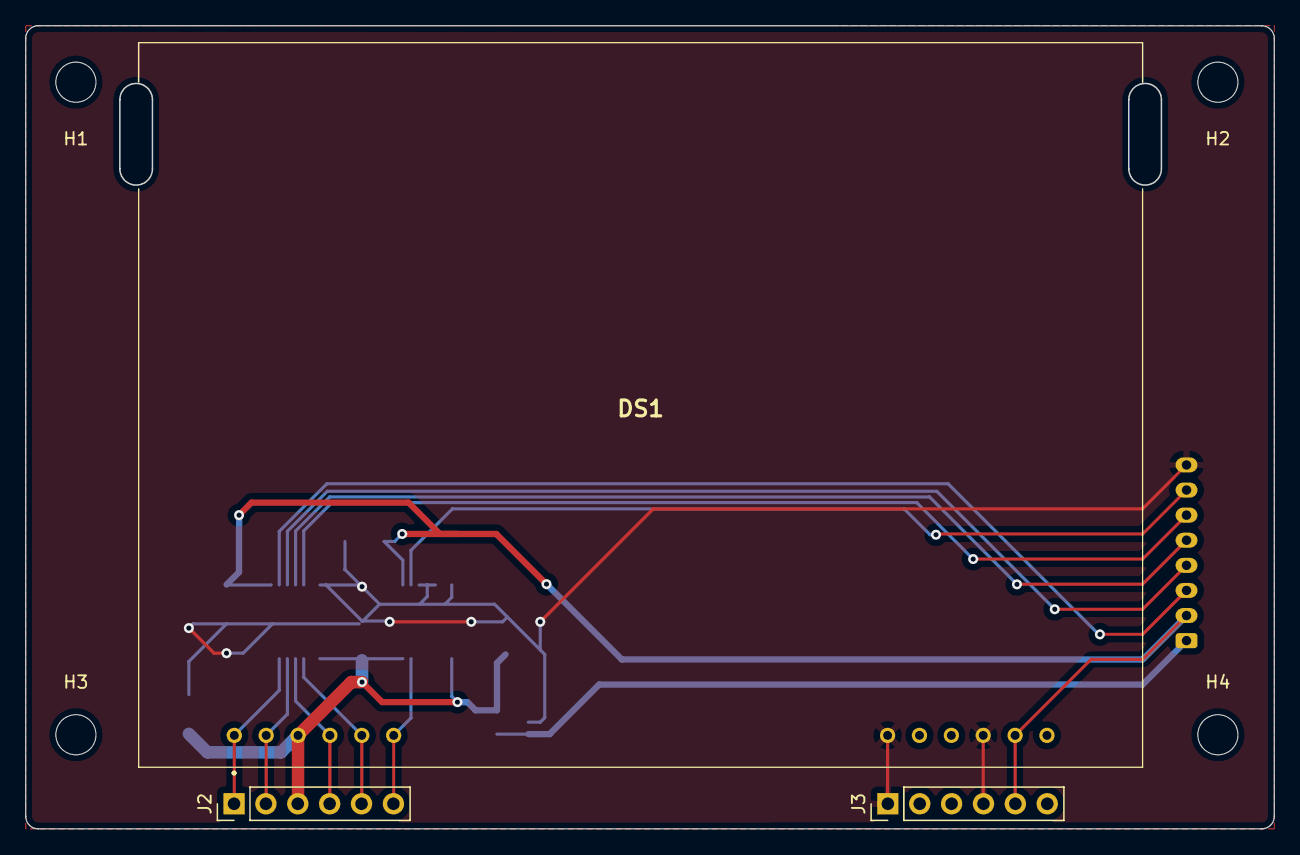
[picture p20: board DisplayPCB.kicad_pcb from above]

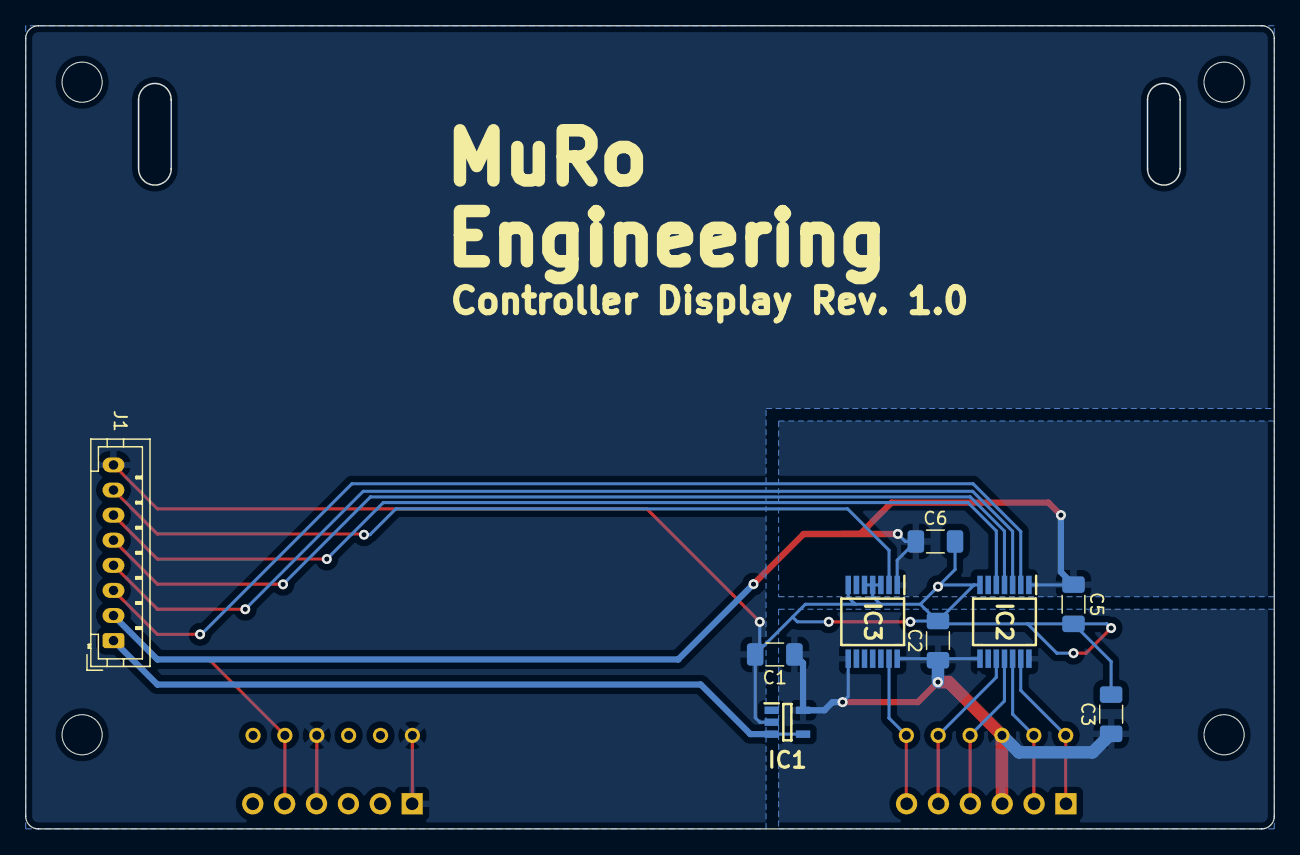
[picture p21: board DisplayPCB.kicad_pcb from below]

Board: 2 copper layers, 99.5 x 64.0 mm, 16 parts (9 on the bottom side), 14 nets.
