RolandMueller1994/ControllerV2/SwitchPCB/switchpcb_v2_right/switchpcb_v2_right.kicad_pcb

## KiCad design SwitchPCB/switchpcb_v2_right/switchpcb_v2_right.kicad_pcb (2022-10-18)

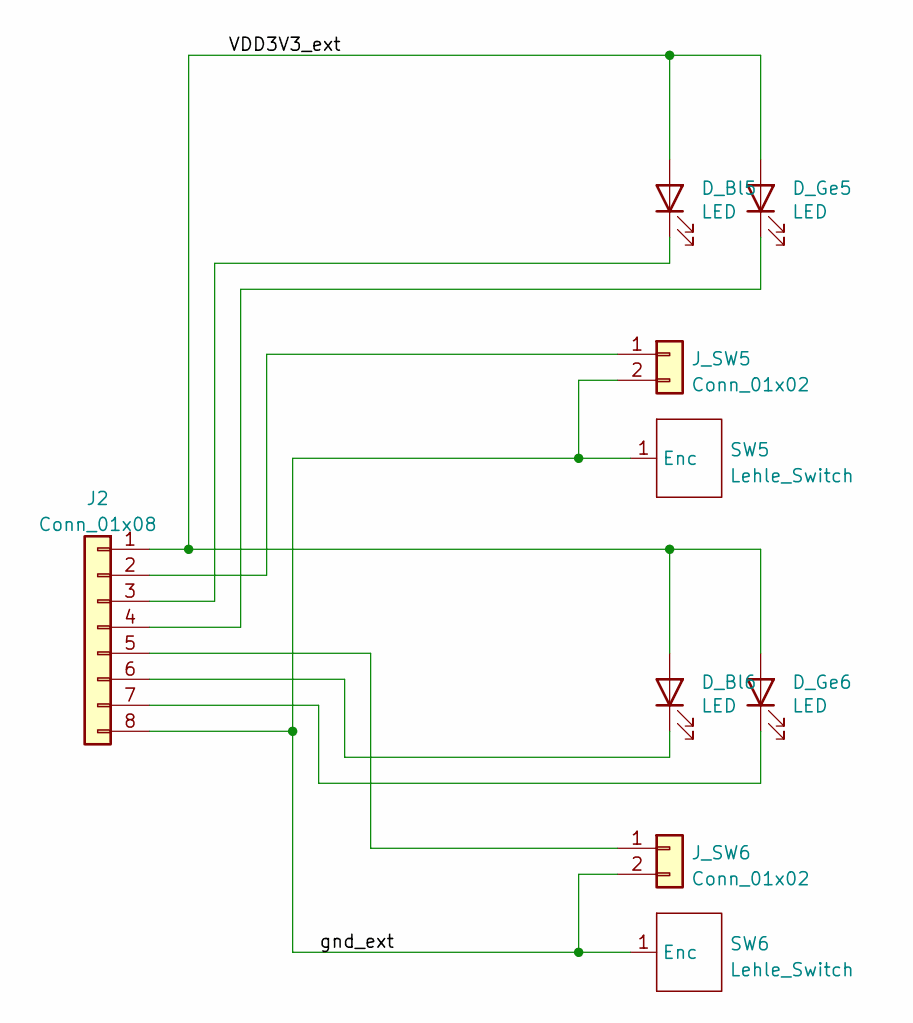
[picture p22: schematic switchpcb_v2_right.kicad_sch]

Parts:
D_Bl5, D_Bl6: LED; LED_D3.0mm
D_Ge5, D_Ge6: LED; LED_D3.0mm
J2: Conn_01x08; JST_PH_B8B-PH-K_1x08_P2.00mm_Vertical
J_SW5, J_SW6: Conn_01x02; JST_PH_B2B-PH-K_1x02_P2.00mm_Vertical
SW5, SW6: Lehle_Switch; LehleSwitch

Connections:
/VDD3V3_ext: D_Bl5.2 (A), D_Bl6.2 (A), D_Ge5.2 (A), D_Ge6.2 (A), J2.1
/gnd_ext: J2.8, J_SW5.2, J_SW6.2, SW5.1 (Enc), SW6.1 (Enc)
unnamed: D_Bl5.1 (K), J2.3
unnamed: D_Bl6.1 (K), J2.6
unnamed: D_Ge5.1 (K), J2.4
unnamed: D_Ge6.1 (K), J2.7
unnamed: J2.2, J_SW5.1
unnamed: J2.5, J_SW6.1

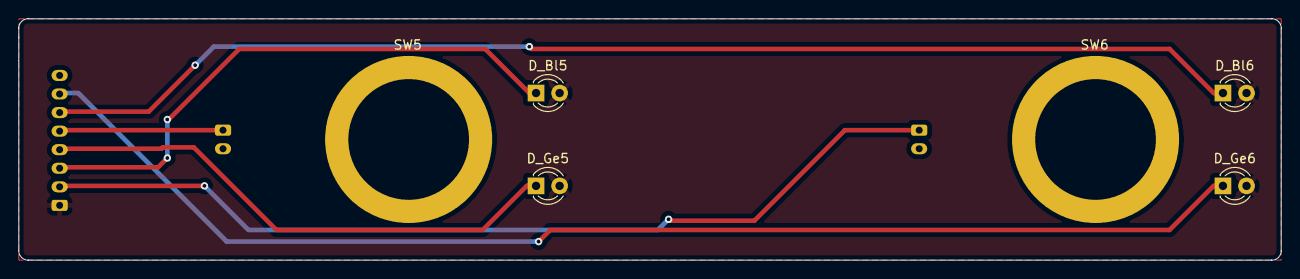
[picture p23: board switchpcb_v2_right.kicad_pcb from above]

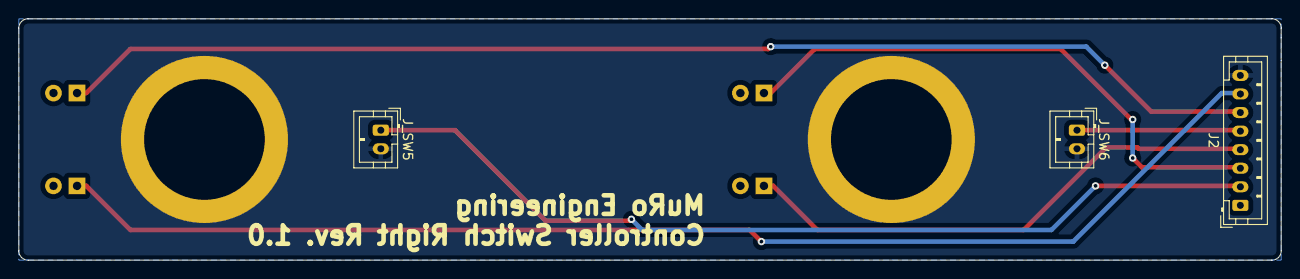
[picture p24: board switchpcb_v2_right.kicad_pcb from below]

Board: 2 copper layers, 136.0 x 26.0 mm, 9 parts (3 on the bottom side), 8 nets.
