RolandMueller1994/ControllerV2/controllerv2_1/controllerv2_1.ino

#include <Arduino.h>
#include <U8g2lib.h>
#include "Adafruit_FRAM_SPI.h"
#include <MIDI.h>

#include "Adafruit_MCP23X08.h"

#include <ShiftRegister74HC595.h>

#define REF_BLUE 6
#define REF_GREEN 7
#define REF_STATUS 8

#define I2C_RESET 12

#define EN_MATRIX 33
#define OE_MATRIX 34
#define SER_MATRIX 35
#define SRCLK_MATRIX 36
#define SRCLR_MATRIX 37
#define RCLK_MATRIX 38

#define OE_LOWER 13
#define SER_LOWER 31
#define SRCLK_LOWER 30
#define SRCLR_LOWER 29
#define RCLK_LOWER 28

#define OE_UPPER 43
#define SER_UPPER 47
#define SRCLK_UPPER 46
#define SRCLR_UPPER 45
#define RCLK_UPPER 44


ShiftRegister74HC595<10> regMatrix(SER_MATRIX, SRCLK_MATRIX, RCLK_MATRIX);
uint8_t regMatrixValues[10];

ShiftRegister74HC595<2> regLower(SER_LOWER, SRCLK_LOWER, RCLK_LOWER);
uint8_t regLowerValues[2];

ShiftRegister74HC595<2> regUpper(SER_UPPER, SRCLK_UPPER, RCLK_UPPER);
uint8_t regUpperValues[2];

Adafruit_MCP23X08 mcp_matrix1;
Adafruit_MCP23X08 mcp_matrix2;
Adafruit_MCP23X08 mcp_matrix3;
Adafruit_MCP23X08 mcp_status1;
Adafruit_MCP23X08 mcp_status2;
Adafruit_MCP23X08 mcp_status3;

#define INT_MATRIX 32
#define INT_STATUS 42

#include "linkedList.h"

#ifdef U8X8_HAVE_HW_SPI
#include <SPI.h>
#endif
#ifdef U8X8_HAVE_HW_I2C
#include <Wire.h>
#endif

bool serialOn = false;

MIDI_CREATE_INSTANCE(HardwareSerial, Serial1, midiInst);

#ifdef __arm__
// should use uinstd.h to define sbrk but Due causes a conflict
extern "C" char* sbrk(int incr);
#else  // __ARM__
extern char *__brkval;
#endif  // __arm__

void SerialMuted(char * text) {
  if(serialOn)
    Serial.print(text);
}

void SerialMuted(int text) {
  if(serialOn)
    Serial.print(text);
}

void SerialMuted(float text) {
  if(serialOn)
    Serial.print(text);
}

int freeMemory() {
  char top;
#ifdef __arm__
  return &top - reinterpret_cast<char*>(sbrk(0));
#elif defined(CORE_TEENSY) || (ARDUINO > 103 && ARDUINO != 151)
  return &top - __brkval;
#else  // __arm__
  return __brkval ? &top - __brkval : &top - __malloc_heap_start;
#endif  // __arm__
}

void printFreeMemory() {
  /*SerialMuted("Memory: ");
  SerialMuted(freeMemory());
  SerialMuted("\n");*/
}

U8G2_ST7565_NHD_C12864_F_4W_HW_SPI u8g2(U8G2_R2, /* cs=*/ 4, /* dc=*/ 3, /* reset=*/ 2);
Adafruit_FRAM_SPI fram = Adafruit_FRAM_SPI(10);
uint8_t addrSizeInBytes = 3;

int loopDelay = 1;
int loopOrderDelay = 400 / loopDelay;
int debounceDelay = 10;
int tapTempoDelay = 4;
int longPressDelay = 1000 / loopDelay;
int menuClockDelay = 350 / loopDelay;
int menuClockDelayFast = 150 / loopDelay;
int storeDelay = 1000;
int exprDelay = 50/loopDelay;
int readMatrixDelay = 100/loopDelay;
int readMatrixCount = 0;
bool readMatrixFlag = false;

int exprCount = 0;

const int noBanks = 10;
const int noPresets = 10;

int maxNoPresets = 20;
int bank = 1;
int presetBank = 10;
int preset = 10;

uint8_t brightness = 50;
uint8_t brightnessStomp = 50;
uint8_t brightnessStatus = 50;

uint8_t midiInChannel = 1;
uint8_t midiBankCtrl = 1;
bool midiInOn = true;
bool midiOutOn = true;
bool midiThroughOn = true;

linkedList * presetList = newList();

const int noMidiMsg = 16;
const int noTapTempo = 3;
const int noLoops = 10;
const int noOuts = 2;
const int noMixers = 2;
const int noCtrl = 4;
const int noExpr = 2;

uint16_t exprVals[noExpr];
int exprDelta = 1;
int exprMax = pow(2, 8) - 1;
int exprPins[] = {A0, A1};

char header[25];
bool phaseReverse[noLoops + noOuts - 1];
int stereoLoops[noLoops/2];

const uint32_t stereoLoopsAddr = 0;
const uint32_t phaseReverseAddr = sizeof(stereoLoops);
const uint32_t bankAddr = phaseReverseAddr + sizeof(phaseReverse);
const uint32_t midiInChannelAddr = bankAddr + sizeof(bank);
const uint32_t midiInOnAddr = midiInChannelAddr + sizeof(midiInChannel);
const uint32_t midiOutOnAddr = midiInOnAddr + sizeof(midiInOn);
const uint32_t midiThroughOnAddr = midiOutOnAddr + sizeof(midiOutOn);
const uint32_t midiBankCtrlAddr = midiThroughOnAddr + sizeof(midiThroughOn);
const uint32_t brightnessAddr = midiBankCtrlAddr + sizeof(midiBankCtrl);
const uint32_t brightnessStompAddr = brightnessAddr + sizeof(brightness);
const uint32_t brightnessStatusAddr = brightnessStompAddr + sizeof(brightnessStomp);

const uint32_t presetStartAddr = 1024;

void saveMidiBankCtrl() {
  fram.writeEnable(true);
  fram.write(midiBankCtrlAddr, (uint8_t*)&midiBankCtrl, sizeof(midiBankCtrl));
  fram.writeEnable(false);
}

void readMidiBankCtrl() {
  fram.read(midiBankCtrlAddr, (uint8_t*)&midiBankCtrl, sizeof(midiBankCtrl));
}

void saveMidiInChannel() {
  fram.writeEnable(true);
  fram.write(midiInChannelAddr, (uint8_t*)&midiInChannel, sizeof(midiInChannel));
  fram.writeEnable(false);
}

void readMidiInChannel() {
  fram.read(midiInChannelAddr, (uint8_t*)&midiInChannel, sizeof(midiInChannel));
}

void saveMidiInOn() {
  fram.writeEnable(true);
  fram.write(midiInOnAddr, (uint8_t*)&midiInOn, sizeof(midiInOn));
  fram.writeEnable(false);
}

void readMidiInOn() {
  fram.read(midiInOnAddr, (uint8_t*)&midiInOn, sizeof(midiInOn));
}

void saveMidiOutOn() {
  fram.writeEnable(true);
  fram.write(midiOutOnAddr, (uint8_t*)&midiOutOn, sizeof(midiOutOn));
  fram.writeEnable(false);
}

void readMidiOutOn() {
  fram.read(midiOutOnAddr, (uint8_t*)&midiOutOn, sizeof(midiOutOn));
}

void saveMidiThroughOn() {
  fram.writeEnable(true);
  fram.write(midiThroughOnAddr, (uint8_t*)&midiThroughOn, sizeof(midiThroughOn));
  fram.writeEnable(false);
}

void readMidiThroughOn() {
  fram.read(midiThroughOnAddr, (uint8_t*)&midiThroughOn, sizeof(midiThroughOn));
}

void saveStereoLoops() {
  fram.writeEnable(true);
  fram.write(stereoLoopsAddr, (uint8_t*)&stereoLoops, sizeof(stereoLoops));
  fram.writeEnable(false);
}

void readStereoLoops() {
  fram.read(stereoLoopsAddr, (uint8_t*)&stereoLoops, sizeof(stereoLoops));
}

void savePhaseReverse() {
  fram.writeEnable(true);
  fram.write(phaseReverseAddr, (uint8_t*)&phaseReverse, sizeof(phaseReverse));
  fram.writeEnable(false);
}

void readPhaseReverse() {
  fram.read(phaseReverseAddr, (uint8_t*)&phaseReverse, sizeof(phaseReverse));
}

void saveBank() {
  fram.writeEnable(true);
  fram.write(bankAddr, (uint8_t*)&bank, sizeof(int));
  fram.writeEnable(false);
}

void readBank() {
  fram.read(bankAddr, (uint8_t*)&bank, sizeof(int));
}

int calculateBrightness(int percent) {
  return (int) (pow(((float)percent * 0.85 + 15)/100, 3) * 255);
}

void saveBrightness() {
  if(brightness > 100)
    brightness = 100;
  else if(brightness < 0)
    brightness = 0;
  
  fram.writeEnable(true);
  fram.write(brightnessAddr, (uint8_t*)&brightness, sizeof(uint8_t));
  fram.writeEnable(false);
  analogWrite(REF_BLUE, calculateBrightness(brightness));
}

void readBrightness() {
  fram.read(brightnessAddr, (uint8_t*)&brightness, sizeof(uint8_t));
  if(brightness > 100)
    brightness = 100;
  else if(brightness < 0)
    brightness = 0;
  analogWrite(REF_BLUE, calculateBrightness(brightness));
}

void saveBrightnessStomp() {
  if(brightnessStomp > 100)
    brightnessStomp = 100;
  else if(brightnessStomp < 0)
    brightnessStomp = 0;
  fram.writeEnable(true);
  fram.write(brightnessStompAddr, (uint8_t*)&brightnessStomp, sizeof(uint8_t));
  fram.writeEnable(false);
  analogWrite(REF_GREEN, calculateBrightness(brightnessStomp));
}

void readBrightnessStomp() {
  fram.read(brightnessStompAddr, (uint8_t*)&brightnessStomp, sizeof(uint8_t));
  if(brightnessStomp > 100)
    brightnessStomp = 100;
  else if(brightnessStomp < 0)
    brightnessStomp = 0;
  analogWrite(REF_GREEN, calculateBrightness(brightnessStomp));
}

void saveBrightnessStatus() {
  if(brightnessStatus > 100)
    brightnessStatus = 100;
  else if(brightnessStatus < 0)
    brightnessStatus = 0;
  fram.writeEnable(true);
  fram.write(brightnessStatusAddr, (uint8_t*)&brightnessStatus, sizeof(uint8_t));
  fram.writeEnable(false);
  analogWrite(REF_STATUS, calculateBrightness(brightnessStatus));
}

void readBrightnessStatus() {
  fram.read(brightnessStatusAddr, (uint8_t*)&brightnessStatus, sizeof(uint8_t));
  if(brightnessStatus > 100)
    brightnessStatus = 100;
  else if(brightnessStatus < 0)
    brightnessStatus = 0;
  analogWrite(REF_STATUS, calculateBrightness(brightnessStatus));
}

bool programm = false;

int noMenuPins = 6;
int enterPin = 2;
int backPin = 3;
int upPin = 4;
int downPin = 5;
int leftPin = 6;
int rightPin = 7;
int menuPins[] = {enterPin, backPin, upPin, downPin, leftPin, rightPin};
bool menuMcpVals[] = {false, false, false, false, false, false};
bool menuEdges[] = {false, false, false, false, false, false};
bool menuDetect[] = {false, false, false, false, false, false};
int menuCount[] = {0, 0, 0, 0, 0, 0};
int menuLongCount[] = {0, 0, 0, 0, 0, 0};
bool menuLongPressDetect[] = {false, false, false, false, false, false};
bool menuLongPress[] = {false, false, false, false, false, false};
int menuClockCount[] = {0, 0, 0, 0, 0, 0};
bool menuClock[] = {false, false, false, false, false, false};
int menuClockFastCount[] = {0, 0, 0, 0, 0, 0};
bool menuClockFast[] = {false, false, false, false, false, false};
bool menuClockDetect[] = {false, false, false, false, false, false};
bool menuNegEdges[] = {false, false, false, false, false, false};
bool menuNegDetect[] = {false, false, false, false, false, false};
bool menuNegDetectFlag[] = {false, false, false, false, false, false};
int menuNegCount[] = {0, 0, 0, 0, 0, 0};

int noPresetPins = 10;
int presetPins[] = {22, 23, 24, 25, 27, 26, 50, 51, 52, 53};
int presetEdges[] = {false, false, false, false, false, false, false, false, false, false};
bool presetDetect[] = {false, false, false, false, false, false, false, false, false, false};
int presetCount[] = {0, 0, 0, 0, 0, 0, 0, 0, 0, 0};

bool loopConnsSend[] = {false, false, false, false, false, false, false, false, false, false};
bool loopConnsReturn[] = {false, false, false, false, false, false, false, false, false, false};
bool outConns[] = {false, false};
bool exprConns[] = {false, false};


const uint8_t outIds[] = {20, 21};
const uint8_t mixerIds[] = {30, 31};

enum midiTypes {midiPC = 0, midiCC = 1, expr1 = 2, expr2 = 3};
enum tapTypes {tapCC = 0, tapRemote1 = 1, tapRemote2 = 2, tapRemote3 = 3, tapRemote4 = 4};
enum stompModes {offStomp = 0, normalStomp = 1, permanentStomp = 2, toggleStomp = 3, permanentBankStomp = 4};

struct preset_t {

  uint8_t bankNo;
  uint8_t presetNo;
  char presetName[20];

  bool loopsOn[noLoops];
  bool outsOn[noOuts];
  bool outPhaseReverse[noOuts-1];
  bool tunerOn;
  uint8_t loopOrder[noLoops + noMixers][noOuts];

  bool ctrlOn[noCtrl];

  bool midiOn[noMidiMsg];
  midiTypes midiType[noMidiMsg];
  uint8_t midiChannel[noMidiMsg];
  uint8_t midiPC[noMidiMsg];
  uint8_t midiCC[noMidiMsg];
  uint8_t midiCCValue[noMidiMsg][2];

  bool tapOn[noTapTempo];
  tapTypes tapType[noTapTempo];
  uint8_t tapChannel[noTapTempo];
  uint8_t tapCC[noTapTempo];
  uint8_t tapCCOn[noTapTempo];
  uint8_t tapCCOff[noTapTempo];

  stompModes stompMode;

  uint8_t mixerUsed;
};

const uint32_t noActivatedPresetAddr = presetStartAddr + noBanks * noPresets * sizeof(preset_t);
const uint32_t activatedPresetAddr = noActivatedPresetAddr + sizeof(uint32_t);

bool checkActivePresets() {
  listItem* iter = presetList->first;
  bool hasPreset = false;
  while(iter) {
    preset_t* preset = (preset_t*) iter->item;
    if(preset->stompMode == offStomp) {
      hasPreset = true;
      break;
    }
    iter = (listItem*) iter->next;
  }
  return hasPreset;
}

void savePresetFnc(struct preset_t* presetVar, uint32_t addr) {
  fram.writeEnable(true);
  fram.write(addr, (uint8_t*) presetVar, sizeof(preset_t));
  fram.writeEnable(false);
}

void savePresetFncBankNPreset(struct preset_t* presetVar, uint8_t bank, uint8_t preset) {
  uint32_t addr = presetStartAddr + ((bank-1) * noPresets + preset-1) * sizeof(preset_t);
  savePresetFnc(presetVar, addr);
}

void readPresetFnc(struct preset_t* presetVar, uint32_t addr) {
  fram.read(addr, (uint8_t*) presetVar, sizeof(preset_t));
}

void readPresetFncBankNPreset(struct preset_t* presetVar, uint8_t bank, uint8_t preset) {
  uint32_t addr = presetStartAddr + ((bank-1) * noPresets + preset-1) * sizeof(preset_t);
  readPresetFnc(presetVar, addr);
}

void copyPreset(struct preset_t* source, struct preset_t* dest) {

  dest->tunerOn = source->tunerOn;
  for(int i = 0; i < noOuts; i++) { 
    dest->outsOn[i] = source->outsOn[i];
    if(i < noOuts-1) {
      dest->outPhaseReverse[i] = source->outPhaseReverse[i];
    }
  }
  for(uint8_t j = 0; j<noLoops + noMixers; j++) {
    dest->loopOrder[j][0] = source->loopOrder[j][0];
    dest->loopOrder[j][1] = source->loopOrder[j][1];
  }
  for(uint8_t i = 0; i < noCtrl; i++) {
    dest->ctrlOn[i] = source->ctrlOn[i];
  }
  for(int i=0; i<noMidiMsg; i++) {
    dest->midiOn[i] = source->midiOn[i];
    dest->midiType[i] = source->midiType[i];
    dest->midiChannel[i] = source->midiChannel[i];
    dest->midiPC[i] = source->midiPC[i];
    dest->midiCC[i] = source->midiCC[i];
    dest->midiCCValue[i][0] = source->midiCCValue[i][0];
    dest->midiCCValue[i][1] = source->midiCCValue[i][1];
  }
  for(int i=0; i<noTapTempo; i++) {
    dest->tapOn[i] = source->tapOn[i];
    dest->tapType[i] = source->tapType[i];
    dest->tapChannel[i] = source->tapChannel[i];
    dest->tapCC[i] = source->tapCC[i];
    dest->tapCCOn[i] = source->tapCCOn[i];
    dest->tapCCOff[i] = source->tapCCOff[i];
  }
  dest->stompMode = source->stompMode;
  dest->mixerUsed = source->mixerUsed;
}

void saveActivePresets() {
  uint32_t count = 0;
  listItem* iter = presetList->first;
  while(iter) {
    preset_t* preset = (preset_t*) iter->item;
    uint32_t addr = activatedPresetAddr + count * sizeof(preset_t);
    savePresetFnc(preset, addr);
    iter = (listItem*) iter->next;
    count++;
  }
  fram.writeEnable(true);
  fram.write(noActivatedPresetAddr, (uint8_t*)&count, sizeof(uint32_t));
  fram.writeEnable(false);
}

void checkExpr(int exprNo) {
  uint16_t exprVal = exprVals[exprNo];
  midiTypes exprTyp;
  switch(exprNo) {
    case 0: exprTyp = expr1; break;
    case 1: exprTyp = expr2; break;
  }
  listItem* iter = presetList->first;
  while(iter) {
    preset_t* preset = (preset_t*) iter->item;
    for(int i=0; i<noMidiMsg; i++) {
      if(preset->midiOn[i] && preset->midiType[i] == exprTyp) {
        uint8_t toeVal = preset->midiCCValue[i][1];
        uint8_t hellVal = preset->midiCCValue[i][0];
        float targetVal = hellVal + (toeVal - hellVal) / 127.0 * exprVal/exprMax * 127;
        SerialMuted("Writing Expr. CC ");
        SerialMuted(preset->midiCC[i]);
        SerialMuted(" ");
        SerialMuted(targetVal);
        SerialMuted(" ");
        SerialMuted(preset->midiChannel[i]);
        SerialMuted("\n");
        
        midiInst.sendControlChange((byte) preset->midiCC[i], (byte) targetVal, (byte) preset->midiChannel[i]);
      }
    }
    iter = (listItem*) iter->next;
  }
}

bool checkMidi = false;
bool checkExprOnLoad = false;

bool findNextLoop(uint8_t loopOrder[][2], uint8_t curLoops[], int * slot, int startSlot, int ch, bool parallel, int * mixerUsed, int * usedMixers, uint8_t usedMixerIds[]) {

  int count = 0;

  for(int slotNo = startSlot; slotNo < noLoops + noMixers; slotNo++) {
    if(!parallel) {
      if(loopOrder[slotNo][1] > 0 && loopOrder[slotNo][1] <= noLoops) {
        *slot = slotNo;
        return false;
      } else if(loopOrder[slotNo][0] > noLoops && *mixerUsed > 0) {
        // Unused Mixer
        *mixerUsed--;
      } else if(loopOrder[slotNo][0] > noLoops && *mixerUsed <= 0) {
        return true;
      } else if(loopOrder[slotNo][0] > 0) {
        SerialMuted("Default Loop Add\n");
        curLoops[count] = loopOrder[slotNo][0];
        count++;
      }
    } else {
      if(loopOrder[slotNo][ch] > noLoops && * mixerUsed > 0) {
        curLoops[count] = loopOrder[slotNo][ch];
        if(ch == 0) {
          usedMixerIds[*usedMixers] = loopOrder[slotNo][ch];
          *mixerUsed--;
          *usedMixers++;
          *slot = slotNo + 1;
        }
        return false;
      } else if(loopOrder[slotNo][ch] > noLoops && * mixerUsed <=0) {
        return true;
      } else if(loopOrder[slotNo][ch] > 0) {
        curLoops[count] = loopOrder[slotNo][ch];
        count++;
      }
    }
  }
  return true;
}

void writeOneRegVal(uint8_t sourceLoop, uint8_t targetLoop, bool sndCh, bool parallel) {
  int regAddr = 0;
  bool offset = false;
  bool isOut = false;
  if(targetLoop > 0 && targetLoop <= noLoops) {
    offset = (targetLoop - 1) % 2 > 0;
  } else {
    for(int i=0; i<noMixers; i++) {
      if(targetLoop == mixerIds[i]) {
        if(sndCh) {
          targetLoop = 14 + 2 * i;
          offset = true;
        } else {
          targetLoop = 13 + 2 * i;
          offset = false;
        }
      }
    }
    for(int i=0; i<2; i++) {
      if(targetLoop == outIds[i]) {
        isOut = true;
        targetLoop = 11 + i;
        offset = i % 2 > 0;
      }
    }
  }
  regAddr = (targetLoop-1)/2;

  if(offset) {
    regMatrixValues[regAddr] = (regMatrixValues[regAddr] & 0x0F) | ((sourceLoop << 4) & 0xF0);
  } else {
    regMatrixValues[regAddr] = (regMatrixValues[regAddr] & 0xF0) | (sourceLoop & 0x0F);
  }

  if(isOut && !parallel) {
    targetLoop = 12;
    offset = true;
    regAddr = (targetLoop-1)/2;
    if(offset) {
      regMatrixValues[regAddr] = (regMatrixValues[regAddr] & 0x0F) | ((sourceLoop << 4) & 0xF0);
    } else {
      regMatrixValues[regAddr] = (regMatrixValues[regAddr] & 0xF0) | (sourceLoop & 0x0F);
    }
  }
}

uint8_t writeRegVals(uint8_t curLoops[], bool loopOn[], uint8_t lastLoop, bool isEnd, bool toB, bool regValsSet[], bool parallel, bool mixerPhase[][2]) {
  bool phase = false;
  for(int i = 0; i<noLoops + noMixers; i++) {
    if(curLoops[i] == 0 && isEnd) {
      writeOneRegVal(lastLoop, outIds[toB ? 1 : 0], toB, parallel);
      if(toB) {
        mixerPhase[noMixers][1] = phase;
      } else {
        mixerPhase[noMixers][0] = phase;
      }
      return 0;
    } else if(curLoops[i] > noLoops) {
      writeOneRegVal(lastLoop, curLoops[i], toB, parallel);
      for(int mixerNo=0; mixerNo < noMixers; mixerNo++) {
        if(mixerIds[mixerNo] == curLoops[i]) {
          if(toB) {
            mixerPhase[mixerNo][1] = phase;
          } else {
            mixerPhase[mixerNo][0] = phase;
          }
        }
      }
      return curLoops[i];
    } else if(curLoops[i] > 0) {
      if(loopConnsReturn[curLoops[i] - 1] && loopOn[curLoops[i] - 1]) {
        SerialMuted("Write single reg val\n");
        writeOneRegVal(lastLoop, curLoops[i], toB, parallel);
        regValsSet[curLoops[i] - 1] = true;
        lastLoop = curLoops[i];
        if(phaseReverse[curLoops[i] - 1]) {
          phase = !phase;
        }
      }
    } else {
      return lastLoop;
    }
  }
}

void hardwareActivatePreset() {
  SerialMuted("Hardware Activate Start\n");
  listItem* iter = presetList->first;
  bool loopOn[noLoops];
  bool permanent[noLoops];
  bool outOn[2];
  bool outPermanent[2];
  bool ctrlOn[noCtrl];
  bool ctrlPermanent[noCtrl];
  bool tunerOn = false;
  bool tunerPermanent = false;
  bool phase = false;
  bool phasePermanent = false;
  uint8_t loopOrder[noLoops+noMixers][2];
  int mixersUsed = 0;
  for(int i=0; i<noLoops; i++) {
    loopOn[i] = false;
    permanent[i] = false;
  }
  for(int i=0; i<2; i++) {
    outOn[i] = false;
    outPermanent[i] = false;
  }
  for(int i=0; i<noCtrl; i++) {
    ctrlOn[i] = false;
    ctrlPermanent[i] = false;
  }
  while(iter) {
    preset_t* preset = (preset_t*) iter->item;
    SerialMuted("Bank: ");
    SerialMuted(preset->bankNo);
    SerialMuted(" Preset No: ");
    SerialMuted(preset->presetNo);
    SerialMuted(" Stomp Type: ");
    char* stompTypeCur;
    switch(preset->stompMode) {
      case offStomp: stompTypeCur = "Off"; break;
      case normalStomp: stompTypeCur = "Normal"; break;
      case permanentStomp: stompTypeCur = "Permanent"; break;
      case toggleStomp: stompTypeCur = "Toggle"; break;
      case permanentBankStomp: stompTypeCur = "Permanent Bank\n"; break;
      default: stompTypeCur = "Unset";
    }

    if(preset->stompMode == offStomp) {
      for(int i=0; i<noLoops + noMixers; i++) {
        loopOrder[i][0] = preset->loopOrder[i][0];
        loopOrder[i][1] = preset->loopOrder[i][1];
        mixersUsed = preset->mixerUsed;
      }
    }
    
    SerialMuted(stompTypeCur);
    SerialMuted(" Loops:\n");
    for(int i=0; i<noLoops; i++) {
      SerialMuted(" ");
      if(preset->loopsOn[i]) {
        SerialMuted(1);
        if(preset->stompMode == permanentStomp || preset->stompMode == permanentBankStomp) {
          permanent[i] = true;
        }
        if(preset->stompMode == toggleStomp) {
          if(!permanent[i]) {
            loopOn[i] = !loopOn[i];
          }
        } else {
          loopOn[i] = true;
        }
      } else {
        SerialMuted(0);
      }
    }
    for(int i=0; i<2; i++) {
      if((preset->stompMode == permanentStomp || preset->stompMode == permanentBankStomp) && preset->outsOn[i]) {
        outPermanent[i] = true;
      }
      if(preset->outsOn[i]) {
        if(preset->stompMode == toggleStomp && !outPermanent[i]) {
          outOn[i] = !outOn[i];
        } else {
          outOn[i] = true;
        }
      }
    }
    for(int i=0; i<noCtrl; i++) {
      if((preset->stompMode == permanentStomp || preset->stompMode == permanentBankStomp) && preset->ctrlOn[i]) {
        ctrlPermanent[i] = true;
      }
      if(preset->ctrlOn[i]) {
        if(preset->stompMode == toggleStomp && !ctrlPermanent[i]) {
          ctrlOn[i] = !ctrlOn[i];
        } else {
          ctrlOn[i] = true;
        }
      }
    }
    SerialMuted("\n");
    if((preset->stompMode == permanentStomp || preset->stompMode == permanentBankStomp) && preset->tunerOn) {
      tunerPermanent = true;
    }
    if(preset->tunerOn) {
      if(preset->stompMode == toggleStomp && !tunerPermanent) {
        tunerOn != tunerOn;
      } else {
        tunerOn = true;
      }
    }
    if((preset->stompMode == permanentStomp || preset->stompMode == permanentBankStomp) && preset->outPhaseReverse[0]) {
      phasePermanent = true;
    }
    if(preset->outPhaseReverse[0]) {
      if(preset->stompMode == toggleStomp && !tunerPermanent) {
        phase != phase;
      } else {
        phase = true;
      }
    }
    
    for(int j=0; j<2; j++) {
      for(int i=0; i<noLoops + noMixers; i++) {
        SerialMuted(" ");
        SerialMuted(preset->loopOrder[i][j]);
      }
      SerialMuted("\n");
    }
    SerialMuted("\n");
    iter = (listItem*) iter->next;
  }

  SerialMuted("All loops on: ");
  for(int i=0; i<noLoops; i++) {
    SerialMuted(" ");
    if(loopOn[i]) {
      SerialMuted(1);
    } else {
      SerialMuted(0);
    }
  }
  SerialMuted("\n");

  SerialMuted("Final loop order:\n");
  for(int j=0; j<2; j++) {
    for(int i=0; i<noLoops + noMixers; i++) {  
      SerialMuted(" ");
      SerialMuted(loopOrder[i][j]);
    }
    SerialMuted("\n");
  }
  SerialMuted("\n");

  bool parallel = false;
  int slot = 0;
  uint8_t lastLoop = 0;
  uint8_t usedMixerIds[noMixers];
  for(int i=0; i<noMixers; i++) {
    usedMixerIds[i] = 0;
  }
  bool regValSet[noLoops];
  for(int i=0; i<noLoops; i++) {
    regValSet[i] = false;
  }
  uint8_t curLoop1[noLoops + noMixers];
  uint8_t curLoop2[noLoops + noMixers];
  
  bool mixerPhase[noMixers + 1][2];
  bool isEnd = false;
  int actualUsedMixer = 0;

  for(int i=0; i<10; i++) {
    regMatrixValues[i] = 0;
  }
  
  while(true) {
    for(int i=0; i<noLoops + noMixers; i++) {
      curLoop1[i] = 0;
      curLoop2[i] = 0;
    }
    if(loopOrder[slot][1] > 0) {
      parallel = true;
    }
    int slotSaved = slot;
    isEnd = findNextLoop(loopOrder, curLoop1, &slot, slot, 0, parallel, &mixersUsed, &actualUsedMixer, usedMixerIds);
    SerialMuted("Lower Channel Loops:\n");
    for(int i=0; i< noLoops+noMixers; i++) {
      SerialMuted(curLoop1[i]);
      SerialMuted(" ");
    }
    SerialMuted(isEnd);
    SerialMuted("\n");
    int curLastLoop = writeRegVals(curLoop1, loopOn, lastLoop, isEnd, false, regValSet, parallel, mixerPhase);
    writeRegVals(curLoop1, loopOn, lastLoop, isEnd, false, regValSet, parallel, mixerPhase);
    if(parallel) {
      isEnd = findNextLoop(loopOrder, curLoop2, &slot, slotSaved, 1, parallel, &mixersUsed, &actualUsedMixer, usedMixerIds);
      if(!isEnd)
        parallel = false;
      SerialMuted("Upper Channel Loops:\n");
      for(int i=0; i< noLoops+noMixers; i++) {
        SerialMuted(curLoop2[i]);
        SerialMuted(" ");
      }
      SerialMuted(isEnd);
      SerialMuted("\n");
      writeRegVals(curLoop2, loopOn, lastLoop, isEnd, true, regValSet, parallel, mixerPhase);
    }
    lastLoop = curLastLoop;
    if(isEnd)
      break;
  }
  
  for(int i=0; i<noLoops; i++) {
    if(!regValSet[i]) {
      writeOneRegVal(12, i+1, false, false);
    }
  }

  for(int i=0; i<2; i++) {
    if(!outOn[i]) {
      writeOneRegVal(12, outIds[i], false, false);
    }
  }

  uint8_t mixerConfig = 0b10000000;
  for(int i=0; i<noMixers; i++) {
    uint8_t mixId = mixerIds[i];
    bool found = false;
    for(int j=0; j<noMixers; j++) {
      if(usedMixerIds[j] == mixId) {
        found = true;
        break;
      }
    }
    if(!found) {
      // uint8_t sourceLoop, uint8_t targetLoop, bool sndCh, bool parallel
      writeOneRegVal(12, mixId, false, false);
      writeOneRegVal(12, mixId, true, false);
      if(i==0) {
        mixerConfig = (mixerConfig & 0b11111011) | 0b00000100;
      } else {
        mixerConfig = (mixerConfig & 0b11011111) | 0b00100000;
      }
    } else {
      if(i==0) {
        // Gain 0.5
        mixerConfig = (mixerConfig & 0b11111110) | 0b00000001;
        if(mixerPhase[i][0] != mixerPhase[i][1]) {
          SerialMuted("Mixer 1 Phase Difference\n");
          mixerConfig = (mixerConfig & 0b11111001) | 0b00000100;
        } else {
          SerialMuted("Mixer 1 No Phase Difference\n");
          mixerConfig = (mixerConfig & 0b11111001) | 0b00000010;
        }
      } else {
        // Gain 0.5
        mixerConfig = (mixerConfig & 0b11110111) | 0b00001000;
        if(mixerPhase[i][0] != mixerPhase[i][1]) {
          SerialMuted("Mixer 2 Phase Difference\n");
          mixerConfig = (mixerConfig & 0b11001111) | 0b00100000;
        } else {
          SerialMuted("Mixer 2 No Phase Difference\n");
          mixerConfig = (mixerConfig & 0b11001111) | 0b00010000;
        }
      }
    }
  }
  
  regMatrixValues[8] = mixerConfig;
  //regMatrixValues[9] = 0x20;

  SerialMuted("Register Values: \n");
  for(int i=9; i>=0; i--) {
    char hexVal[10];
    sprintf(hexVal, "%02x ", regMatrixValues[i]);
    SerialMuted(hexVal);
  }
  SerialMuted("\n\n");

  regMatrix.setAll(regMatrixValues);

  SerialMuted("\n");
  if(checkMidi && midiOutOn) {
    checkMidi = false;
    preset_t* preset = (preset_t*) presetList->last->item;
    for(int i=0; i<noMidiMsg; i++) {
      if(preset->midiOn[i]) {
        if(preset->midiType[i] == midiPC) {
          SerialMuted("Midi PC send: ");
          SerialMuted(preset->midiPC[i]);
          SerialMuted(" ");
          SerialMuted(preset->midiChannel[i]);
          SerialMuted("\n");
          midiInst.sendProgramChange((byte) preset->midiPC[i], (byte) preset->midiChannel[i]);
        } else if(preset->midiType[i] == midiCC) {
          midiInst.sendControlChange((byte) preset->midiCC[i], (byte) preset->midiCCValue[i][0], (byte) preset->midiChannel[i]);
          SerialMuted("Midi CC send: ");
          SerialMuted(preset->midiCC[i]);
          SerialMuted(" ");
          SerialMuted(preset->midiChannel[i]);
          SerialMuted(" ");
          SerialMuted(preset->midiCCValue[i][0]);
          SerialMuted("\n");
        }
      }
    }
  }
  if(checkExprOnLoad) {
    for(int i=0; i<noExpr; i++) {
      checkExpr(i);
    }
  }

  iter = presetList->first;

  uint8_t * regVals;

  for(int i=0; i<2; i++) {
    regLowerValues[i] = 0;
    regUpperValues[i] = 0;
  }
  
  while(iter) {
    preset_t * curPreset = (preset_t*) iter->item;
    int presetNo = 0;
    if(curPreset->presetNo > 6) {
      // upper
      presetNo = curPreset->presetNo - 6;
      regVals = regUpperValues;
    } else {
      // lower
      regVals = regLowerValues;
      presetNo = curPreset->presetNo;
    }

    if(presetNo == 1) {
      regVals[0] |= 0x01;
    } else if(presetNo == 2) {
      regVals[0] |= 0x04;
    } else if(presetNo == 3) {
      regVals[0] |= 0x10;
    } else if(presetNo == 4) {
      regVals[1] |= 0x02;
    } else if(presetNo == 5) {
      regVals[1] |= 0x08;
    } else if(presetNo == 6) {
      regVals[1] |= 0x20;
    }
    
    iter = (listItem*) iter->next;


  }

  for(int i=0; i < noPresets; i++) {
    
  }
  
  SerialMuted("Reg Lower\n");
  for(int i=0; i<2; i++) {
    SerialMuted(regLowerValues[i]);
    SerialMuted(" ");
  }
  SerialMuted("\n");
  SerialMuted("Reg Upper\n");
  for(int i=0; i<2; i++) {
    SerialMuted(regUpperValues[i]);
    SerialMuted(" ");
  }
  SerialMuted("\n");
  
  for(uint8_t presetNo1=0; presetNo1 < noPresets; presetNo1++) {
    preset_t* curPreset = new preset_t;
    readPresetFncBankNPreset(curPreset, bank, presetNo1);
    int presetNo = 0;
    if(curPreset->presetNo > 6) {
      // upper
      presetNo = curPreset->presetNo - 6;
      regVals = regUpperValues;
    } else {
      // lower
      regVals = regLowerValues;
      presetNo = curPreset->presetNo;
    }

    if(curPreset->stompMode != offStomp) {
      if(presetNo == 1) {
        regVals[0] |= 0x02;
      } else if(presetNo == 2) {
        regVals[0] |= 0x08;
      } else if(presetNo == 3) {
        regVals[1] |= 0x01;
      } else if(presetNo == 4) {
        regVals[1] |= 0x04;
      } else if(presetNo == 5) {
        regVals[1] |= 0x10;
      } else if(presetNo == 6) {
        regVals[1] |= 0x40;
      }
    }
    delete curPreset;
  }

  regLower.setAll(regLowerValues);
  regUpper.setAll(regUpperValues);
  
  SerialMuted("Hardware Activate End\n");
  printFreeMemory();

  uint8_t statusMcpVals[3];

  for(int i=0; i<3; i++) {
    statusMcpVals[i] = 0x00;
  }

  Adafruit_MCP23X08* curMcp;

  for(int i=0; i<noLoops; i++) {
    if(loopOn[i]) {
      if(i > 4) {
        statusMcpVals[i > 8 ? 1 : 0] |= 0x01 << ((2*(i-5))%8);  
      } else {
        statusMcpVals[i >= 4 ? 1 : 0] |= 0x01 << ((2*i + 1)%8);  
      }
      
    }
  }
  SerialMuted("Ctrls: ");
  uint8_t ctrlShift[] = {3, 4, 2, 5};
  for(int i=0; i<noCtrl; i++) {
    SerialMuted(ctrlOn[i]);
    SerialMuted(" ");
    if(ctrlOn[i]) {
      statusMcpVals[ctrlShift[i]/8 + 1] |= 0x01 << (ctrlShift[i] % 8); 
    }
  }
  SerialMuted("\n");

  uint8_t outShift[] = {7, 9};
  for(int i=0; i<2; i++) {
    if(outOn[i]) {
      statusMcpVals[outShift[i]/8 + 1] |= 0x01 << (outShift[i] % 8); 
    }
  }

  if(tunerOn) {
    SerialMuted("Tuner On\n");
    statusMcpVals[2] |= 0x01;
  }
  if(phase) {
    statusMcpVals[1] |= 0x1 << 6;
  }

  mcp_status1.writeGPIO(statusMcpVals[0]);
  mcp_status2.writeGPIO(statusMcpVals[1]);  
  mcp_status3.writeGPIO(statusMcpVals[2]);
  
}

bool keepLast = false;

bool activatePreset(uint8_t bankNo, uint8_t presetNo) {
  preset_t* newPreset = new preset_t;
  readPresetFncBankNPreset(newPreset, bankNo, presetNo);
  bool toAppend = false;
  bool keepLastAppend = false;
  uint8_t keepBank = 0;
  uint8_t keepPreset = 0;
  bool presetAlreadyActive = false;
  if(newPreset->stompMode == offStomp) {
    int deleteCount = 0;
    preset_t* deletePresets[maxNoPresets];

    listItem* iter = presetList->first;
    while(iter) {
      if(iter == presetList->last && keepLast) {
        preset_t* keepPresetPtr = (preset_t*) iter->item;
        keepLastAppend = true;
        keepBank = keepPresetPtr->bankNo;
        keepPreset = keepPresetPtr->presetNo;
      }
      preset_t* item = (preset_t*) iter->item;
      if(item->stompMode == normalStomp || item->stompMode == toggleStomp || item->stompMode == offStomp) {
        deletePresets[deleteCount] = item;
        deleteCount++;
      } else if(item->stompMode == permanentBankStomp && item->bankNo != newPreset->bankNo) {
        deletePresets[deleteCount] = item;
        deleteCount++;
      }
      if(item->bankNo == bankNo && item->presetNo == presetNo) {
        presetAlreadyActive = true;
      }
      iter = (listItem*) iter->next;
    } 

    for(int i=0; i<deleteCount; i++) {
      deleteItem(presetList, deletePresets[i]);
      delete deletePresets[i];
    }
    toAppend = true;
  } else {
    preset_t* deletePreset = NULL;
    preset_t* activePreset;
    listItem* iter =  presetList->first;
    while(iter) {
      activePreset = (preset_t*) iter->item;
      if(activePreset->bankNo == bankNo && activePreset->presetNo == presetNo) {
        deletePreset = activePreset;
        toAppend = false;
      }
      if(iter == presetList->last && keepLast) {
        keepLastAppend = true;
        keepBank = activePreset->bankNo;
        keepPreset = activePreset->presetNo;
      }
      iter = (listItem*) iter->next;
    }
    if(deletePreset) {
      deleteItem(presetList, deletePreset);
      delete deletePreset;
    }
    else
      toAppend = true;
  }
  if(toAppend) {
    listAppend(presetList, newPreset);
    checkMidi = true;
    checkExprOnLoad = true;
  }
  else
    delete newPreset;
  keepLast = false;
  if(keepLastAppend) {
    bool checkMidiSave = checkMidi;
    activatePreset(keepBank, keepPreset);
    checkMidi = checkMidiSave;
  }
  if(listLength(presetList) >= maxNoPresets) {
    preset_t* toDelete = (preset_t*) deleteIdx(presetList, 0);
    delete toDelete;
  }
  printFreeMemory();
  hardwareActivatePreset();
  saveActivePresets();
  return presetAlreadyActive;
}

void findBackupPreset() {
  for(uint32_t i=0; i<noBanks; i++) {
    for(uint32_t j=0; j<noPresets; j++) {
      preset_t* preset = new preset_t;
      readPresetFncBankNPreset(preset, i+1, j+1);
      if(preset->stompMode == offStomp) {
        char printStr[50];
        sprintf(printStr, "Backup Bank %d Preset %d\n", i+1, j+1);
        SerialMuted(printStr);
        activatePreset(i+1, j+1);
        return;
      }
    }
  }
}

void readActivePresets() {
  uint32_t noPresetsAct;
  fram.read(noActivatedPresetAddr, (uint8_t*)&noPresetsAct, sizeof(uint32_t));
  if(noPresetsAct >= maxNoPresets || noPresetsAct < 1) {
    noPresetsAct = 0;
    clearList(presetList);
    findBackupPreset();
  }
  for(int i=0; i<noPresetsAct; i++) {
    preset_t* curPreset = new preset_t;
    uint32_t addr = activatedPresetAddr + i * sizeof(preset_t);
    readPresetFnc(curPreset, addr);
    listAppend(presetList, curPreset);
  }
}

preset_t* createDefaultPreset() {
  preset_t* defaultPreset = new preset_t;
  defaultPreset->tunerOn = false;
  for(int i = 0; i < noOuts; i++) {
    if(i == 0) {
      defaultPreset->outsOn[i] = true;
    } else {
      defaultPreset->outsOn[i] = false;
    }
    if(i < noOuts-1) {
      defaultPreset->outPhaseReverse[i] = 0;
    }
  }
  for(uint8_t i = 0; i<noLoops; i++) {
    defaultPreset->loopsOn[i] = false;
    defaultPreset->loopOrder[i][0] = i+1;
    for(uint8_t j = 1; j < noOuts; j++) {
      defaultPreset->loopOrder[i][j] = 0;
    }
  }
  for(uint8_t j = 0; j < noMixers; j++) {
    defaultPreset->loopOrder[noLoops+j][0] = mixerIds[j];
    defaultPreset->loopOrder[noLoops+j][1] = mixerIds[j];
  }
  for(uint8_t i = 0; i < noCtrl; i++) {
    defaultPreset->ctrlOn[i] = false;
  }
  for(int i=0; i<noMidiMsg; i++) {
    defaultPreset->midiOn[i] = false;
    defaultPreset->midiType[i] = midiPC;
    defaultPreset->midiChannel[i] = 1;
    defaultPreset->midiPC[i] = 0;
    defaultPreset->midiCC[i] = 1;
    defaultPreset->midiCCValue[i][0] = 0;
    defaultPreset->midiCCValue[i][1] = 127;
  }
  for(int i=0; i<noTapTempo; i++) {
    defaultPreset->tapOn[i] = false;
    defaultPreset->tapType[i] = tapCC;
    defaultPreset->tapChannel[i] = 1;
    defaultPreset->tapCC[i] = 1;
    defaultPreset->tapCCOn[i] = 127;
    defaultPreset->tapCCOff[i] = 0;
  }
  defaultPreset->stompMode = offStomp;
  defaultPreset->mixerUsed = 0;
  strcpy(defaultPreset->presetName, "");
  return defaultPreset;
}

void resetPreset(uint8_t bank, uint8_t preset, preset_t* templ=NULL) {
  bool deletePreset = false;
  if(!templ) {
    templ = createDefaultPreset();
    deletePreset = true;
  }
  for(int stereoNo=0; stereoNo<noLoops/2; stereoNo++) {
    if(stereoLoops[stereoNo]) {
      int id = stereoNo * 2 + 1;
      int readOffset = 0;
      for(int slotNo=0; slotNo<noLoops + noMixers; slotNo++) {
        if(slotNo + readOffset > noLoops + noMixers - 1) {
          templ->loopOrder[noLoops + noMixers -1][0] = 0;
          templ->loopOrder[noLoops + noMixers -1][1] = 0;
          break;
        }
        templ->loopOrder[slotNo][0] = templ->loopOrder[slotNo+readOffset][0];
        templ->loopOrder[slotNo][1] = templ->loopOrder[slotNo+readOffset][1];
        if(templ->loopOrder[slotNo][0] == id) {
          templ->loopOrder[slotNo][1] = id + 1;
          readOffset++;
        }
      }
    }
  }
  templ->bankNo = bank;
  templ->presetNo = preset;
  uint32_t presetAddr = presetStartAddr + ((bank - 1) * noPresets + (preset-1)) * sizeof(preset_t);
  savePresetFnc(templ, presetAddr);
  if(deletePreset) {
    delete templ;
  }
}

bool tapCheckOn = false;
bool tapCheckFromPreset = false;
int tapCheckCount = 0;
linkedList tapPresets;

void sendTapTempo(bool on) {
  listItem* iter = tapPresets.first;
  while(iter) {
    preset_t* tapPreset = (preset_t*) iter->item;
    for(int i=0; i<noTapTempo; i++) {
      if(tapPreset->tapOn[i]) {
        if(tapPreset->tapType[i] == tapCC) {
          uint8_t value;
          if(on) {
            value = tapPreset->tapCCOn[i];
          } else {
            value = tapPreset->tapCCOff[i];
          }
          midiInst.sendControlChange((byte) tapPreset->tapCC[i], (byte) value, (byte) tapPreset->tapChannel[i]);
        }
      }
    }
    iter = (listItem*) iter->next;
  }
}

void cancelTapTempo() {
  listItem* iter = tapPresets.first;
  for(int i=0; i<listLength(&tapPresets); i++) {
    preset_t* deletePreset = (preset_t*) deleteIdx(&tapPresets, i);
    delete deletePreset;
  }
  tapCheckOn = false;
  tapCheckCount = 0;
  tapCheckFromPreset = false;
}

void checkTapTempo(bool fromPreset=false) {
  if(tapCheckOn) {
    tapCheckCount++;
    if(tapCheckCount == tapTempoDelay) {
      sendTapTempo(false);
      cancelTapTempo();
    }
  } else {
    tapCheckOn = true;
    listItem * iter = presetList->first;
    while(iter) {
      preset_t * tapPreset = (preset_t*) iter->item;
      bool hasTapTempo = false;
      for(int i=0; i<noTapTempo; i++) {
        if(tapPreset->tapOn[i]) {
          hasTapTempo = true;
          break;
        }
      }
      if(fromPreset && tapPreset->stompMode == offStomp && hasTapTempo) {
        preset_t * cpyPreset = new preset_t;
        for(int i=0; i<sizeof(preset_t); i++) {
          *(((byte*)cpyPreset)+i) = *(((byte*)tapPreset)+i);
        }
        listAppend(&tapPresets, cpyPreset);
      }
      iter = (listItem*) iter->next;
    }
    if(listLength(&tapPresets)) {
      sendTapTempo(true);
    }
  }
}

void factoryReset() {
  clearList(presetList);
  
  brightness = 50;
  saveBrightness();
  brightnessStomp = 50;
  saveBrightnessStomp();
  brightnessStatus = 50;
  saveBrightnessStatus();
  
  bank = 1;
  saveBank();
  midiInChannel = 1;
  saveMidiInChannel();
  midiBankCtrl = 1;
  saveMidiBankCtrl();
  midiInOn = true;
  saveMidiInOn();
  midiOutOn = true;
  saveMidiOutOn();
  midiThroughOn = true;
  saveMidiThroughOn();
  midiInst.turnThruOn();
  for(int i=0; i<noLoops + noOuts - 1; i++) {
    phaseReverse[i] = false;
  }
  savePhaseReverse();
  for(int i=0; i<noLoops/2; i++)  {
    stereoLoops[i] = false;
  }
  saveStereoLoops();
  
  preset_t* defaultPreset = createDefaultPreset();;
  for(uint8_t bankNo = 0; bankNo < noBanks; bankNo++) {
    for(uint8_t presetNo=0; presetNo < noPresets; presetNo++) {
      resetPreset(bankNo+1, presetNo+1, defaultPreset);
    }
  }
  delete defaultPreset;
  activatePreset(1, 1);
}

void detectMenuEdges() {
  for(int i = 0; i < noMenuPins; i++) {
    if(menuDetect[i]) {
      if(menuMcpVals[i]) {
        menuDetect[i] = false;
        menuCount[i] = 0;
        menuLongPressDetect[i] = false;
        menuClockCount[i] = 0;
        menuClockDetect[i] = false;
        menuClock[i] = false;
        menuLongCount[i] = 0;
      } else if (menuCount[i] == debounceDelay) {
        menuEdges[i] = true;
        menuCount[i]++;
        menuLongPressDetect[i] = true;
        menuNegDetectFlag[i] = true;
      } else if(menuCount[i] < debounceDelay) {
        menuCount[i]++;
      }
    } else if(!menuMcpVals[i]) {
      menuDetect[i] = true;
    }
    if(menuLongPressDetect[i]) {
      if(menuLongCount[i] < longPressDelay) {
        menuLongCount[i]++;
      } else if(menuLongCount[i] == longPressDelay) {
        menuLongPress[i] = true;
        menuClockDetect[i] = true;
        menuNegDetectFlag[i] = false;
        menuLongCount[i]++;
      }
    }
    if(menuClockDetect[i]) {
      if(menuClockCount[i] < menuClockDelay) {
        menuClockCount[i]++;
      } else {
        menuClock[i] = true;
        menuClockCount[i] = 0;
      }
      if(menuClockFastCount[i] < menuClockDelayFast) {
        menuClockFastCount[i]++;
      } else {
        menuClockFast[i] = true;
        menuClockFastCount[i] = 0;
      }
    }
    if(menuNegDetect[i]) {
      if(!menuMcpVals[i]) {
        menuNegDetect[i] = false;
        menuNegCount[i] = 0;
      } else if (menuNegCount[i] == debounceDelay) {
        menuNegEdges[i] = true;
        menuNegCount[i]++;
      } else if(menuNegCount[i] < debounceDelay) {
        menuNegCount[i]++;
      }
    } else if(menuMcpVals[i] && menuNegDetectFlag[i]) {
      menuNegDetect[i] = true;
      menuNegDetectFlag[i] = false;
    }
  }
}

void detectPresetEdges() {
  for(int i = 0; i < noPresetPins; i++) {
    if(!digitalRead(presetPins[i]) && !presetDetect[i]) {
      presetEdges[i] = true;
      presetDetect[i] = true;
    } else if(digitalRead(presetPins[i]) && presetDetect[i]) {
      if(presetCount[i] == debounceDelay) {
        presetDetect[i] = false;
        presetCount[i] = 0;
      } else {
        presetCount[i]++;
      }
    } else if(!digitalRead(presetPins[i]) && presetDetect[i]){
      presetCount[i] = 0;
    }
  }
}

#define startup_width 119
#define startup_height 35
static const unsigned char startup_graphic[] U8X8_PROGMEM  = {
  0x00, 0x00, 0x00, 0x00, 0x00, 0x00, 0x00, 0x00, 0x00, 0x00, 0x00, 0x00, 
  0x00, 0x00, 0x00, 0x80, 0x3F, 0x80, 0x3F, 0x00, 0x00, 0x00, 0x00, 0x00, 
  0x00, 0x00, 0x00, 0x00, 0x00, 0x00, 0xE0, 0xFF, 0xE0, 0xFF, 0x00, 0x00, 
  0x00, 0x00, 0xF8, 0xFF, 0x0F, 0x00, 0x00, 0x00, 0x00, 0xF0, 0xFF, 0xF1, 
  0xFF, 0x01, 0x00, 0x00, 0x00, 0xF8, 0xFF, 0x3F, 0x00, 0x00, 0x00, 0x00, 
  0xF8, 0xFF, 0xFB, 0xFF, 0x03, 0x00, 0x00, 0x00, 0xF8, 0xFF, 0x7F, 0x00, 
  0x00, 0x00, 0x00, 0xF8, 0xFF, 0xFF, 0xFF, 0x03, 0x00, 0x00, 0x00, 0xF8, 
  0xFF, 0xFF, 0x00, 0x00, 0x00, 0x00, 0xFC, 0xFF, 0xFF, 0xFF, 0x07, 0x00, 
  0x00, 0x00, 0xF8, 0xFF, 0xFF, 0x01, 0x00, 0x00, 0x00, 0xFC, 0xFF, 0xFF, 
  0xFF, 0x07, 0x00, 0x00, 0x00, 0xF8, 0xFF, 0xFF, 0x01, 0x00, 0x00, 0x00, 
  0xFC, 0xFF, 0xFF, 0xFF, 0x07, 0x00, 0x00, 0x00, 0xF8, 0xFF, 0xFF, 0x01, 
  0x00, 0x00, 0x00, 0xFC, 0xFF, 0xFF, 0xFF, 0x07, 0x00, 0x00, 0x00, 0xF8, 
  0xFF, 0xFF, 0x03, 0x00, 0x00, 0x00, 0xFC, 0xE7, 0xFF, 0xFC, 0x07, 0x00, 
  0x00, 0x00, 0xF8, 0xFF, 0xFF, 0x03, 0x00, 0x00, 0x00, 0xFC, 0xC3, 0x7F, 
  0xF8, 0x07, 0xFE, 0xE1, 0x1F, 0xF8, 0x07, 0xFF, 0x03, 0xC0, 0x1F, 0x00, 
  0xFC, 0xC3, 0x7F, 0xF8, 0x07, 0xFE, 0xE1, 0x1F, 0xF8, 0x07, 0xFE, 0x03, 
  0xF8, 0xFF, 0x00, 0xFC, 0xC3, 0x7F, 0xF8, 0x07, 0xFE, 0xE1, 0x1F, 0xF8, 
  0x07, 0xFE, 0x01, 0xFC, 0xFF, 0x01, 0xFC, 0xC3, 0x7F, 0xF8, 0x07, 0xFE, 
  0xE1, 0x1F, 0xF8, 0x07, 0xFF, 0x01, 0xFE, 0xFF, 0x03, 0xFC, 0xC3, 0x7F, 
  0xF8, 0x07, 0xFE, 0xE1, 0x1F, 0xF8, 0xE7, 0xFF, 0x01, 0xFF, 0xFF, 0x07, 
  0xFC, 0xC3, 0x7F, 0xF8, 0x07, 0xFE, 0xE1, 0x1F, 0xF8, 0xE7, 0xFF, 0x80, 
  0xFF, 0xFF, 0x0F, 0xFC, 0xC3, 0x7F, 0xF8, 0x07, 0xFE, 0xE1, 0x1F, 0xF8, 
  0xE7, 0x7F, 0xC0, 0xFF, 0xFF, 0x1F, 0xFC, 0xC3, 0x7F, 0xF8, 0x07, 0xFE, 
  0xE1, 0x1F, 0xF8, 0xE7, 0x3F, 0xC0, 0xFF, 0xFF, 0x1F, 0xFC, 0xC3, 0x7F, 
  0xF8, 0x07, 0xFE, 0xE1, 0x1F, 0xF8, 0xE7, 0x1F, 0xE0, 0xFF, 0xFF, 0x3F, 
  0xFC, 0xC3, 0x7F, 0xF8, 0x07, 0xFE, 0xE1, 0x1F, 0xF8, 0xE7, 0x1F, 0xE0, 
  0x7F, 0xF0, 0x3F, 0xFC, 0xC3, 0x7F, 0xF8, 0x07, 0xFE, 0xE1, 0x1F, 0xF8, 
  0xE7, 0x3F, 0xE0, 0x3F, 0xE0, 0x3F, 0xFC, 0xC3, 0x7F, 0xF8, 0x07, 0xFE, 
  0xE1, 0x1F, 0xF8, 0xE7, 0x7F, 0xE0, 0x3F, 0xE0, 0x3F, 0xFC, 0xC3, 0x7F, 
  0xF8, 0x07, 0xFE, 0xE1, 0x1F, 0xF8, 0xE7, 0x7F, 0xE0, 0x3F, 0xE0, 0x3F, 
  0xFC, 0xC3, 0x7F, 0xF8, 0x07, 0xFE, 0xE1, 0x1F, 0xF8, 0xC7, 0x7F, 0xE0, 
  0x7F, 0xF0, 0x3F, 0xFC, 0xC3, 0x7F, 0xF8, 0x07, 0xFE, 0xF3, 0x1F, 0xF8, 
  0xC7, 0xFF, 0xE0, 0xFF, 0xFF, 0x3F, 0xFC, 0xC3, 0x7F, 0xF8, 0x07, 0xFE, 
  0xFF, 0x1F, 0xF8, 0x87, 0xFF, 0xC0, 0xFF, 0xFF, 0x1F, 0xFC, 0xC3, 0x7F, 
  0xF8, 0x07, 0xFE, 0xFF, 0x1F, 0xF8, 0x87, 0xFF, 0xC1, 0xFF, 0xFF, 0x1F, 
  0xFC, 0xC3, 0x7F, 0xF8, 0x07, 0xFE, 0xFF, 0x1F, 0xF8, 0x07, 0xFF, 0x81, 
  0xFF, 0xFF, 0x0F, 0xFC, 0xC3, 0x7F, 0xF8, 0x07, 0xFE, 0xFF, 0x1F, 0xF8, 
  0x07, 0xFF, 0x01, 0xFF, 0xFF, 0x07, 0xFC, 0xC3, 0x7F, 0xF8, 0x07, 0xFC, 
  0xFF, 0x0F, 0xF8, 0x07, 0xFE, 0x03, 0xFE, 0xFF, 0x03, 0xFC, 0xC3, 0x7F, 
  0xF8, 0x07, 0xFC, 0xFF, 0x0F, 0xF8, 0x07, 0xFE, 0x03, 0xFC, 0xFF, 0x01, 
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

void u8g2_prepare(void) {
  u8g2.setFont(u8g2_font_6x10_tf);
  u8g2.setFontRefHeightExtendedText();
  u8g2.setDrawColor(1);
  u8g2.setFontPosTop();
  u8g2.setFontDirection(0);
}

int startupDisplay = 0;
int mainDisplay = 1;
int presetProgDisplay = 2;
int presetSecProgDisplay = 3;
int bankSelectDisplay = 4;
int saveDisplay = 5;
int discardDisplay = 6;
int menuDisplay = 7;
int factoryResetDisplay = 8;
int startupPresetDisplay = 9;
int configDisplay = 10;
int loopOrderDisplay = 11;

int displayPage = startupDisplay;
int lastDisplayPage = -1;
bool externalDisplayRefresh = false;

int menuScrollBarWidth = 5;

void intToStr0(int value, char* str, int digits=2) {
  for(int i=0; i<digits; i++) {
    int factor = 1;
    for(int j=0; j<digits-i-1; j++) 
      factor *= 10;
    /*if(i<digits-1) {*/
    str[i] = 48 + (value % (factor*10)) / factor;
    /*} else {
      str[i] = 48 + value % 10;
    }*/
  }
  str[digits] = '\0';
}

void presetBankDraw(int xCoor, int yCoor, bool centered=false, bool last=true) {
  int curPreset = 0;
  int curBank = 0;
  
  if(last && presetList->last) {
    preset_t * preset = (preset_t*) presetList->last->item;
    curBank = preset->bankNo;
    curPreset = preset->presetNo;
  } else {
    listItem* iter = presetList->first;
    while(iter) {
      preset_t * preset = (preset_t*) iter->item;
      if(preset->stompMode == offStomp) {
        curBank = preset->bankNo;
        curPreset = preset->presetNo;
        break;
      }
      iter = (listItem*) iter->next;
    }
  }
  char presetDisp[3];
  intToStr0(curPreset, presetDisp);
  char presetBankDisp[3];
  intToStr0(curBank, presetBankDisp); 
  
  int lengthPreset = u8g2.getStrWidth("Preset ");
  int lengthPresetNo = u8g2.getStrWidth(presetDisp);
  int lengthPresetBank = u8g2.getStrWidth("Bank ");
  int lengthBankNo = u8g2.getStrWidth(presetBankDisp);
  int lengthSpace = u8g2.getStrWidth(" ");
  
  if(centered) {
    xCoor = (128 - lengthPreset - lengthPresetNo - lengthSpace - lengthPresetBank - lengthBankNo) / 2;
  }
  u8g2.drawStr(xCoor, yCoor, "Preset ");
  u8g2.drawStr(xCoor+lengthPreset, yCoor, presetDisp);
  u8g2.drawStr(xCoor+lengthPreset + lengthPresetNo, yCoor, " ");
  u8g2.drawStr(xCoor + lengthPreset + lengthPresetNo + lengthSpace, yCoor, "Bank ");
  u8g2.drawStr(xCoor+lengthPreset + lengthPresetNo + lengthSpace + lengthPresetBank, yCoor, presetBankDisp);
}

struct state {
  char * name;
  void (*activate) ();
  void (*deactivate) ();
  char * (*transitions) ();
  bool isMenu;
  char ** menuItems;
  void (*menuDisp) (int, char*);
  int menuDispHeight;
  char * currentItem;
  char * menuHeader;
  int noItems;
  int menuStart;
  bool isConfig;
  int noConfig;
  char ** configTitles;
  char ** configValues;
  int * configDigits;
  int configIdx;
};

const int noStates = 29;
state* states[noStates];
state* curState;
int menuStart = 0;

char* returnState = NULL;

int loopSlot = 0;
int loopCh = 0;
bool loopMove = false;
bool loopAllowed = false;
bool loopMoveFlag = true;

void loopOrderDisplayFnc(int offset, bool fromRun=false) {
  u8g2.setFont(u8g2_font_6x10_tf);

  if(!loopAllowed && !fromRun) {
    int width = u8g2.getStrWidth("Not Allowed in");
    int pos = (128-width)/2;
    offset += 12;
    u8g2.drawStr(pos, offset, "Not Allowed in");
    width = u8g2.getStrWidth("Stomp Box mode");
    pos = (128-width)/2;
    offset += 12;
    u8g2.drawStr(pos, offset, "Stomp Box mode");
  } else {
    preset_t* curPreset = NULL;
    if(fromRun) {
      listItem* iter = presetList->first;
      while(iter) {
        preset_t* preset = (preset_t*) iter->item;
        if(preset->stompMode == offStomp) {
          curPreset = preset;
          break;
        }
        iter = (listItem*) iter->next;
      }
    } else {
      curPreset = (preset_t*) presetList->last->item;
    }

    int frameLeft = 1;
    int frameRight = 1;
    int delta = 1;
    int totalWidth = 0;
    int loopCount = 0;
    for(int i=0; i<noLoops + noMixers; i++) { 
      int maxWidth = 0;
      int maxChars = 1;
      for(int j=0; j<noOuts; j++) {
        uint8_t id = curPreset->loopOrder[i][j];
        int width = 0;
        if(id <= noLoops && id > 0) {
          char disp[3];
          sprintf(disp, "%d", id);
          width = u8g2.getStrWidth(disp);
          loopCount++;
          if(id >= 10) {
            maxChars = 2;
          }
        } else if(id > 0) {
          char disp[2];
          sprintf(disp, "%c", 'M');
          width = u8g2.getStrWidth(disp);
          if(j==0)
            loopCount++;
        }
        maxWidth = width > maxWidth ? width : maxWidth;
      }
      totalWidth += maxWidth + frameLeft + frameRight + delta;
      if(loopCount == noLoops + noMixers)
        break;
    }
    char disp2[2];
    sprintf(disp2, "%c", 'A');
    totalWidth += u8g2.getStrWidth(disp2) + frameRight + frameLeft + delta;
    
    int loopOnHeight = 11;
    int rowPos = 127 - ((128 - totalWidth)/2);
    int row = 1;
    int totalHeight = noOuts * (loopOnHeight+1 + delta);
    int yStart = 63 - (64 - offset - totalHeight)/2;
  
    bool allLoops = false;
    bool parallel = false;
    loopCount = 0;
    bool selected = false;
    uint8_t mixerUsed = 0;
    for(int i=0; i<noLoops + noMixers; i++) { 
      //SerialMuted(i);
      //SerialMuted("\n");
      int maxWidth = 0;
      int maxChars = 1;
      for(int j=0; j<noOuts; j++) {
        uint8_t id = curPreset->loopOrder[i][j];
        int width = 0;
        if(id <= noLoops && id > 0) {
          char disp[3];
          sprintf(disp, "%d", id);
          width = u8g2.getStrWidth(disp);
          if(id >= 10) {
            maxChars = 2;
          }
          if(j != 0) {
            parallel = true;
          }
        } else if(id > 0) {
          char disp[2];
          sprintf(disp, "%c", 'M');
          width = u8g2.getStrWidth(disp);
          parallel = false;
        }
        maxWidth = width > maxWidth ? width : maxWidth;
      }
  
      bool increment = false;
      bool stereo = false;
      for(int j=0; j<noOuts; j++) {
        uint8_t id = curPreset->loopOrder[i][j];
        if(id <= noLoops) {
          //SerialMuted("Print Loop\n");
          char disp[3];
          bool draw = false;
          if(id != 0) {
            sprintf(disp, "%d", id);
            draw = true;
          } else if (parallel) {
            if(maxChars == 2) {
              sprintf(disp, "%s", "--");
            } else {
              sprintf(disp, "%c", '-');
            }
            draw = true;
          }
          if(draw) {
            if(id != 0) {
              if((j == 0 && !stereoLoops[(id-1)/2]) || j != 0 && !stereo) {   
                if(j == loopCh && i == loopSlot && loopMoveFlag && !fromRun) {
                  u8g2.setDrawColor(1);
                  u8g2.drawBox(rowPos - (maxWidth + frameLeft + frameRight), yStart - (j + 1) * (loopOnHeight+1) - delta, maxWidth + frameLeft + frameRight, loopOnHeight);
                  u8g2.setDrawColor(2);
                  u8g2.setFontMode(1);
                  selected = true;
                } else {
                  u8g2.drawFrame(rowPos - (maxWidth + frameLeft + frameRight), yStart - (j + 1) * (loopOnHeight+1) - delta, maxWidth + frameLeft + frameRight, loopOnHeight);  
                }
              } else if (j == 0) {
                stereo = true;
                if(j == loopCh && i == loopSlot)
                  selected = true;
                else if(j==0 && j+1 == loopCh && i == loopSlot)
                  selected = true;
                if(selected && loopMoveFlag && !fromRun) {
                  u8g2.setDrawColor(1);
                  u8g2.drawBox(rowPos - (maxWidth + frameLeft + frameRight), yStart - noOuts * (loopOnHeight+1) - delta, maxWidth + frameLeft + frameRight, noOuts * loopOnHeight + (noOuts - 1) * delta);
                  u8g2.setDrawColor(2);
                  u8g2.setFontMode(1);
                } else
                  u8g2.drawFrame(rowPos - (maxWidth + frameLeft + frameRight), yStart - noOuts * (loopOnHeight+1) - delta, maxWidth + frameLeft + frameRight, noOuts * loopOnHeight + (noOuts - 1) * delta);
              }
              loopCount += 1;
            }
            u8g2.drawStr(rowPos + frameLeft - (maxWidth + frameLeft + frameRight), yStart - (j + 1) * (loopOnHeight+1) - delta + 1, disp);
            increment = true;
            if(!stereo && selected)
              selected = false;
            if(!selected && loopMoveFlag) {
              u8g2.setDrawColor(1);
              u8g2.setFontMode(0);
            }
          }
        } else if(j == noOuts-1 && id > 0) {
          //SerialMuted("Print Mixer\n");
          char disp[2];
          sprintf(disp, "%c", 'M');
          if(i == loopSlot && loopMoveFlag && !fromRun) {
            u8g2.setDrawColor(1);
            u8g2.drawBox(rowPos - (maxWidth + frameLeft + frameRight), yStart - (j + 1) * (loopOnHeight+1) - delta, maxWidth + frameLeft + frameRight, noOuts * loopOnHeight + (noOuts - 1) * delta);
            u8g2.setDrawColor(2);
            u8g2.setFontMode(1);
            u8g2.drawStr(rowPos + frameLeft - (maxWidth + frameLeft + frameRight), yStart - (j + 1) * (loopOnHeight+1) - delta + 1, disp);
            u8g2.setDrawColor(1);
            u8g2.setFontMode(0);
          } else {
            u8g2.drawStr(rowPos + frameLeft - (maxWidth + frameLeft + frameRight), yStart - (j + 1) * (loopOnHeight+1) - delta + 1, disp);
            u8g2.drawFrame(rowPos - (maxWidth + frameLeft + frameRight), yStart - (j + 1) * (loopOnHeight+1) - delta, maxWidth + frameLeft + frameRight, noOuts * loopOnHeight + (noOuts - 1) * delta);
          }
          increment = true;
          mixerUsed++;
        }
      }
      if(loopCount == noLoops && mixerUsed == curPreset->mixerUsed)
        allLoops = true;
      
      if(increment)
        rowPos -= delta + maxWidth + frameLeft + frameRight;
  
      int width = 0;
      if(allLoops) {
        allLoops = false;
        loopCount = 0;
        for(int j=0; j<noOuts; j++) {
          char disp[2];
          sprintf(disp, "%c", 'A' + j);
          width = u8g2.getStrWidth(disp);
          u8g2.drawStr(rowPos + frameLeft - (width + frameLeft + frameRight), yStart - (j + 1) * (loopOnHeight+1) - delta + 1, disp);
          u8g2.drawFrame(rowPos - (width + frameLeft + frameRight), yStart - (j + 1) * (loopOnHeight+1) - delta, width + frameLeft + frameRight, loopOnHeight);
        }
        rowPos -= delta + width + frameLeft + frameRight;
      }
    }
  }
}

void display() {
  
  if (lastDisplayPage != displayPage || externalDisplayRefresh) {
    externalDisplayRefresh = false;
    u8g2_prepare();
    u8g2.clearBuffer();
    u8g2.setDrawColor(1);
    if (displayPage == startupDisplay) {
      u8g2.drawFrame(48, 46, 69, 11);
      u8g2.setFont(u8g2_font_6x10_tf);
      u8g2.drawStr(50, 47, "Engineering");
      u8g2.drawXBMP(4, 6, startup_width, startup_height, startup_graphic);
    } else if (displayPage == mainDisplay) {
      u8g2.setFont(u8g2_font_courB24_tf);
      //u8g2.setFont(u8g2_font_fub20_tf);
      int bankLength = u8g2.drawStr(0, 0, "Bank");
      char bankDisp[3];
      intToStr0(bank, bankDisp);
      u8g2.drawStr(bankLength + 9, 0, bankDisp);
      u8g2.setFont(u8g2_font_6x10_tf);
      presetBankDraw(0, 24, true, false);
      loopOrderDisplayFnc(32, true);
    } else if (displayPage == presetProgDisplay || displayPage == presetSecProgDisplay) {
      u8g2.setFont(u8g2_font_6x10_tf);
      presetBankDraw(0, 1, true);
      char * header;
      if(displayPage == presetProgDisplay) {
        header = "Primary Func.";
      } else {
        header = "Secondary Func.";
      }
      int loopsWidth = u8g2.getStrWidth(header);
      u8g2.drawStr((128 - loopsWidth)/2, 11, header);

      preset_t* curPreset = (preset_t*) presetList->last->item;
      
      int loopOnHeight = 11;
      int frameLeft = 2;
      int frameRight = 2;
      int delta = 1;
      int rowPos = delta;
      int row = 1;
      for(int i=0; i<noLoops; i++) {
        char disp[3];
        intToStr0(i+1, disp);
        int dispWidth = u8g2.getStrWidth(disp);
        if(rowPos + dispWidth + frameRight + delta > 127) {
          rowPos = delta;
          row++;
        }
        if(curPreset->loopsOn[i]) {
          u8g2.setDrawColor(1);
          u8g2.drawBox(rowPos, 63 - row * (loopOnHeight+1) - delta, dispWidth + frameLeft + frameRight, loopOnHeight);
          u8g2.setDrawColor(2);
          u8g2.setFontMode(1);
          u8g2.drawStr(rowPos + frameLeft,63 - row * (loopOnHeight+1) - delta + 1, disp);
          u8g2.setDrawColor(1);
          u8g2.setFontMode(0);
        } else {
          u8g2.drawStr(rowPos + frameLeft,63 - row * (loopOnHeight+1) - delta + 1, disp);
          u8g2.drawFrame(rowPos, 63 - row * (loopOnHeight+1) - delta, dispWidth + frameLeft + frameRight, loopOnHeight); 
        }
        rowPos += delta + dispWidth + frameLeft + frameRight;
      }
      for(int i=0; i<noCtrl; i++) {
        char disp[5];
        sprintf(disp, "Ctl%c", '1' + i);
        int dispWidth = u8g2.getStrWidth(disp);
        if(rowPos + dispWidth + frameRight + delta > 127) {
          rowPos = delta;
          row++;
        }
        if(curPreset->ctrlOn[i]) {
          u8g2.setDrawColor(1);
          u8g2.drawBox(rowPos, 63 - row * (loopOnHeight+1) - delta, dispWidth + frameLeft + frameRight, loopOnHeight);
          u8g2.setDrawColor(2);
          u8g2.setFontMode(1);
          u8g2.drawStr(rowPos + frameLeft,63 - row * (loopOnHeight+1) - delta + 1, disp);
          u8g2.setDrawColor(1);
          u8g2.setFontMode(0);
        } else {
          u8g2.drawStr(rowPos + frameLeft,63 - row * (loopOnHeight+1) - delta + 1, disp);
          u8g2.drawFrame(rowPos, 63 - row * (loopOnHeight+1) - delta, dispWidth + frameLeft + frameRight, loopOnHeight); 
        }
        rowPos += delta + dispWidth + frameLeft + frameRight;
      }
      for(int i=0; i<noOuts; i++) {
        char disp[5];
        sprintf(disp, "Out%c", 'A' + i);
        int dispWidth = u8g2.getStrWidth(disp);
        if(rowPos + dispWidth + frameRight + delta > 127) {
          rowPos = delta;
          row++;
        }
        if(curPreset->outsOn[i]) {
          u8g2.setDrawColor(1);
          u8g2.drawBox(rowPos, 63 - row * (loopOnHeight+1) - delta, dispWidth + frameLeft + frameRight, loopOnHeight);
          u8g2.setDrawColor(2);
          u8g2.setFontMode(1);
          u8g2.drawStr(rowPos + frameLeft,63 - row * (loopOnHeight+1) - delta + 1, disp);
          u8g2.setDrawColor(1);
          u8g2.setFontMode(0);
        } else {
          u8g2.drawStr(rowPos + frameLeft,63 - row * (loopOnHeight+1) - delta + 1, disp);
          u8g2.drawFrame(rowPos, 63 - row * (loopOnHeight+1) - delta, dispWidth + frameLeft + frameRight, loopOnHeight); 
        }
        rowPos += delta + dispWidth + frameLeft + frameRight;
      }
      for(int i=1; i<noOuts; i++) {
        char disp[5];
        sprintf(disp, "Ph.%c", 'A' + i);
        int dispWidth = u8g2.getStrWidth(disp);
        if(rowPos + dispWidth + frameRight + delta > 127) {
          rowPos = delta;
          row++;
        }
        if(curPreset->outPhaseReverse[i-1]) {
          u8g2.setDrawColor(1);
          u8g2.drawBox(rowPos, 63 - row * (loopOnHeight+1) - delta, dispWidth + frameLeft + frameRight, loopOnHeight);
          u8g2.setDrawColor(2);
          u8g2.setFontMode(1);
          u8g2.drawStr(rowPos + frameLeft,63 - row * (loopOnHeight+1) - delta + 1, disp);
          u8g2.setDrawColor(1);
          u8g2.setFontMode(0);
        } else {
          u8g2.drawStr(rowPos + frameLeft,63 - row * (loopOnHeight+1) - delta + 1, disp);
          u8g2.drawFrame(rowPos, 63 - row * (loopOnHeight+1) - delta, dispWidth + frameLeft + frameRight, loopOnHeight); 
        }
        rowPos += delta + dispWidth + frameLeft + frameRight;
      }
      char disp[3];
      sprintf(disp, "Tu");
      int dispWidth = u8g2.getStrWidth(disp);
      if(rowPos + dispWidth + frameRight + delta > 127) {
        rowPos = delta;
        row++;
      }
      if(curPreset->tunerOn) {
        u8g2.setDrawColor(1);
        u8g2.drawBox(rowPos, 63 - row * (loopOnHeight+1) - delta, dispWidth + frameLeft + frameRight, loopOnHeight);
        u8g2.setDrawColor(2);
        u8g2.setFontMode(1);
        u8g2.drawStr(rowPos + frameLeft,63 - row * (loopOnHeight+1) - delta + 1, disp);
        u8g2.setDrawColor(1);
        u8g2.setFontMode(0);
      } else {
        u8g2.drawStr(rowPos + frameLeft,63 - row * (loopOnHeight+1) - delta + 1, disp);
        u8g2.drawFrame(rowPos, 63 - row * (loopOnHeight+1) - delta, dispWidth + frameLeft + frameRight, loopOnHeight); 
      }
    } else if (displayPage == bankSelectDisplay) {
      u8g2.setFont(u8g2_font_courB24_tf);
      int bankWidth = u8g2.getStrWidth("Bank");
      u8g2.drawStr((128 - bankWidth)/2 , 6, "Bank");
      int selectWidth = u8g2.getStrWidth("Select");
      u8g2.drawStr((128 - selectWidth)/2, 32, "Select");
    } else if (displayPage == saveDisplay) {
      u8g2.setFont(u8g2_font_courB24_tf);
      int saveWidth = u8g2.getStrWidth("Save");
      u8g2.drawStr((128 - saveWidth)/2, 19, "Save");
    } else if (displayPage == discardDisplay) {
      u8g2.setFont(u8g2_font_courB24_tf);
      int discardWidth = u8g2.getStrWidth("Reject");
      u8g2.drawStr((128 - discardWidth)/2, 19, "Reject");
    } else if (displayPage == menuDisplay) {
      int offset = 0;
      u8g2.setFont(u8g2_font_6x10_tf);
      if (curState->menuHeader) {
        offset = 10;
        if (strcmp(curState->menuHeader, "banknpreset") == 0) {
          presetBankDraw(0, 0, true);
        } else {
          int headerWidth = u8g2.getStrWidth(curState->menuHeader);
          u8g2.drawStr((128 - headerWidth)/2, 0, curState->menuHeader);
        }
        u8g2.drawLine(0, offset+1, 127, offset+1);
        offset += 3;
      }

      int itemHeight;
      if(curState->menuDisp) {
        itemHeight = curState->menuDispHeight;
      } else {
        itemHeight = 10;
      }
      int noItems = (64 - offset)/itemHeight;
      int curSelect;
      for(curSelect = 0; curSelect < curState->noItems; curSelect++) {
        if(strcmp(curState->menuItems[curSelect], curState->currentItem) == 0)
          break;
      }
      menuStart = curState->menuStart;
      if(curSelect >= menuStart + noItems)
        menuStart = curSelect - noItems + 1;
      else if(curSelect < menuStart)
        menuStart = curSelect;
      curState->menuStart = menuStart;
      u8g2.setDrawColor(1);
      u8g2.drawBox(0, offset+(curSelect-menuStart)*itemHeight, 127-menuScrollBarWidth - 1, itemHeight);
      u8g2.setDrawColor(2);
      u8g2.setFontMode(1);
      int i;
      for(i=0; i<noItems && i+menuStart < curState->noItems; i++) {
        if(curState->menuDisp) {
          curState->menuDisp(offset+i*itemHeight, curState->menuItems[menuStart+i]);
        } else {
          int textWidth = u8g2.getStrWidth(curState->menuItems[menuStart+i]);
          u8g2.drawStr((128-textWidth)/2, offset+i*itemHeight, curState->menuItems[menuStart+i]);
        }
      }
      u8g2.setDrawColor(1);
      u8g2.setFontMode(0);
      int scrollHeight = 64-offset;
      int scrollBarHeight = (int) scrollHeight * ((float) i)/(curState->noItems);
      int scrollBarStart = menuStart * scrollBarHeight/i;
      u8g2.drawBox(127 - menuScrollBarWidth, offset + scrollBarStart, menuScrollBarWidth, scrollBarHeight);
    } else if(displayPage == factoryResetDisplay) {
      u8g2.setFont(u8g2_font_inr16_mf);
      int factoryLength = u8g2.getStrWidth("Factory");
      u8g2.drawStr((128-factoryLength)/2, 10, "Factory");
      int resetLength = u8g2.getStrWidth("Reset");
      u8g2.drawStr((128-resetLength)/2 , 36, "Reset");
      u8g2.setFont(u8g2_font_6x10_tf);
    } else if(displayPage == configDisplay) {
      u8g2.setFont(u8g2_font_6x10_tf);
      int offset = 0;
      if (curState->menuHeader) {
        offset = 10;
        if (strcmp(curState->menuHeader, "banknpreset") == 0) {
          presetBankDraw(0, 0, true);
        } else {
          int headerWidth = u8g2.getStrWidth(curState->menuHeader);
          u8g2.drawStr((128 - headerWidth)/2, 0, curState->menuHeader);
        }
        u8g2.drawLine(0, offset+1, 127, offset+1);
        offset += 3;
      }
      int widths[curState->noConfig];
      for(int i=0; i<curState->noConfig; i++) {
        int titleWidth = u8g2.getStrWidth(curState->configTitles[i]);
        int valueWidth = u8g2.getStrWidth(curState->configValues[i]);
        widths[i] = titleWidth > valueWidth ? titleWidth : valueWidth;
      }
      int delta = 6;
      int triangleSpace = 7;
      int pos = triangleSpace + delta/2;
      int drawStart = 0;
      for(int i=0; i<curState->configIdx+1; i++) {
        pos += widths[i] + delta;
        if(pos + delta/2 > 127-triangleSpace) {
          drawStart = i;
          pos = delta/2;
        }
      }
      int totalWidth = delta/2;
      for(int i=drawStart; i<curState->noConfig; i++) {
        int width = widths[i];
        if(totalWidth + width + delta/2 > 127-2*triangleSpace)
          break;
        totalWidth += width + delta;
      }
      totalWidth += delta/2;
      pos = triangleSpace + (127 - totalWidth)/2;
      int titleY = offset + 5;
      int valueY = offset + 25;
      if(drawStart > 0) {
        u8g2.drawTriangle(1, valueY + 5, 6, valueY, 6, valueY + 10);
      }
      bool drawTriangleRight;
      for(int i=drawStart; i<curState->noConfig; i++) {
        int width = widths[i];
        if(pos + width + delta/2 > 127-triangleSpace)
          break;
        int valueWidth = u8g2.getStrWidth(curState->configValues[i]);
        int valueOffset = 0;
        if(valueWidth < width)
          valueOffset = (width - valueWidth) / 2;
        int headerWidth = u8g2.getStrWidth(curState->configTitles[i]);
        int headerOffset = 0;
        if(headerWidth < width)
          headerOffset = (width - headerWidth) / 2;
        if(i==curState->configIdx) {
          u8g2.setDrawColor(1);
          u8g2.drawBox(pos - delta/2, valueY - delta/2, width + delta, 10 + delta);
          u8g2.setDrawColor(2);
          u8g2.drawFrame(pos - delta/2+1, valueY - delta/2+1, width + delta-2, 10 + delta-2);
          u8g2.setDrawColor(1);
        } else {
          u8g2.setDrawColor(1);
          u8g2.drawFrame(pos - delta/2+1, valueY - delta/2+1, width + delta-2, 10 + delta-2);
        }
        u8g2.setDrawColor(2);
        u8g2.setFontMode(1);
        u8g2.drawStr(pos + valueOffset, valueY, curState->configValues[i]);
        u8g2.setDrawColor(1);
        u8g2.setFontMode(0);
        u8g2.drawStr(pos + headerOffset, titleY, curState->configTitles[i]);
        pos += width + delta;
        drawTriangleRight = i != curState->noConfig-1;
      } 
      if(drawTriangleRight > 0) {
        u8g2.drawTriangle(127-1, valueY + 5, 127-6, valueY, 127-6, valueY + 10);
      } 
    } else if (displayPage == loopOrderDisplay) {
      u8g2.setFont(u8g2_font_6x10_tf);
      int offset = 10;
      int headerWidth = u8g2.getStrWidth("Loop Order");
      u8g2.drawStr((128 - headerWidth)/2, 0, "Loop Order");
      u8g2.drawLine(0, offset+1, 127, offset+1);
      offset += 3;
      loopOrderDisplayFnc(offset); 
    }
    
    lastDisplayPage = displayPage;
    u8g2.sendBuffer();
    printFreeMemory();
  }
}

bool externalStateChange = false;

void loadPresetActivate() {
  SerialMuted("Load Activate\n");
  if(!checkActivePresets()) {
    SerialMuted("Search for Backup Preset\n");
    findBackupPreset();
  }
  hardwareActivatePreset();
  externalStateChange = true;
}

char * loadPresetTransitions() {
  SerialMuted("Load Transistion\n");
  if(returnState) {
    char* retval = new char[30];
    strcpy(retval, returnState);
    returnState = NULL;
    externalDisplayRefresh = true;
    return retval;
  }
  return "run";
}

void loadPresetDeactivate() {
  SerialMuted("Load Deactivate\n");
  return;
}

state loadPresetState;

void runActivate() {
  SerialMuted("Run Activate\n");
  displayPage = mainDisplay;
}

char * runTransitions() {
  SerialMuted("Run Transistion\n");
  for(int i = 0; i < noMenuPins; i++) {
    if(menuEdges[i]) {
      
    }
    if(menuNegEdges[i]) {
      if(menuPins[i] == enterPin) {
        return "loopProgram";
      } else if(menuPins[i] == upPin) {
        return "bankSelect";
      }
    }
    if(menuLongPress[i]) {
      if(menuPins[i] == enterPin) {
        return "mainMenu";
      }
    }
  }
  for(int i = 0; i< noPresetPins; i++) {
    if(presetEdges[i]) {
      /*SerialMuted("Preset Edge: ");
      SerialMuted(i);
      SerialMuted("\n");*/
      bool presetWasThere = activatePreset(bank, i+1);
      if(!presetWasThere) {
        sendTapTempo(false);
        cancelTapTempo();
      }
      checkTapTempo(true);
      externalDisplayRefresh = true;
      return NULL;
    }
  }

  return NULL;
}

void runDeactivate() {
  SerialMuted("Run Deactivate\n");
  return;
}

state runState;

void loopProgramActivate() {
  SerialMuted("Loop Program Activate\n");
  displayPage = presetProgDisplay;
}

char * loopProgramTransitions() {
  SerialMuted("Loop Program Transistion\n");
  for(int i = 0; i < noMenuPins; i++) {
    if(menuEdges[i]) {
      
    }
    if(menuNegEdges[i]) {
      if(menuPins[i] == enterPin) {
        return "secondaryProgram";
      }
    }
    if(menuLongPress[i]) {
      if(menuPins[i] == enterPin) {
        return "save";
      } else if(menuPins[i] == backPin) {
        return "discard";
      }
    }
  }
  for(int i = 0; i<noPresetPins && i<noLoops; i++) {
    if(presetEdges[i]) {
      if(stereoLoops[i/2]) {
        if(i%2 == 0) {
          ((preset_t*) presetList->last->item)->loopsOn[i] ^= true;
          ((preset_t*) presetList->last->item)->loopsOn[i+1] = ((preset_t*) presetList->last->item)->loopsOn[i];
        } else {
          ((preset_t*) presetList->last->item)->loopsOn[i] ^= true;
          ((preset_t*) presetList->last->item)->loopsOn[i-1] = ((preset_t*) presetList->last->item)->loopsOn[i];
        }
        externalDisplayRefresh = true;
      } else {
        ((preset_t*) presetList->last->item)->loopsOn[i] ^= true;  
        externalDisplayRefresh = true;
      }
      hardwareActivatePreset();
    }
  }
  return NULL;
}

void loopProgramDeactivate() {
  SerialMuted("Loop Program Deactivate\n");
  return;
}

state loopProgramState;

void secondaryProgramActivate() {
  SerialMuted("Secondary Program Activate\n");
  displayPage = presetSecProgDisplay;
}

char * secondaryProgramTransitions() {
  SerialMuted("Secondary Program Transistion\n");
  for(int i = 0; i < noMenuPins; i++) {
    if(menuEdges[i]) {
      
    }
    if(menuNegEdges[i]) {
      if(menuPins[i] == enterPin) {
        return "loopProgram";
      }
    }
    if(menuLongPress[i]) {
      if(menuPins[i] == enterPin) {
        return "save";
      } else if(menuPins[i] == backPin) {
        return "discard";
      }
    }
  }
  int outOffset = noLoops - noPresetPins;
  outOffset = outOffset < 0 ? 0 : outOffset;
  for(int j = 2; j<noPresetPins; j++) {
    if(presetEdges[j]) {
      if(j < 6) {
        ((preset_t*) presetList->last->item)->ctrlOn[j-2] ^= true;
        externalDisplayRefresh = true;
      } else if(j == 6) {
        ((preset_t*) presetList->last->item)->tunerOn ^= true;
        externalDisplayRefresh = true;
      } else if(j == 7) {
        ((preset_t*) presetList->last->item)->outPhaseReverse[0] ^= true;
        externalDisplayRefresh = true;
      } else if(j < 10) {
        ((preset_t*) presetList->last->item)->outsOn[j-8] ^= true;
        externalDisplayRefresh = true;
      }
      hardwareActivatePreset();
    }
  }
  return NULL;
}

void secondaryProgramDeactivate() {
  SerialMuted("Secondary Program Deactivate\n");
  return;
}

state secondaryProgramState;

preset_t * savePreset = NULL;
bool skipSave = false;

void saveActivate() {
  SerialMuted("Save Activate\n");
  displayPage = saveDisplay;
  if(!skipSave) {
    if(savePreset) {
      savePresetFncBankNPreset(savePreset, savePreset->bankNo, savePreset->presetNo);
      readActivePresets();
      hardwareActivatePreset();
      delete savePreset;
      savePreset = NULL;
    } else {
      preset_t* preset = (preset_t*) presetList->last->item;
      preset_t* oldPreset;
      readPresetFncBankNPreset(oldPreset, preset->bankNo, preset->presetNo);
      savePresetFncBankNPreset(preset, preset->bankNo, preset->presetNo);
      if(oldPreset->stompMode != offStomp && preset->stompMode == offStomp) {
        preset_t* actPreset = (preset_t*)presetList->last->item;
        activatePreset(actPreset->bankNo, actPreset->presetNo);
      }
      saveActivePresets();
    }
  } else {
    readActivePresets();
    hardwareActivatePreset();
    saveActivePresets();
    skipSave = false;
  }
  externalDisplayRefresh = true;
  externalStateChange = true;
}

char * saveTransitions() {
  SerialMuted("Save Transistion\n");
  delay(storeDelay);
  return "loadPreset";
}

void saveDeactivate() {
  SerialMuted("Save Deactivate\n");
  return;
}


state saveState;

void discardActivate() {
  SerialMuted("Discard Activate\n");
  displayPage = discardDisplay;
  if(!skipSave) {
    if(savePreset) {
      delete savePreset;
      savePreset = NULL; 
    } else {
      preset_t* preset = (preset_t*) presetList->last->item;
      readPresetFncBankNPreset(preset, preset->bankNo, preset->presetNo);
    }
  } else {
    skipSave = false;
  }
  externalDisplayRefresh = true;
  externalStateChange = true;
}

char * discardTransitions() {
  SerialMuted("Discard Transistion\n");
  delay(storeDelay);
  return "loadPreset";
}

void discardDeactivate() {
  SerialMuted("Discard Deactivate\n");
  return;
}

state discardState;

void bankSelectActivate() {
  SerialMuted("Bank Select Activate\n");
  displayPage = bankSelectDisplay;
}

char * bankSelectTransitions() {
  for(int i = 0; i< noPresetPins; i++) {
    if(presetEdges[i]) {
      bank = i + 1;
      saveBank();
      externalDisplayRefresh = true;
      return "run";
    }
  }
  /*for(int i = 0; i < noMenuPins; i++) {
    if(menuNegEdges[i]) {
      if(menuPins[i] == backPin) {
        return "run";
      }
    }
  }*/
  return NULL;
}

void bankSelectDeactivate() {
  SerialMuted("Bank Select Deactivate\n");
}

state bankSelectState;

state mainMenuState;
char* mainMenuItems[8];

bool mainMenuClearSelect = false;

void mainMenuActivate() {
  SerialMuted("Main Menu Activate\n");
  externalDisplayRefresh = true;
}

char * mainMenuTransitions() {
  for(int i = 0; i < noMenuPins; i++) {
    if(menuNegEdges[i]) {
      if(menuPins[i] == backPin) {
        mainMenuClearSelect = true;
        return "run";
      } else if(menuPins[i] == enterPin) {
        if(strcmp(mainMenuState.currentItem, "Loop Order") == 0)
          return "loopOrder";
        else if(strcmp(mainMenuState.currentItem, "Stomp Box Mode") == 0)
          return "stompBoxMode";
        else if(strcmp(mainMenuState.currentItem, "Midi") == 0)
          return "midi";
        else if(strcmp(mainMenuState.currentItem, "Tap Tempo") == 0)
          return "tapTempo";
        else if(strcmp(mainMenuState.currentItem, "Copy") == 0)
          return "copyPreset";
        else if(strcmp(mainMenuState.currentItem, "Copy Bank") == 0)
          return "copyBank";
        else if(strcmp(mainMenuState.currentItem, "Reset") == 0)
          return "resetPreset";  
        else if(strcmp(mainMenuState.currentItem, "System Config") == 0)
          return "sysConfig";
      }
    }
  }
  return NULL;
}

state resetPresetState;
char* resetPresetItems[2];

void resetPresetActivate() {
  SerialMuted("Reset Preset Activate\n");
  externalDisplayRefresh = true;
}

void resetPresetDeactivate() {
  SerialMuted("Reset Preset Deactivate\n");
}

char * resetPresetTransitions() {
  for(int i = 0; i < noMenuPins; i++) {
    if(menuNegEdges[i]) {
      if(menuPins[i] == enterPin) {
        if(strcmp(resetPresetState.currentItem, "Ok") == 0) {
          uint8_t bankNo = ((preset_t*)presetList->last->item)->bankNo;
          uint8_t presetNo = ((preset_t*)presetList->last->item)->presetNo;
          resetPreset(bankNo, presetNo);
          deleteIdx(presetList, listLength(presetList)-1);
          activatePreset(bankNo, presetNo);
        }
        return "mainMenu";
      }
    }
  }
  return NULL;
}

void mainMenuDeactivate() {
  SerialMuted("Main Menu Deactivate\n");
  if(mainMenuClearSelect) {
    for(int i=0; i<noStates; i++) {
      if(states[i]->isMenu) {
        states[i]->currentItem = states[i]->menuItems[0];
        states[i]->menuStart = 0;
      }
    }
  }
}

state sysConfigState;
char* sysConfigItems[7];

void sysConfigActivate() {
  SerialMuted("System Config Activate\n");
  externalDisplayRefresh = true;
}

void sysConfigDeactivate() {
  SerialMuted("System Config Deactivate\n");
}

char* sysConfigTransitions() {
  for(int i = 0; i < noMenuPins; i++) {
    if(menuNegEdges[i]) {
      if(menuPins[i] == backPin) {
        return "mainMenu";
      } else if(menuPins[i] == enterPin) {
        if(strcmp(sysConfigState.currentItem, "Bank Config") == 0)
          return "bankConfig";
        else if(strcmp(sysConfigState.currentItem, "Startup Preset") == 0)
          return "startupPreset";
        else if(strcmp(sysConfigState.currentItem, "Brightness") == 0)
          return "brightness";
        else if(strcmp(sysConfigState.currentItem, "Factory Reset") == 0)
          return "factoryReset";
        else if(strcmp(sysConfigState.currentItem, "Stereo Loops") == 0)
          return "stereoLoops";
        else if(strcmp(sysConfigState.currentItem, "Phase Reverse") == 0)
          return "phaseReverse";
        else if(strcmp(sysConfigState.currentItem, "Midi Config") == 0)
          return "midiSysConfig";
      }
    }
  }
  return NULL;
}

state midiSysConfigState;
char* midiSysConfigItems[5];

void midiSysConfigActivate() {
  SerialMuted("Midi Sys Config Activate\n");
  externalDisplayRefresh = true;
}

void midiSysConfigDeactivate() {
  SerialMuted("Midi Sys Config Deactivate\n");
}

char * midiSysConfigTransitions() {
  for(int i = 0; i < noMenuPins; i++) {
    if(menuNegEdges[i]) {
      if(menuPins[i] == backPin) {
        return "sysConfig";
      } else if(menuPins[i] == enterPin) {
        if(strcmp(midiSysConfigState.currentItem, midiSysConfigItems[0]) == 0)
          return "midiSysBool";
        else if(strcmp(midiSysConfigState.currentItem, midiSysConfigItems[1]) == 0)
          return "midiSysBool";
        else if(strcmp(midiSysConfigState.currentItem, midiSysConfigItems[2]) == 0)
          return "midiSysBool";
        else if(strcmp(midiSysConfigState.currentItem, midiSysConfigItems[3]) == 0)
          return "midiSysInChannel";
        else if(strcmp(midiSysConfigState.currentItem, midiSysConfigItems[4]) == 0)
          return "midiSysBankCtrl";
      }
    }
  }
  return NULL;
}

void midiSysConfigDisplay(int y, char* item) {

  int xOffsetText = 10;
  int xOffsetStatus = 95;

  char stat[5];
  if(strcmp(item, midiSysConfigItems[3]) == 0) {
    intToStr0(midiInChannel, stat);
  } else if(strcmp(item, midiSysConfigItems[4]) == 0) {
    intToStr0(midiBankCtrl, stat, 3);
  } else {
    bool boolStat;
    if(strcmp(item, midiSysConfigItems[0]) == 0) {
      boolStat = midiInOn;
    }
    else if(strcmp(item, midiSysConfigItems[1]) == 0) {
      boolStat = midiOutOn;
    }
    else if(strcmp(item, midiSysConfigItems[2]) == 0) {
      boolStat = midiThroughOn;
    }
    if(boolStat) {
      strcpy(stat, "On");
    } else {
      strcpy(stat, "Off");
    }
  }
  u8g2.drawStr(xOffsetText, y + 2, item);
  int statWidth = u8g2.drawStr(xOffsetStatus, y + 2, stat);
  u8g2.drawFrame(xOffsetStatus - 2, y+1, statWidth+4, 11);
}

state midiConfigBoolState;
char * midiConfigBoolItems[2];

void midiConfigBoolActivate() {
  midiConfigBoolState.menuHeader = midiSysConfigState.currentItem;
  bool select;
  if(strcmp(midiSysConfigState.currentItem, midiSysConfigItems[0]) == 0) {
    select = midiInOn;
  } else if(strcmp(midiSysConfigState.currentItem, midiSysConfigItems[1]) == 0) {
    select = midiOutOn;
  } else if(strcmp(midiSysConfigState.currentItem, midiSysConfigItems[2]) == 0) {
    select = midiThroughOn;
  }
  midiConfigBoolState.currentItem = select ? midiConfigBoolItems[0] : midiConfigBoolItems[1];
  externalDisplayRefresh = true;
}

void midiConfigBoolDeactivate() {
  
}

char* midiConfigBoolTransitions() {
  for(int i = 0; i < noMenuPins; i++) {
    if(menuNegEdges[i]) {
      if(menuPins[i] == backPin) {
        return "midiSysConfig";
      } else if(menuPins[i] == enterPin) {
        bool select = strcmp(midiConfigBoolState.currentItem, "On") == 0;
        
        if(strcmp(midiSysConfigState.currentItem, midiSysConfigItems[0]) == 0) {
          midiInOn = select;
          saveMidiInOn();
        } else if(strcmp(midiSysConfigState.currentItem, midiSysConfigItems[1]) == 0) {
          midiOutOn = select;
          saveMidiOutOn();
        } else if(strcmp(midiSysConfigState.currentItem, midiSysConfigItems[2]) == 0) {
          midiThroughOn = select;
          saveMidiThroughOn();
          if(select) {
            midiInst.turnThruOn();
          } else {
            midiInst.turnThruOff();
          }
        }
        return "midiSysConfig";
      }
    }
  }
  return NULL; 
}

state midiInChannelState;
char * midiInChannelTitles[1];
char midiInChannelItems[1][3];
char * midiInChannelItemsState[1];

void midiInChannelActivate() {
  intToStr0(midiInChannel, midiInChannelItemsState[0]);
  externalDisplayRefresh = true;
}

void midiInChannelDeactivate() {
  
}

char * midiInChannelTransitions() {
  for(int i = 0; i < noMenuPins; i++) {
    if(menuNegEdges[i]) {
      if(menuPins[i] == backPin) {
        readMidiInChannel();
        return "midiSysConfig";
      } else if(menuPins[i] == enterPin) {
        saveMidiInChannel();
        return "midiSysConfig";
      } else if(menuPins[i] == upPin) {
        if(midiInChannel < 15) {
          midiInChannel++;
          intToStr0(midiInChannel, midiInChannelItemsState[0]);
          externalDisplayRefresh = true;
        } else {
          midiInChannel = 1;
          intToStr0(midiInChannel, midiInChannelItemsState[0]);
          externalDisplayRefresh = true;
        }
      } else if(menuPins[i] == downPin) {
        if(midiInChannel > 1) {
          midiInChannel--; 
          intToStr0(midiInChannel, midiInChannelItemsState[0]);
          externalDisplayRefresh = true;
        } else {
          midiInChannel = 15; 
          intToStr0(midiInChannel, midiInChannelItemsState[0]);
          externalDisplayRefresh = true;
        }
      }
    } else if(menuClockFast[i]) {
      if(menuPins[i] == upPin) {
        if(midiInChannel < 15) {
          midiInChannel++;
          intToStr0(midiInChannel, midiInChannelItemsState[0]);
          externalDisplayRefresh = true;
        } else {
          midiInChannel = 1;
          intToStr0(midiInChannel, midiInChannelItemsState[0]);
          externalDisplayRefresh = true;
        }
      } else if(menuPins[i] == downPin) {
        if(midiInChannel > 1) {
          midiInChannel--; 
          intToStr0(midiInChannel, midiInChannelItemsState[0]);
          externalDisplayRefresh = true;
        } else {
          midiInChannel = 15; 
          intToStr0(midiInChannel, midiInChannelItemsState[0]);
          externalDisplayRefresh = true;
        }
      }
    }
  }
  return NULL;
}

state midiBankCtrlState;
char * midiBankCtrlTitles[1];
char midiBankCtrlItems[1][3];
char * midiBankCtrlItemsState[1];

void midiBankCtrlActivate() {
  intToStr0(midiBankCtrl, midiBankCtrlItemsState[0], 3);
  externalDisplayRefresh = true;
}

void midiBankCtrlDeactivate() {
  
}

char * midiBankCtrlTransitions() {
  for(int i = 0; i < noMenuPins; i++) {
    if(menuNegEdges[i]) {
      if(menuPins[i] == backPin) {
        readMidiBankCtrl();
        return "midiSysConfig";
      } else if(menuPins[i] == enterPin) {
        saveMidiBankCtrl();
        return "midiSysConfig";
      } else if(menuPins[i] == upPin) {
        if(midiBankCtrl < 127) {
          midiBankCtrl++;
          intToStr0(midiBankCtrl, midiBankCtrlItemsState[0], 3);
          externalDisplayRefresh = true;
        } else {
          midiBankCtrl = 1; 
          intToStr0(midiBankCtrl, midiBankCtrlItemsState[0], 3);
          externalDisplayRefresh = true;
        }
      } else if(menuPins[i] == downPin) {
        if(midiBankCtrl > 1) {
          midiBankCtrl--; 
          intToStr0(midiBankCtrl, midiBankCtrlItemsState[0], 3);
          externalDisplayRefresh = true;
        } else {
          midiBankCtrl = 127; 
          intToStr0(midiBankCtrl, midiBankCtrlItemsState[0], 3);
          externalDisplayRefresh = true;
        }
      }
    } else if(menuClockFast[i]) {
      if(menuPins[i] == upPin) {
        if(midiBankCtrl < 127) {
          midiBankCtrl++;
          intToStr0(midiBankCtrl, midiBankCtrlItemsState[0], 3);
          externalDisplayRefresh = true;
        } else {
          midiBankCtrl = 1; 
          intToStr0(midiBankCtrl, midiBankCtrlItemsState[0], 3);
          externalDisplayRefresh = true;
        }
      } else if(menuPins[i] == downPin) {
        if(midiBankCtrl > 1) {
          midiBankCtrl--; 
          intToStr0(midiBankCtrl, midiBankCtrlItemsState[0], 3);
          externalDisplayRefresh = true;
        }  else {
          midiBankCtrl = 127; 
          intToStr0(midiBankCtrl, midiBankCtrlItemsState[0], 3);
          externalDisplayRefresh = true;
        }
      }
    }
  }
  return NULL;
}

state midiState;
char midiItems[noMidiMsg][10];
char* midiItemsState[noMidiMsg];

void midiActivate() {
  SerialMuted("Midi Activate\n");
  externalDisplayRefresh = true;
}

void midiDeactivate() {
  SerialMuted("Midi Deactivate\n");
}

char * midiTransitions() {
  for(int i = 0; i < noMenuPins; i++) {
    if(menuNegEdges[i]) {
      if(menuPins[i] == backPin) {
        return "mainMenu";
      } else if(menuPins[i] == enterPin) {
        return "midiConfig";
      }
    }
  }
  return NULL;
}

state midiConfigState;

void midiConfigStateChange() {
  externalDisplayRefresh = true;
  if(midiConfigState.configTitles) {
    delete midiConfigState.configTitles;
  }
  midiConfigState.configTitles = NULL;
  if(midiConfigState.configValues) {
    for(int i=0; i<sizeof(midiConfigState.configValues)/sizeof(char**); i++) {
      delete midiConfigState.configValues[i];
    }
    delete midiConfigState.configValues;
    midiConfigState.configValues = NULL;
  }
  int msgNo = 0;
  for(msgNo = 0; msgNo<noMidiMsg; msgNo++) {
    if(strcmp(midiState.currentItem, midiState.menuItems[msgNo]) == 0)
      break;
  }
  preset_t* curPreset = (preset_t*) presetList->last->item;
  if(curPreset->midiType[msgNo] == midiPC) {
    midiConfigState.noConfig = 4;
    char ** configTitles = new char*[4];
    configTitles[0] = "On/Off";
    configTitles[1] = "PC/CC";
    configTitles[2] = "Ch.";
    configTitles[3] = "No.";
    midiConfigState.configTitles = configTitles;
    char ** configValues = new char*[4];
    midiConfigState.configValues = configValues;
    for(int i = 0; i < 4; i++) {
      configValues[i] = new char[6];
    }
    if(curPreset->midiOn[msgNo]) {
      strcpy(configValues[0], "On");
    } else {
      strcpy(configValues[0], "Off");
    }
    strcpy(configValues[1], "PC");
    intToStr0(curPreset->midiChannel[msgNo], configValues[2]);
    intToStr0(curPreset->midiPC[msgNo], configValues[3], 3);
  } else if(curPreset->midiType[msgNo] == midiCC) {
    midiConfigState.noConfig = 5;
    char ** configTitles = new char*[5];
    configTitles[0] = "On/Off";
    configTitles[1] = "PC/CC";
    configTitles[2] = "Ch.";
    configTitles[3] = "Ctrl.";
    configTitles[4] = "Val.";
    midiConfigState.configTitles = configTitles;
    char ** configValues = new char*[5];
    midiConfigState.configValues = configValues;
    for(int i = 0; i < 5; i++) {
      configValues[i] = new char[6];
    }
    if(curPreset->midiOn[msgNo]) {
      strcpy(configValues[0], "On");
    } else {
      strcpy(configValues[0], "On");
    }
    strcpy(configValues[1], "CC");
    intToStr0(curPreset->midiChannel[msgNo], configValues[2]);
    intToStr0(curPreset->midiCC[msgNo], configValues[3], 3);
    intToStr0(curPreset->midiCCValue[msgNo][0], configValues[4], 3);
  } else if(curPreset->midiType[msgNo] == expr1 || curPreset->midiType[msgNo] == expr2) {
    midiConfigState.noConfig = 6;
    char ** configTitles = new char*[6];
    configTitles[0] = "On/Off";
    configTitles[1] = "PC/CC";
    configTitles[2] = "Ch.";
    configTitles[3] = "Ctrl.";
    configTitles[4] = "Hell";
    configTitles[5] = "Toe";
    midiConfigState.configTitles = configTitles;
    char ** configValues = new char*[6];
    midiConfigState.configValues = configValues;
    for(int i = 0; i < 6; i++) {
      configValues[i] = new char[6];
    }
    if(curPreset->midiOn[msgNo]) {
      strcpy(configValues[0], "On");
    } else {
      strcpy(configValues[0], "Off");
    }
    if(curPreset->midiType[msgNo] == expr1)
      strcpy(configValues[1], "Expr1");
    else
      strcpy(configValues[1], "Expr2");
    intToStr0(curPreset->midiChannel[msgNo], configValues[2]);
    intToStr0(curPreset->midiCC[msgNo], configValues[3], 3);
    intToStr0(curPreset->midiCCValue[msgNo][0], configValues[4], 3);
    intToStr0(curPreset->midiCCValue[msgNo][1], configValues[5], 3);
  }
}

void midiConfigActivate() {
  SerialMuted("Midi Config Activate\n");
  midiConfigStateChange();
  midiConfigState.menuHeader = midiState.currentItem;
  externalDisplayRefresh = true;
}

void midiConfigDeactivate() {
  SerialMuted("Midi Config Deactivate\n");
  midiConfigState.configIdx = 0;
  if(midiConfigState.configTitles) {
    delete midiConfigState.configTitles;
  }
  midiConfigState.configTitles = NULL;
  if(midiConfigState.configValues) {
    for(int i=0; i<sizeof(midiConfigState.configValues)/sizeof(char**); i++) {
      delete midiConfigState.configValues[i];
    }
    delete midiConfigState.configValues;
    midiConfigState.configValues = NULL;
  }
}

void midiConfigUpDown(bool up) {
  preset_t* curPreset = (preset_t*) presetList->last->item;
  int msgNo = 0;
  for(msgNo = 0; msgNo<noMidiMsg; msgNo++) {
    if(strcmp(midiState.currentItem, midiState.menuItems[msgNo]) == 0)
      break;
  }
  if(midiConfigState.configIdx == 0) {
    curPreset->midiOn[msgNo] ^= true;
  } else if (midiConfigState.configIdx == 1) {
    midiTypes selection[4] = {midiPC, midiCC, expr1 , expr2};
    int i;
    for(i=0; i<4; i++) {
      if(curPreset->midiType[msgNo] == selection[i])
        break;
    }
    if(up) {
      if(curPreset->midiType[msgNo] != expr2) {
        curPreset->midiType[msgNo] = selection[i+1];
      } else {
        curPreset->midiType[msgNo] = midiPC;
      }
    } else {
      if(curPreset->midiType[msgNo] != midiPC) {
        curPreset->midiType[msgNo] = selection[i-1];
      } else {
        curPreset->midiType[msgNo] = expr2;
      }
    }
  } else if (midiConfigState.configIdx == 2) {
    if(up) {
      curPreset->midiChannel[msgNo] = curPreset->midiChannel[msgNo] < 15 ? curPreset->midiChannel[msgNo] + 1 : 1;
    } else {
      curPreset->midiChannel[msgNo] = curPreset->midiChannel[msgNo] > 1 ? curPreset->midiChannel[msgNo] - 1 : 15;
    }
  } else if (midiConfigState.configIdx == 3) {
    uint8_t * data;
    if(curPreset->midiType[msgNo] == midiPC){
      data = &curPreset->midiPC[msgNo];
    } else if(curPreset->midiType[msgNo] == midiCC || curPreset->midiType[msgNo] == expr1 || curPreset->midiType[msgNo] == expr2) {
      data = &curPreset->midiCC[msgNo];
    }
    if(up) {
      *data = *data < 127 ? *data + 1 : 0;
    } else {
      *data = *data > 0 ? *data - 1 : 127;
    }
  } else {
    uint8_t * data = &curPreset->midiCCValue[msgNo][midiConfigState.configIdx - 4];
    if(up) {
      *data = *data < 127 ? *data + 1 : 0;
    } else {
      *data = *data > 0 ? *data - 1 : 127;
    }
  }
  midiConfigStateChange();
}

char* midiConfigTransitions() {
  SerialMuted("Midi Config Transitions\n");
  for(int i = 0; i < noMenuPins; i++) {
    if(menuNegEdges[i]) {
      if(menuPins[i] == backPin) {
        returnState = "midi";
        return "discard";
      } else if(menuPins[i] == enterPin) {
        returnState = "midi";
        return "save";
      } else if(menuPins[i] == leftPin) {
        midiConfigState.configIdx = midiConfigState.configIdx > 0 ? midiConfigState.configIdx - 1 : 0;
        externalDisplayRefresh = true;
      } else if(menuPins[i] == rightPin) {
        midiConfigState.configIdx = midiConfigState.configIdx < midiConfigState.noConfig - 1 ? midiConfigState.configIdx + 1 : midiConfigState.noConfig - 1;
        externalDisplayRefresh = true;
      } else if(menuPins[i] == upPin) {
        midiConfigUpDown(true);
      } else if(menuPins[i] == downPin) {
        midiConfigUpDown(false);
      }
    } else if(menuClockFast[i]) {
      if(menuPins[i] == upPin) {
        midiConfigUpDown(true);
      } else if(menuPins[i] == downPin) {
        midiConfigUpDown(false);
      }
    }
  }
  return NULL;
}

void midiDisplay(int y, char* item) {

  SerialMuted("midiDisplay\n");
  SerialMuted(item);
  SerialMuted("\n");

  int xOffsetText = 20;
  int xOffsetStatus = 90;

  preset_t* preset = (preset_t*) presetList->last->item;
  int i;
  for(i=0; i<noMidiMsg; i++) {
    if(strcmp(item, midiItems[i]) == 0)
      break;
  }
  char* stat;
  if(preset->midiOn[i]) {
    stat = "On";
  } else {
    stat = "Off";
  }
  u8g2.drawStr(xOffsetText, y + 2, item);
  int statWidth = u8g2.drawStr(xOffsetStatus, y + 2, stat);
  u8g2.drawFrame(xOffsetStatus - 2, y+1, statWidth+4, 11);
}

state tapTempoConfigState;
char * tapTempoConfigTitles[5];
state tapTempoState;
char tapTempoItems[noTapTempo][10];
char * tapTempoItemsState[noTapTempo];

void tapTempoDisplay(int y, char* item) {

  int xOffsetText = 20;
  int xOffsetStatus = 90;

  preset_t* preset = (preset_t*) presetList->last->item;
  int i;
  for(i=0; i<noTapTempo; i++) {
    if(strcmp(item, tapTempoItems[i]) == 0)
      break;
  }
  char* stat;
  if(preset->tapOn[i]) {
    stat = "On";
  } else {
    stat = "Off";
  }
  u8g2.drawStr(xOffsetText, y + 2, item);
  int statWidth = u8g2.drawStr(xOffsetStatus, y + 2, stat);
  u8g2.drawFrame(xOffsetStatus - 2, y+1, statWidth+4, 11);
}

void tapTempoActivate() {
  SerialMuted("Tap Tempo Activate\n");
  externalDisplayRefresh = true;
}

void tapTempoDeactivate() {
  SerialMuted("Tap Tempo Deactivate\n");
}

char * tapTempoTransitions() {
  SerialMuted("Tap Tempo Transitions\n");
  for(int i = 0; i < noMenuPins; i++) {
    if(menuNegEdges[i]) {
      if(menuPins[i] == backPin) {
        return "mainMenu";
      } else if(menuPins[i] == enterPin) {
        returnState = "tapTempoConfig";
        return "tapTempoConfig";
      }
    }
  }
  return NULL;
}

void tapTempoConfigStateChange() {
  externalDisplayRefresh = true;
  int msgNo = 0;
  for(msgNo = 0; msgNo<noTapTempo; msgNo++) {
    if(strcmp(tapTempoState.currentItem, tapTempoState.menuItems[msgNo]) == 0)
      break;
  }
  preset_t* curPreset = (preset_t*) presetList->last->item;
  char ** configValues = new char*[6];
  tapTempoConfigState.configValues = configValues;
  for(int i = 0; i < 6; i++) {
    configValues[i] = new char[6];
  }
  if(curPreset->tapOn[msgNo]) {
    strcpy(configValues[0], "On");
  } else {
    strcpy(configValues[0], "Off");
  }
  intToStr0(curPreset->tapChannel[msgNo], configValues[1]);
  intToStr0(curPreset->tapCC[msgNo], configValues[2], 3);
  intToStr0(curPreset->tapCCOn[msgNo], configValues[3], 3);
  intToStr0(curPreset->tapCCOff[msgNo], configValues[4], 3);
}

void tapTempoConfigActivate() {
  SerialMuted("Tap Tempo Config Activate\n");
  tapTempoConfigStateChange();
  tapTempoConfigState.menuHeader = tapTempoState.currentItem;
  externalDisplayRefresh = true;
}

void tapTempoConfigDeactivate() {
  SerialMuted("Tap Tempo Config Deactivate\n");
  tapTempoConfigState.configIdx = 0;
  for(int i = 0; i < 6; i++) {
    delete tapTempoConfigState.configValues[i];
  }
  delete tapTempoConfigState.configValues;
}

void tapTempoConfigUpDown(bool up) {
  preset_t* curPreset = (preset_t*) presetList->last->item;
  int msgNo = 0;
  for(msgNo = 0; msgNo<noTapTempo; msgNo++) {
    if(strcmp(tapTempoState.currentItem, tapTempoState.menuItems[msgNo]) == 0)
      break;
  }
  if(tapTempoConfigState.configIdx == 0) {
    curPreset->tapOn[msgNo] ^= true;
  } else if (tapTempoConfigState.configIdx == 1) {
    if(up) {
      curPreset->tapChannel[msgNo] = curPreset->tapChannel[msgNo] < 15 ? curPreset->tapChannel[msgNo] + 1 : 1;
    } else {
      curPreset->tapChannel[msgNo] = curPreset->tapChannel[msgNo] > 1 ? curPreset->tapChannel[msgNo] - 1 : 15;
    }
  } else if (tapTempoConfigState.configIdx == 2) {
    uint8_t * data;
    data = &curPreset->tapCC[msgNo];
    if(up) {
      *data = *data < 127 ? *data + 1 : 0;
    } else {
      *data = *data > 0 ? *data - 1 : 127;
    }
  } else {
    uint8_t * data;
    if(tapTempoConfigState.configIdx == 3) {
      data = &curPreset->tapCCOn[msgNo];
    } else {
      data = &curPreset->tapCCOff[msgNo];
    }
    if(up) {
      *data = *data < 127 ? *data + 1 : 0;
    } else {
      *data = *data > 0 ? *data - 1 : 127;
    }
  }
  tapTempoConfigStateChange();
}

char* tapTempoConfigTransitions() {
  SerialMuted("Tap Tempo Config Transitions\n");
  for(int i = 0; i < noMenuPins; i++) {
    if(menuNegEdges[i]) {
      if(menuPins[i] == backPin) {
        returnState = "tapTempo";
        return "discard";
      } else if(menuPins[i] == enterPin) {
        returnState = "tapTempo";
        return "save";
      } else if(menuPins[i] == leftPin) {
        tapTempoConfigState.configIdx = tapTempoConfigState.configIdx > 0 ? tapTempoConfigState.configIdx - 1 : 0;
        externalDisplayRefresh = true;
      } else if(menuPins[i] == rightPin) {
        tapTempoConfigState.configIdx = tapTempoConfigState.configIdx < tapTempoConfigState.noConfig - 1 ? tapTempoConfigState.configIdx + 1 : tapTempoConfigState.noConfig - 1;
        externalDisplayRefresh = true;
      } else if(menuPins[i] == upPin) {
        tapTempoConfigUpDown(true);
      } else if(menuPins[i] == downPin) {
        tapTempoConfigUpDown(false);
      }
    } else if(menuClockFast[i]) {
      if(menuPins[i] == upPin) {
        tapTempoConfigUpDown(true);
      } else if(menuPins[i] == downPin) {
        tapTempoConfigUpDown(false);
      }
    }
  }
  return NULL;
}

state phaseReverseState;
char phaseReverseItems[noLoops + noOuts - 1][15];
char* phaseReverseItemsState[noLoops + noOuts - 1];

state phaseReverseOnOffState;
char * phaseReverseOnOffItems[2];

void phaseReverseActivate() {
  SerialMuted("Phase Reverse Activate\n");
  externalDisplayRefresh = true;
}

void phaseReverseDeactivate() {
  SerialMuted("Phase Reverse Deactivate\n");
}

char * phaseReverseTransitions() {
  for(int i = 0; i < noMenuPins; i++) {
    if(menuNegEdges[i]) {
      if(menuPins[i] == enterPin) {
        for(int i=0; i<noLoops + noOuts - 1; i++) {
          if(strcmp(phaseReverseState.currentItem, phaseReverseItemsState[i]) == 0) {
            strcpy(header, "Phase - ");
            phaseReverseOnOffState.menuHeader = strcat(header, phaseReverseState.currentItem);
            if(phaseReverse[i]) {
              phaseReverseOnOffState.currentItem = phaseReverseOnOffItems[1];
            } else {
              phaseReverseOnOffState.currentItem = phaseReverseOnOffItems[0];
            }
            break;
          }
        }
        return "phaseReverseOnOff";
      } else if(menuPins[i] == backPin) {
        return "sysConfig";
      }
    }
  }
  return NULL;
}

void phaseReverseDisplay(int y, char* item) {

  SerialMuted("phaseReverseDisplay\n");
  SerialMuted(item);
  SerialMuted("\n");

  int xOffsetText = 10;
  int xOffsetStatus = 100;
  
  char* stat;
  for(int i=0; i<noLoops + noOuts - 1; i++) {
    if(strcmp(item, phaseReverseItemsState[i]) == 0) {
      if(phaseReverse[i]) {
        stat = "On";
      } else {
        stat = "Off";
      }
      break;
    }
  }
  
  u8g2.drawStr(xOffsetText, y + 2, item);
  int statWidth = u8g2.drawStr(xOffsetStatus, y + 2, stat);
  u8g2.drawFrame(xOffsetStatus - 2, y+1, statWidth+4, 11);
}

void phaseReverseOnOffActivate() {
  SerialMuted("Phase Reverse On Off Activate\n");
  externalDisplayRefresh = true;
}

void phaseReverseOnOffDeactivate() {
  SerialMuted("Phase Reverse On Off Deactivate\n");
}

char * phaseReverseOnOffTransitions() {
  for(int i = 0; i < noMenuPins; i++) {
    if(menuNegEdges[i]) {
      if(menuPins[i] == enterPin) {
        for(int i=0; i<noLoops + noOuts - 1; i++) {
          if(strcmp(phaseReverseState.currentItem, phaseReverseItemsState[i]) == 0) {
            if(strcmp(phaseReverseOnOffState.currentItem, "On") == 0) {
              phaseReverse[i] = true;
            } else {
              phaseReverse[i] = false;
            }
            savePhaseReverse();
            break;
          }
        }
        return "phaseReverse";        
      } else if(menuPins[i] == backPin) {
        return "phaseReverse";
      }
    }
  }

  return NULL;
}

state factoryResetState;
char* factoryResetItems[2];

void factoryResetActivate() {
  SerialMuted("Factory Reset Activate\n");
  externalDisplayRefresh = true;
}

void factoryResetDeactivate() {
  SerialMuted("Factory Reset Deactivate\n");
}

char * factoryResetTransitions() {
   for(int i = 0; i < noMenuPins; i++) {
    if(menuNegEdges[i]) {
      if(menuPins[i] == enterPin) {
        if(strcmp(factoryResetState.currentItem, "Ok") == 0) {
          displayPage = factoryResetDisplay;
          display();
          factoryReset();
          delay(storeDelay);
        }
        return "sysConfig";
      } else if(menuPins[i] == backPin) {
        return "sysConfig";
      }
    } 
  }
  return NULL;
}

state stompBoxModeState;
char* stompBoxModeItems[5];

//{offStomp = 0, normalStomp = 1, permanentStomp = 2, toggleStomp = 3, permanentBankStomp = 4}
void stompBoxModeActivate() {
  SerialMuted("Stomp Box Activate\n");
  externalDisplayRefresh = true;
  switch(((preset_t*)presetList->last->item)->stompMode) {
    case offStomp: stompBoxModeState.currentItem = stompBoxModeItems[0];break;
    case normalStomp: stompBoxModeState.currentItem = stompBoxModeItems[1];break;
    case permanentStomp: stompBoxModeState.currentItem = stompBoxModeItems[2];break;
    case toggleStomp: stompBoxModeState.currentItem = stompBoxModeItems[3];break;
    case permanentBankStomp: stompBoxModeState.currentItem = stompBoxModeItems[4];break;
  }
}

void stompBoxModeDeactivate() {
  SerialMuted("Stomp Box Deactivate\n");
}

char * stompBoxModeTransitions() {
  for(int i = 0; i < noMenuPins; i++) {
    if(menuNegEdges[i]) {
      if(menuPins[i] == enterPin) {
        stompModes preMode = ((preset_t*)presetList->last->item)->stompMode;
        if(strcmp(stompBoxModeState.currentItem, stompBoxModeItems[0]) == 0) {
          ((preset_t*)presetList->last->item)->stompMode = offStomp;
        } else if(strcmp(stompBoxModeState.currentItem, stompBoxModeItems[1]) == 0) {
          ((preset_t*)presetList->last->item)->stompMode = normalStomp;
          keepLast = true;
        }
        else if(strcmp(stompBoxModeState.currentItem, stompBoxModeItems[2]) == 0) {
          ((preset_t*)presetList->last->item)->stompMode = permanentStomp;
          keepLast = true;
        } else if(strcmp(stompBoxModeState.currentItem, stompBoxModeItems[3]) == 0) {
          ((preset_t*)presetList->last->item)->stompMode = toggleStomp;
          keepLast = true;
        } else if(strcmp(stompBoxModeState.currentItem, stompBoxModeItems[4]) == 0) {
          ((preset_t*)presetList->last->item)->stompMode = permanentBankStomp;
          keepLast = true;
        }
        returnState = "mainMenu";
        return "save";
      } else if(menuPins[i] == backPin) {
        return "mainMenu";
      }
    } 
  }
  return NULL;
}

state loopOrderState;

void loopOrderActivate() {
  SerialMuted("Loop Order Activate\n");
  displayPage = loopOrderDisplay;
  preset_t* curPreset = (preset_t*) presetList->last->item;

  bool found = false;
  if(curPreset->stompMode == offStomp) {
    loopAllowed = true;
    for(int slotNo=0; slotNo < noLoops + noMixers; slotNo++) {
      for(int outNo=0; outNo < noOuts; outNo++) {
        if(curPreset->loopOrder[slotNo][outNo] > 0) {
          loopSlot = slotNo;
          loopCh = outNo;
          found = true;
          break;
        }
      }
      if(found)
        break;
    }
  }
}

void loopOrderDeactivate() {
  SerialMuted("Loop Order Deactivate\n");
  loopSlot = 0;
  loopCh = 0;
  loopMove = false;
  loopAllowed = false;
}

void printArray(uint8_t data[][2], int noX, int noY) {

  SerialMuted("Array Data\n");
  for(int i=0; i<noY; i++) {
    for(int j=0; j<noX; j++) {
      SerialMuted(data[j][i]);
      SerialMuted(", ");
    }
    SerialMuted("\n");
  }
  
}
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
void loop() {
  display();
  if(!digitalRead(INT_STATUS)) {
    SerialMuted("Interrupt\n");
    for(int i = 0; i < noMenuPins; i++) {
      menuMcpVals[i] = mcp_status3.digitalRead(menuPins[i]);
    }
  }
  if(!digitalRead(INT_MATRIX)) {
    readLoopConn();
    SerialMuted("Read Loop Conn\n");
  }

  bool pressDetect = false;
  detectMenuEdges();
  for(int i = 0; i < noMenuPins; i++) {
    if(menuEdges[i]) {
      SerialMuted("Menu Edge: ");
      SerialMuted(i);
      SerialMuted("\n");
      pressDetect = true;
    }
    if(menuNegEdges[i] || menuClock[i]) {
      SerialMuted("Menu Negative Edge: ");
      SerialMuted(i);
      SerialMuted("\n");
      if(curState->isMenu) {
        int menuMove = 0;
        if(menuPins[i] == upPin)
          menuMove = -1;
        else if(menuPins[i] == downPin)
          menuMove = 1;
        if(menuMove != 0) {
          int curSelect;  
          for(curSelect = 0; curSelect < curState->noItems; curSelect++) {
            if(strcmp(curState->currentItem, curState->menuItems[curSelect]) == 0)
              break;
          }
          curSelect += menuMove;
          if(curSelect >= 0 && curSelect < curState->noItems) {
            curState->currentItem = curState->menuItems[curSelect];
            externalDisplayRefresh = true;
          }
        }
      }
      pressDetect = true;
    }
    if(menuLongPress[i] || menuClockFast[i]) {
      SerialMuted("Menu Long Press: ");
      SerialMuted(i);
      SerialMuted("\n");
      pressDetect = true;
    }
  }
  detectPresetEdges();
  for(int i = 0; i< noPresetPins; i++) {
    if(presetEdges[i]) {
      SerialMuted("Preset Edge: ");
      SerialMuted(i);
      SerialMuted("\n");
      pressDetect = true;
    }
  }

  if(pressDetect || externalStateChange) {
    printFreeMemory();
    externalStateChange = false;
    char * nextState = curState->transitions();
    if(nextState) {
      bool foundState = false;
      for(int i = 0; i<sizeof(states)/sizeof(state*); i++) {
        state* posState = states[i];
        if(strcmp(posState->name, nextState) == 0) {
          curState->deactivate();
          curState = posState;
          curState->activate();
          if(curState->isMenu) {
            displayPage = menuDisplay;
          } else if(curState->isConfig) {
            displayPage = configDisplay;
          }
          foundState = true;
          break;
        }
      }
      if(!foundState) {
        SerialMuted("State ");
        SerialMuted(nextState);
        SerialMuted(" not found\n");
      }
    }
  }
  if(exprCount == exprDelay) {
    for(int i = 0; i < noExpr; i++) {
      uint16_t exprVal = analogRead(exprPins[i]);
      exprVal >>= 2;
      if(exprVal > exprVals[i] + exprDelta || exprVal < exprVals[i] - exprDelta) {
        exprVals[i] = exprVal;
        checkExpr(i);
        /*SerialMuted("Expr. Value: ");
        SerialMuted(exprVal);
        SerialMuted("\n");*/
      }
    }
  }

  for(int i = 0; i< noPresetPins; i++) {
    if(presetEdges[i]) {
      presetEdges[i] = false;
    }
  }
  for(int i = 0; i < noMenuPins; i++) {
    menuEdges[i] = false;
    menuNegEdges[i] = false;
    menuLongPress[i] = false;
    menuClock[i] = false;
    menuClockFast[i] = false;
  }
  if(exprCount < exprDelay)
    exprCount++;
  else 
    exprCount = 0;
  if(tapCheckOn) {
    checkTapTempo();
  }
  midiInst.read();

  if(readMatrixFlag && readMatrixCount < readMatrixDelay) {
    readMatrixCount += 1;
  } else if(readMatrixFlag) {
    readMatrixFlag = false;
    readMatrixCount = 0;
    readLoopConn();  
  }

  if(loopMove) {
    loopOrderCount++;
    if(loopOrderCount == loopOrderDelay) {
      loopOrderCount = 0;
      loopMoveFlag = !loopMoveFlag; 
      externalDisplayRefresh = true;
    }
  } else {
    if(!loopMoveFlag)
      externalDisplayRefresh = true;
    loopMoveFlag = true; 
  }

  delay(loopDelay);
}
