RolandMueller1994/ControllerV2/(commit log)

2022-10-18 Inital commit
    [ControllerMainV2.csv, ControllerMainV2.kicad_sch, ControllerMainV2.ods, ControllerMainV2.sch, ControllerMainV2_2.ods, DisplayPCB.csv, DisplayPCB.kicad_pcb, DisplayPCB.kicad_sch]
2022-10-19 Fixed interrupt logic
2022-11-27 Loop order fixed and tested, run display with loop order, reset changed for stereo loops, stereo loop change fixed
    [controllerv2_1.ino]
2022-12-03 First audio path activate. Parallel and phase reverse already implements
    [controllerv2_1.ino]
2022-12-08 Flipped version for drill
2022-12-08 Fixed wrong menu transistion due to array point overflow
    [controllerv2_1.ino]
2022-12-17 Modified MCP lib. Control leds working
2022-12-18 Changed switch pcb left to 9V led supply
    [switchpcb_v2_left.kicad_pcb, switchpcb_v2_left.kicad_sch]
2022-12-18 Added 9V supply on PSU for LEDs on switch. Changed FRAM supply
    [PSU_Prozessor.kicad_pcb, PSU_Prozessor.kicad_sch]
2022-12-18 Changed FRAM pinout, 9V center negative
    [PSU_Prozessor.kicad_pcb]
2022-12-29 Added libs
    [ControllerMainV2.kicad_sch, Input.kicad_sch, LoopJacks.kicad_sch, Outputs.kicad_sch, PSU_Prozessor.kicad_pcb, SwitchMatrix.kicad_sch, remote.kicad_sch]
2023-01-02 Changed paths for linux
    [DisplayPCB.kicad_sch]
2023-01-03 Main mostly wired. Push for replacement
    [ControllerMainV2.kicad_pcb, ControllerMainV2.kicad_sch, Input.kicad_sch, LoopJacks.kicad_sch, Outputs.kicad_sch, SwitchMatrix.kicad_sch, UnityMixer.kicad_sch, remote.kicad_sch]
